F-Izcue-223/Proyecto-3-Arquitectura-de-Computadores/sim_asic/postsynth/traza_netlist.txt

TRACE cyc=0 led=0000 seg1=0111111 seg2=0111111
TRACE cyc=287 led=0101 seg1=0111111 seg2=0111111
TRACE cyc=2303 led=1010 seg1=0111111 seg2=0111111
TRACE cyc=3602 led=1111 seg1=0111111 seg2=0111111
TRACE cyc=24289 led=0100 seg1=0111111 seg2=0111111
TRACE cyc=27873 led=0100 seg1=0111111 seg2=1001111
TRACE cyc=27887 led=1111 seg1=0111111 seg2=1001111
TRACE cyc=48584 led=0100 seg1=0111111 seg2=1001111
TRACE cyc=56206 led=0100 seg1=0111111 seg2=0000111
TRACE cyc=56220 led=1111 seg1=0111111 seg2=0000111
TRACE cyc=76913 led=0100 seg1=0111111 seg2=0000111
TRACE cyc=77933 led=0100 seg1=1111001 seg2=1111001
TRACE cyc=77940 led=1111 seg1=1111001 seg2=1111001
TRACE cyc=98643 led=1000 seg1=1111001 seg2=1111001
TRACE cyc=111317 led=1000 seg1=0000110 seg2=1011011
TRACE cyc=111331 led=1111 seg1=0000110 seg2=1011011
TRACE cyc=132005 led=0001 seg1=0000110 seg2=1011011
TRACE cyc=137611 led=0001 seg1=0111111 seg2=1101101
TRACE cyc=137625 led=1111 seg1=0111111 seg2=1101101
TRACE cyc=158309 led=0010 seg1=0111111 seg2=1101101
TRACE cyc=280028 led=0010 seg1=1101111 seg2=1101111
TRACE cyc=280042 led=1111 seg1=1101111 seg2=1101111
TRACE cyc=300737 led=0100 seg1=1101111 seg2=1101111
TRACE cyc=302305 led=0100 seg1=0111111 seg2=0000110
TRACE cyc=302319 led=1111 seg1=0111111 seg2=0000110
TRACE cyc=324569 led=0100 seg1=0111111 seg2=0000110
TRACE cyc=340270 led=0100 seg1=0000110 seg2=1101101
TRACE cyc=340284 led=1111 seg1=0000110 seg2=1101101
TRACE cyc=360977 led=0100 seg1=0000110 seg2=1101101
TRACE cyc=365572 led=0100 seg1=0111111 seg2=1100110
TRACE cyc=365586 led=1111 seg1=0111111 seg2=1100110
TRACE cyc=386286 led=1000 seg1=0111111 seg2=1100110
TRACE cyc=394919 led=1000 seg1=0111111 seg2=1111111
TRACE cyc=394933 led=1111 seg1=0111111 seg2=1111111
TRACE cyc=415609 led=0001 seg1=0111111 seg2=1111111
TRACE cyc=422220 led=0001 seg1=0111111 seg2=1111101
TRACE cyc=422231 led=0000 seg1=0111111 seg2=1111101
TRACE cyc=442466 led=0000 seg1=0000110 seg2=1111111
TRACE cyc=442718 led=0101 seg1=0000110 seg2=1111111
TRACE cyc=444734 led=1010 seg1=0000110 seg2=1111111
TRACE cyc=446735 led=0101 seg1=0000110 seg2=1111111
TRACE cyc=448736 led=1010 seg1=0000110 seg2=1111111
TRACE cyc=450553 led=1010 seg1=0111111 seg2=0111111
TRACE cyc=450560 led=1111 seg1=0111111 seg2=0111111
TRACE cyc=471233 led=0001 seg1=0111111 seg2=0111111
TRACE cyc=473812 led=0001 seg1=0111111 seg2=1011011
TRACE cyc=473826 led=1111 seg1=0111111 seg2=1011011
TRACE cyc=494522 led=0100 seg1=0111111 seg2=1011011
TRACE cyc=497115 led=1111 seg1=0111111 seg2=1011011
TRACE cyc=517810 led=0100 seg1=0111111 seg2=1011011
TRACE cyc=520403 led=1111 seg1=0111111 seg2=1011011
TRACE cyc=541097 led=0100 seg1=0111111 seg2=1011011
TRACE cyc=543690 led=1111 seg1=0111111 seg2=1011011
TRACE cyc=564373 led=0010 seg1=0111111 seg2=1011011
TRACE cyc=566966 led=1111 seg1=0111111 seg2=1011011
TRACE cyc=587668 led=1000 seg1=0111111 seg2=1011011
TRACE cyc=590261 led=1111 seg1=0111111 seg2=1011011
TRACE cyc=610951 led=0100 seg1=0111111 seg2=1011011
TRACE cyc=613544 led=1111 seg1=0111111 seg2=1011011
TRACE cyc=634236 led=0010 seg1=0111111 seg2=1011011
TRACE cyc=636829 led=1111 seg1=0111111 seg2=1011011
TRACE cyc=657507 led=0001 seg1=0111111 seg2=1011011
TRACE cyc=660100 led=1111 seg1=0111111 seg2=1011011
TRACE cyc=680804 led=1000 seg1=0111111 seg2=1011011
TRACE cyc=683394 led=0000 seg1=0111111 seg2=1011011
TRACE cyc=703728 led=0101 seg1=0111111 seg2=1011011
