F-Izcue-223/Proyecto-3-Arquitectura-de-Computadores/resultados/resumen_corridas.csv

run | estado | CLOCK_PERIOD_ns | FP_CORE_UTIL | setup_WNS_ns | setup_TNS_ns | hold_WNS_ns | hold_TNS_ns | setup_violaciones | hold_violaciones | celdas | area_celdas_um2 | utilizacion_% | area_core_um2 | area_die_um2 | area_die_mm2 | costo_USD | DRC_klayout | DRC_magic | LVS_errores | antena_nets | antena_pines | potencia_W
clk_50ns | completa | 50 | 40 | -14.45718963242624 | -6568.718803703571 | 0.12987666865137543 | 0 | 2466 | 0 | 22172 | 404698 | 51.3604 | 404698.29120000004 | 435829.97362500004 | 0.43582997362500003 | 10024.089393375001 |  | 0 | 0 | 0 | 0 | 0.036392975598573685
clk_60ns | completa | 60 | 40 | -5.128534186932031 | -444.5563616391733 | 0.12987655762906983 | 0 | 323 | 0 | 22172 | 404698 | 51.361999999999995 | 404698.29120000004 | 435829.97362500004 | 0.43582997362500003 | 10024.089393375001 |  | 0 | 0 | 0 | 0 | 0.030353523790836334
clk_70ns | completa | 70 | 40 | 4.871466923291026 | 0 | 0.12987655762906983 | 0 | 0 | 0 | 22172 | 404698 | 51.361999999999995 | 404698.29120000004 | 435829.97362500004 | 0.43582997362500003 | 10024.089393375001 |  | 0 | 0 | 0 | 0 | 0.026017645373940468
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
