F-Izcue-223/Proyecto-3-Arquitectura-de-Computadores/resultados/clk_50ns/metrics.csv

Metric | Value
design__lint_error__count | 0
design__lint_timing_construct__count | 0
design__lint_warning__count | 15
design__inferred_latch__count | 0
design__instance__count | 22172
design__instance__area | 404698
design__instance_unmapped__count | 0
synthesis__check_error__count | 0
design__max_slew_violation__count__corner:nom_tt_025C_5v00 | 61
design__max_fanout_violation__count__corner:nom_tt_025C_5v00 | 70
design__max_cap_violation__count__corner:nom_tt_025C_5v00 | 6
power__internal__total | 0.024726830422878265
power__switching__total | 0.011663719080388546
power__leakage__total | 0.000002424630338282441
power__total | 0.036392975598573685
clock__skew__worst_hold__corner:nom_tt_025C_5v00 | -0.5467498830657567
clock__skew__worst_setup__corner:nom_tt_025C_5v00 | 0.3931717562807261
timing__hold__ws__corner:nom_tt_025C_5v00 | 0.3716260737661064
timing__setup__ws__corner:nom_tt_025C_5v00 | 16.08947687288801
timing__hold__tns__corner:nom_tt_025C_5v00 | 0.0
timing__setup__tns__corner:nom_tt_025C_5v00 | 0.0
timing__hold__wns__corner:nom_tt_025C_5v00 | 0
timing__setup__wns__corner:nom_tt_025C_5v00 | 0.0
timing__hold_vio__count__corner:nom_tt_025C_5v00 | 0
timing__hold_r2r__ws__corner:nom_tt_025C_5v00 | 0.371626
timing__hold_r2r_vio__count__corner:nom_tt_025C_5v00 | 0
timing__setup_vio__count__corner:nom_tt_025C_5v00 | 0
timing__setup_r2r__ws__corner:nom_tt_025C_5v00 | 16.089478
timing__setup_r2r_vio__count__corner:nom_tt_025C_5v00 | 0
design__max_slew_violation__count__corner:nom_ss_125C_4v50 | 2127
design__max_fanout_violation__count__corner:nom_ss_125C_4v50 | 70
design__max_cap_violation__count__corner:nom_ss_125C_4v50 | 6
clock__skew__worst_hold__corner:nom_ss_125C_4v50 | -0.7719962665419072
clock__skew__worst_setup__corner:nom_ss_125C_4v50 | 0.5001695865718078
timing__hold__ws__corner:nom_ss_125C_4v50 | 0.9307308520662195
timing__setup__ws__corner:nom_ss_125C_4v50 | -11.815292190169219
timing__hold__tns__corner:nom_ss_125C_4v50 | 0.0
timing__setup__tns__corner:nom_ss_125C_4v50 | -4608.067814200619
timing__hold__wns__corner:nom_ss_125C_4v50 | 0
timing__setup__wns__corner:nom_ss_125C_4v50 | -11.815292190169219
timing__hold_vio__count__corner:nom_ss_125C_4v50 | 0
timing__hold_r2r__ws__corner:nom_ss_125C_4v50 | 0.930731
timing__hold_r2r_vio__count__corner:nom_ss_125C_4v50 | 0
timing__setup_vio__count__corner:nom_ss_125C_4v50 | 830
timing__setup_r2r__ws__corner:nom_ss_125C_4v50 | -11.815292
timing__setup_r2r_vio__count__corner:nom_ss_125C_4v50 | 830
design__max_slew_violation__count__corner:nom_ff_n40C_5v50 | 0
design__max_fanout_violation__count__corner:nom_ff_n40C_5v50 | 70
design__max_cap_violation__count__corner:nom_ff_n40C_5v50 | 6
clock__skew__worst_hold__corner:nom_ff_n40C_5v50 | -0.4449608862866247
clock__skew__worst_setup__corner:nom_ff_n40C_5v50 | 0.3442841387205945
timing__hold__ws__corner:nom_ff_n40C_5v50 | 0.132141301641054
timing__setup__ws__corner:nom_ff_n40C_5v50 | 28.584779796693734
timing__hold__tns__corner:nom_ff_n40C_5v50 | 0.0
timing__setup__tns__corner:nom_ff_n40C_5v50 | 0.0
timing__hold__wns__corner:nom_ff_n40C_5v50 | 0
timing__setup__wns__corner:nom_ff_n40C_5v50 | 0.0
timing__hold_vio__count__corner:nom_ff_n40C_5v50 | 0
timing__hold_r2r__ws__corner:nom_ff_n40C_5v50 | 0.132141
timing__hold_r2r_vio__count__corner:nom_ff_n40C_5v50 | 0
timing__setup_vio__count__corner:nom_ff_n40C_5v50 | 0
timing__setup_r2r__ws__corner:nom_ff_n40C_5v50 | 28.584780
timing__setup_r2r_vio__count__corner:nom_ff_n40C_5v50 | 0
design__max_slew_violation__count | 2684
design__max_fanout_violation__count | 70
design__max_cap_violation__count | 15
clock__skew__worst_hold | -0.4385141540672078
clock__skew__worst_setup | 0.33689438303739044
timing__hold__ws | 0.12987666865137543
timing__setup__ws | -14.45718963242624
timing__hold__tns | 0.0
timing__setup__tns | -6568.718803703571
timing__hold__wns | 0
timing__setup__wns | -14.45718963242624
timing__hold_vio__count | 0
timing__hold_r2r__ws | 0.129877
timing__hold_r2r_vio__count | 0
timing__setup_vio__count | 2466
timing__setup_r2r__ws | -14.457190
timing__setup_r2r_vio__count | 2466
design__die__bbox | 0.0 0.0 651.275 669.195
design__core__bbox | 6.72 15.68 644.0 650.72
design__io | 30
design__die__area | 435830
design__core__area | 404698
design__instance__count__stdcell | 9465
design__instance__area__stdcell | 207855
design__instance__count__macros | 0
design__instance__area__macros | 0
design__instance__count__padcells | 0
design__instance__area__padcells | 0
design__instance__count__cover | 0
design__instance__area__cover | 0
design__instance__utilization | 0.513604
design__instance__utilization__stdcell | 0.513604
design__rows | 162
design__rows:GF018hv5v_mcu_sc7 | 162
design__sites | 184356
design__sites:GF018hv5v_mcu_sc7 | 184356
design__instance__count__class:tie_cell | 1
design__instance__area__class:tie_cell | 8.7808
design__instance__count__class:inverter | 295
design__instance__area__class:inverter | 2590.34
design__instance__count__class:sequential_cell | 1069
design__instance__area__class:sequential_cell | 70250.8
design__instance__count__class:multi_input_combinational_cell | 4202
design__instance__area__class:multi_input_combinational_cell | 89911
flow__warnings__count | 1
flow__errors__count | 0
flow__warnings__count:ODB-0220 | 1
flow__warnings__type_count | 1
flow__warnings__count:ORD-0039 | 1
design__instance__count__class:endcap_cell | 324
design__instance__area__class:endcap_cell | 1422.49
design__instance__count__class:tap_cell | 2626
design__instance__area__class:tap_cell | 11529.2
design__power_grid_violation__count__net:VSS | 0
design__power_grid_violation__count__net:VDD | 0
design__power_grid_violation__count | 0
flow__warnings__count:GRT-0281 | 1
timing__drv__floating__nets | 2
timing__drv__floating__pins | 0
design__instance__displacement__total | 62.2625
design__instance__displacement__mean | 0.0065
design__instance__displacement__max | 10.82
route__wirelength__estimated | 343721
design__violations | 0
design__instance__count__class:timing_repair_buffer | 792
design__instance__area__class:timing_repair_buffer | 25666.3
flow__warnings__count:RSZ-0020 | 1
flow__warnings__count:STA-1140 | 6
design__instance__count__class:clock_buffer | 107
design__instance__area__class:clock_buffer | 5830.45
design__instance__count__class:clock_inverter | 36
design__instance__area__class:clock_inverter | 588.314
design__instance__count__setup_buffer | 0
design__instance__count__hold_buffer | 7
global_route__vias | 183
global_route__wirelength | 554820
antenna__violating__nets | 0
antenna__violating__pins | 0
route__antenna_violation__count | 0
antenna_diodes_count | 10
design__instance__count__class:antenna_cell | 13
design__instance__area__class:antenna_cell | 57.0752
route__net | 6448
route__net__special | 2
route__drc_errors__iter:0 | 233
route__wirelength__iter:0 | 404524
route__drc_errors__iter:1 | 16
route__wirelength__iter:1 | 404425
route__drc_errors__iter:2 | 14
route__wirelength__iter:2 | 404420
route__drc_errors__iter:3 | 0
route__wirelength__iter:3 | 404354
route__drc_errors__iter:4 | 0
route__wirelength__iter:4 | 404287
route__drc_errors | 0
route__wirelength | 404354
route__vias | 47702
route__vias__singlecut | 47702
route__vias__multicut | 0
flow__warnings__count:DRT-0349 | 8
design__disconnected_pin__count | 0
design__critical_disconnected_pin__count | 0
route__wirelength__max | 1407.27
design__instance__count__class:fill_cell | 12707
design__instance__area__class:fill_cell | 196844
timing__unannotated_net__count__corner:nom_tt_025C_5v00 | 63
timing__unannotated_net_filtered__count__corner:nom_tt_025C_5v00 | 0
timing__unannotated_net__count__corner:nom_ss_125C_4v50 | 63
timing__unannotated_net_filtered__count__corner:nom_ss_125C_4v50 | 0
timing__unannotated_net__count__corner:nom_ff_n40C_5v50 | 63
timing__unannotated_net_filtered__count__corner:nom_ff_n40C_5v50 | 0
design__max_slew_violation__count__corner:min_tt_025C_5v00 | 16
design__max_fanout_violation__count__corner:min_tt_025C_5v00 | 70
design__max_cap_violation__count__corner:min_tt_025C_5v00 | 3
clock__skew__worst_hold__corner:min_tt_025C_5v00 | -0.5372785701748124
clock__skew__worst_setup__corner:min_tt_025C_5v00 | 0.38218737589787904
timing__hold__ws__corner:min_tt_025C_5v00 | 0.3684447295990685
timing__setup__ws__corner:min_tt_025C_5v00 | 17.364194129606773
timing__hold__tns__corner:min_tt_025C_5v00 | 0.0
timing__setup__tns__corner:min_tt_025C_5v00 | 0.0
timing__hold__wns__corner:min_tt_025C_5v00 | 0
timing__setup__wns__corner:min_tt_025C_5v00 | 0.0
timing__hold_vio__count__corner:min_tt_025C_5v00 | 0
timing__hold_r2r__ws__corner:min_tt_025C_5v00 | 0.368445
timing__hold_r2r_vio__count__corner:min_tt_025C_5v00 | 0
timing__setup_vio__count__corner:min_tt_025C_5v00 | 0
timing__setup_r2r__ws__corner:min_tt_025C_5v00 | 17.364195
timing__setup_r2r_vio__count__corner:min_tt_025C_5v00 | 0
timing__unannotated_net__count__corner:min_tt_025C_5v00 | 63
timing__unannotated_net_filtered__count__corner:min_tt_025C_5v00 | 0
design__max_slew_violation__count__corner:min_ss_125C_4v50 | 1710
design__max_fanout_violation__count__corner:min_ss_125C_4v50 | 70
design__max_cap_violation__count__corner:min_ss_125C_4v50 | 3
clock__skew__worst_hold__corner:min_ss_125C_4v50 | -0.7560401407807243
clock__skew__worst_setup__corner:min_ss_125C_4v50 | 0.4814059287465504
timing__hold__ws__corner:min_ss_125C_4v50 | 0.9253560402073941
timing__setup__ws__corner:min_ss_125C_4v50 | -9.604775913133484
timing__hold__tns__corner:min_ss_125C_4v50 | 0.0
timing__setup__tns__corner:min_ss_125C_4v50 | -2988.5528355707474
timing__hold__wns__corner:min_ss_125C_4v50 | 0
timing__setup__wns__corner:min_ss_125C_4v50 | -9.604775913133484
timing__hold_vio__count__corner:min_ss_125C_4v50 | 0
timing__hold_r2r__ws__corner:min_ss_125C_4v50 | 0.925356
timing__hold_r2r_vio__count__corner:min_ss_125C_4v50 | 0
timing__setup_vio__count__corner:min_ss_125C_4v50 | 804
timing__setup_r2r__ws__corner:min_ss_125C_4v50 | -9.604776
timing__setup_r2r_vio__count__corner:min_ss_125C_4v50 | 804
timing__unannotated_net__count__corner:min_ss_125C_4v50 | 63
timing__unannotated_net_filtered__count__corner:min_ss_125C_4v50 | 0
design__max_slew_violation__count__corner:min_ff_n40C_5v50 | 0
design__max_fanout_violation__count__corner:min_ff_n40C_5v50 | 70
design__max_cap_violation__count__corner:min_ff_n40C_5v50 | 2
clock__skew__worst_hold__corner:min_ff_n40C_5v50 | -0.4385141540672078
clock__skew__worst_setup__corner:min_ff_n40C_5v50 | 0.33689438303739044
timing__hold__ws__corner:min_ff_n40C_5v50 | 0.12987666865137543
timing__setup__ws__corner:min_ff_n40C_5v50 | 29.422921820645907
timing__hold__tns__corner:min_ff_n40C_5v50 | 0.0
timing__setup__tns__corner:min_ff_n40C_5v50 | 0.0
timing__hold__wns__corner:min_ff_n40C_5v50 | 0
timing__setup__wns__corner:min_ff_n40C_5v50 | 0.0
timing__hold_vio__count__corner:min_ff_n40C_5v50 | 0
timing__hold_r2r__ws__corner:min_ff_n40C_5v50 | 0.129877
timing__hold_r2r_vio__count__corner:min_ff_n40C_5v50 | 0
timing__setup_vio__count__corner:min_ff_n40C_5v50 | 0
timing__setup_r2r__ws__corner:min_ff_n40C_5v50 | 29.422922
timing__setup_r2r_vio__count__corner:min_ff_n40C_5v50 | 0
timing__unannotated_net__count__corner:min_ff_n40C_5v50 | 63
timing__unannotated_net_filtered__count__corner:min_ff_n40C_5v50 | 0
design__max_slew_violation__count__corner:max_tt_025C_5v00 | 107
design__max_fanout_violation__count__corner:max_tt_025C_5v00 | 70
design__max_cap_violation__count__corner:max_tt_025C_5v00 | 15
clock__skew__worst_hold__corner:max_tt_025C_5v00 | -0.5583274001162848
clock__skew__worst_setup__corner:max_tt_025C_5v00 | 0.406510642209637
timing__hold__ws__corner:max_tt_025C_5v00 | 0.37550308370004926
timing__setup__ws__corner:max_tt_025C_5v00 | 14.570059349193906
timing__hold__tns__corner:max_tt_025C_5v00 | 0.0
timing__setup__tns__corner:max_tt_025C_5v00 | 0.0
timing__hold__wns__corner:max_tt_025C_5v00 | 0
timing__setup__wns__corner:max_tt_025C_5v00 | 0.0
timing__hold_vio__count__corner:max_tt_025C_5v00 | 0
timing__hold_r2r__ws__corner:max_tt_025C_5v00 | 0.375503
timing__hold_r2r_vio__count__corner:max_tt_025C_5v00 | 0
timing__setup_vio__count__corner:max_tt_025C_5v00 | 0
timing__setup_r2r__ws__corner:max_tt_025C_5v00 | 14.570060
timing__setup_r2r_vio__count__corner:max_tt_025C_5v00 | 0
timing__unannotated_net__count__corner:max_tt_025C_5v00 | 63
timing__unannotated_net_filtered__count__corner:max_tt_025C_5v00 | 0
design__max_slew_violation__count__corner:max_ss_125C_4v50 | 2684
design__max_fanout_violation__count__corner:max_ss_125C_4v50 | 70
design__max_cap_violation__count__corner:max_ss_125C_4v50 | 15
clock__skew__worst_hold__corner:max_ss_125C_4v50 | -0.7915113233314819
clock__skew__worst_setup__corner:max_ss_125C_4v50 | 0.5228932990155986
timing__hold__ws__corner:max_ss_125C_4v50 | 0.9372953789518806
timing__setup__ws__corner:max_ss_125C_4v50 | -14.45718963242624
timing__hold__tns__corner:max_ss_125C_4v50 | 0.0
timing__setup__tns__corner:max_ss_125C_4v50 | -6568.718803703571
timing__hold__wns__corner:max_ss_125C_4v50 | 0
timing__setup__wns__corner:max_ss_125C_4v50 | -14.45718963242624
timing__hold_vio__count__corner:max_ss_125C_4v50 | 0
timing__hold_r2r__ws__corner:max_ss_125C_4v50 | 0.937295
timing__hold_r2r_vio__count__corner:max_ss_125C_4v50 | 0
timing__setup_vio__count__corner:max_ss_125C_4v50 | 832
timing__setup_r2r__ws__corner:max_ss_125C_4v50 | -14.457190
timing__setup_r2r_vio__count__corner:max_ss_125C_4v50 | 832
timing__unannotated_net__count__corner:max_ss_125C_4v50 | 63
timing__unannotated_net_filtered__count__corner:max_ss_125C_4v50 | 0
design__max_slew_violation__count__corner:max_ff_n40C_5v50 | 3
design__max_fanout_violation__count__corner:max_ff_n40C_5v50 | 70
design__max_cap_violation__count__corner:max_ff_n40C_5v50 | 14
clock__skew__worst_hold__corner:max_ff_n40C_5v50 | -0.452895705979184
clock__skew__worst_setup__corner:max_ff_n40C_5v50 | 0.3532923775748709
timing__hold__ws__corner:max_ff_n40C_5v50 | 0.13489165721774327
timing__setup__ws__corner:max_ff_n40C_5v50 | 27.58315254276052
timing__hold__tns__corner:max_ff_n40C_5v50 | 0.0
timing__setup__tns__corner:max_ff_n40C_5v50 | 0.0
timing__hold__wns__corner:max_ff_n40C_5v50 | 0
timing__setup__wns__corner:max_ff_n40C_5v50 | 0.0
timing__hold_vio__count__corner:max_ff_n40C_5v50 | 0
timing__hold_r2r__ws__corner:max_ff_n40C_5v50 | 0.134892
timing__hold_r2r_vio__count__corner:max_ff_n40C_5v50 | 0
timing__setup_vio__count__corner:max_ff_n40C_5v50 | 0
timing__setup_r2r__ws__corner:max_ff_n40C_5v50 | 27.583153
timing__setup_r2r_vio__count__corner:max_ff_n40C_5v50 | 0
timing__unannotated_net__count__corner:max_ff_n40C_5v50 | 63
timing__unannotated_net_filtered__count__corner:max_ff_n40C_5v50 | 0
timing__unannotated_net__count | 63
timing__unannotated_net_filtered__count | 0
design_powergrid__voltage__worst__net:VDD__corner:nom_tt_025C_5v00 | 4.99957
design_powergrid__drop__average__net:VDD__corner:nom_tt_025C_5v00 | 4.99993
design_powergrid__drop__worst__net:VDD__corner:nom_tt_025C_5v00 | 0.000428672
design_powergrid__voltage__worst__net:VSS__corner:nom_tt_025C_5v00 | 0.00037218
design_powergrid__drop__average__net:VSS__corner:nom_tt_025C_5v00 | 0.0000679015
design_powergrid__drop__worst__net:VSS__corner:nom_tt_025C_5v00 | 0.00037218
design_powergrid__voltage__worst | 0.00037218
design_powergrid__voltage__worst__net:VDD | 4.99957
design_powergrid__drop__worst | 0.000428672
design_powergrid__drop__worst__net:VDD | 0.000428672
design_powergrid__voltage__worst__net:VSS | 0.00037218
design_powergrid__drop__worst__net:VSS | 0.00037218
ir__voltage__worst | 5
ir__drop__avg | 0.0000694000000000000063886396173273851673002354800701141357421875
ir__drop__worst | 0.000429000000000000019338697310189445488504134118556976318359375
design__xor_difference__count | 0
magic__drc_error__count | 0
magic__illegal_overlap__count | 0
design__lvs_device_difference__count | 0
design__lvs_net_difference__count | 0
design__lvs_property_fail__count | 0
design__lvs_error__count | 0
design__lvs_unmatched_device__count | 0
design__lvs_unmatched_net__count | 0
design__lvs_unmatched_pin__count | 0
