F-Izcue-223/Proyecto-3-Arquitectura-de-Computadores/resultados/clk_60ns/metrics.csv

Metric | Value
design__lint_error__count | 0
design__lint_timing_construct__count | 0
design__lint_warning__count | 15
design__inferred_latch__count | 0
design__instance__count | 22172
design__instance__area | 404698
design__instance_unmapped__count | 0
synthesis__check_error__count | 0
design__max_slew_violation__count__corner:nom_tt_025C_5v00 | 37
design__max_fanout_violation__count__corner:nom_tt_025C_5v00 | 70
design__max_cap_violation__count__corner:nom_tt_025C_5v00 | 4
power__internal__total | 0.020613091066479683
power__switching__total | 0.009738006629049778
power__leakage__total | 0.0000024245998702099314
power__total | 0.030353523790836334
clock__skew__worst_hold__corner:nom_tt_025C_5v00 | -0.5478765374230102
clock__skew__worst_setup__corner:nom_tt_025C_5v00 | 0.4015394519428293
timing__hold__ws__corner:nom_tt_025C_5v00 | 0.3716260737661064
timing__setup__ws__corner:nom_tt_025C_5v00 | 25.759565876139742
timing__hold__tns__corner:nom_tt_025C_5v00 | 0.0
timing__setup__tns__corner:nom_tt_025C_5v00 | 0.0
timing__hold__wns__corner:nom_tt_025C_5v00 | 0
timing__setup__wns__corner:nom_tt_025C_5v00 | 0.0
timing__hold_vio__count__corner:nom_tt_025C_5v00 | 0
timing__hold_r2r__ws__corner:nom_tt_025C_5v00 | 0.371626
timing__hold_r2r_vio__count__corner:nom_tt_025C_5v00 | 0
timing__setup_vio__count__corner:nom_tt_025C_5v00 | 0
timing__setup_r2r__ws__corner:nom_tt_025C_5v00 | 25.759565
timing__setup_r2r_vio__count__corner:nom_tt_025C_5v00 | 0
design__max_slew_violation__count__corner:nom_ss_125C_4v50 | 2171
design__max_fanout_violation__count__corner:nom_ss_125C_4v50 | 70
design__max_cap_violation__count__corner:nom_ss_125C_4v50 | 4
clock__skew__worst_hold__corner:nom_ss_125C_4v50 | -0.7737251058847484
clock__skew__worst_setup__corner:nom_ss_125C_4v50 | 0.5124133484782561
timing__hold__ws__corner:nom_ss_125C_4v50 | 0.9307306300216083
timing__setup__ws__corner:nom_ss_125C_4v50 | -2.5725982072784226
timing__hold__tns__corner:nom_ss_125C_4v50 | 0.0
timing__setup__tns__corner:nom_ss_125C_4v50 | -20.61971629582071
timing__hold__wns__corner:nom_ss_125C_4v50 | 0
timing__setup__wns__corner:nom_ss_125C_4v50 | -2.5725982072784226
timing__hold_vio__count__corner:nom_ss_125C_4v50 | 0
timing__hold_r2r__ws__corner:nom_ss_125C_4v50 | 0.930731
timing__hold_r2r_vio__count__corner:nom_ss_125C_4v50 | 0
timing__setup_vio__count__corner:nom_ss_125C_4v50 | 30
timing__setup_r2r__ws__corner:nom_ss_125C_4v50 | -2.572598
timing__setup_r2r_vio__count__corner:nom_ss_125C_4v50 | 30
design__max_slew_violation__count__corner:nom_ff_n40C_5v50 | 0
design__max_fanout_violation__count__corner:nom_ff_n40C_5v50 | 70
design__max_cap_violation__count__corner:nom_ff_n40C_5v50 | 4
clock__skew__worst_hold__corner:nom_ff_n40C_5v50 | -0.44580304598577203
clock__skew__worst_setup__corner:nom_ff_n40C_5v50 | 0.35087775345032346
timing__hold__ws__corner:nom_ff_n40C_5v50 | 0.132141301641054
timing__setup__ws__corner:nom_ff_n40C_5v50 | 38.42738858106721
timing__hold__tns__corner:nom_ff_n40C_5v50 | 0.0
timing__setup__tns__corner:nom_ff_n40C_5v50 | 0.0
timing__hold__wns__corner:nom_ff_n40C_5v50 | 0
timing__setup__wns__corner:nom_ff_n40C_5v50 | 0.0
timing__hold_vio__count__corner:nom_ff_n40C_5v50 | 0
timing__hold_r2r__ws__corner:nom_ff_n40C_5v50 | 0.132141
timing__hold_r2r_vio__count__corner:nom_ff_n40C_5v50 | 0
timing__setup_vio__count__corner:nom_ff_n40C_5v50 | 0
timing__setup_r2r__ws__corner:nom_ff_n40C_5v50 | 38.427387
timing__setup_r2r_vio__count__corner:nom_ff_n40C_5v50 | 0
design__max_slew_violation__count | 2727
design__max_fanout_violation__count | 70
design__max_cap_violation__count | 14
clock__skew__worst_hold | -0.43925278546638086
clock__skew__worst_setup | 0.34277567865437414
timing__hold__ws | 0.12987655762906983
timing__setup__ws | -5.128534186932031
timing__hold__tns | 0.0
timing__setup__tns | -444.5563616391733
timing__hold__wns | 0
timing__setup__wns | -5.128534186932031
timing__hold_vio__count | 0
timing__hold_r2r__ws | 0.129877
timing__hold_r2r_vio__count | 0
timing__setup_vio__count | 323
timing__setup_r2r__ws | -5.128534
timing__setup_r2r_vio__count | 323
design__die__bbox | 0.0 0.0 651.275 669.195
design__core__bbox | 6.72 15.68 644.0 650.72
design__io | 30
design__die__area | 435830
design__core__area | 404698
design__instance__count__stdcell | 9464
design__instance__area__stdcell | 207861
design__instance__count__macros | 0
design__instance__area__macros | 0
design__instance__count__padcells | 0
design__instance__area__padcells | 0
design__instance__count__cover | 0
design__instance__area__cover | 0
design__instance__utilization | 0.51362
design__instance__utilization__stdcell | 0.51362
design__rows | 162
design__rows:GF018hv5v_mcu_sc7 | 162
design__sites | 184356
design__sites:GF018hv5v_mcu_sc7 | 184356
design__instance__count__class:tie_cell | 1
design__instance__area__class:tie_cell | 8.7808
design__instance__count__class:inverter | 295
design__instance__area__class:inverter | 2590.34
design__instance__count__class:sequential_cell | 1069
design__instance__area__class:sequential_cell | 70250.8
design__instance__count__class:multi_input_combinational_cell | 4202
design__instance__area__class:multi_input_combinational_cell | 89911
flow__warnings__count | 1
flow__errors__count | 0
flow__warnings__count:ODB-0220 | 1
flow__warnings__type_count | 1
flow__warnings__count:ORD-0039 | 1
design__instance__count__class:endcap_cell | 324
design__instance__area__class:endcap_cell | 1422.49
design__instance__count__class:tap_cell | 2626
design__instance__area__class:tap_cell | 11529.2
design__power_grid_violation__count__net:VSS | 0
design__power_grid_violation__count__net:VDD | 0
design__power_grid_violation__count | 0
flow__warnings__count:GRT-0281 | 1
timing__drv__floating__nets | 2
timing__drv__floating__pins | 0
design__instance__displacement__total | 62.2625
design__instance__displacement__mean | 0.0065
design__instance__displacement__max | 10.82
route__wirelength__estimated | 343723
design__violations | 0
design__instance__count__class:timing_repair_buffer | 792
design__instance__area__class:timing_repair_buffer | 25677.3
flow__warnings__count:RSZ-0020 | 1
flow__warnings__count:STA-1140 | 6
design__instance__count__class:clock_buffer | 107
design__instance__area__class:clock_buffer | 5830.45
design__instance__count__class:clock_inverter | 36
design__instance__area__class:clock_inverter | 588.314
design__instance__count__setup_buffer | 0
design__instance__count__hold_buffer | 7
global_route__vias | 162
global_route__wirelength | 554820
antenna__violating__nets | 0
antenna__violating__pins | 0
route__antenna_violation__count | 0
antenna_diodes_count | 9
design__instance__count__class:antenna_cell | 12
design__instance__area__class:antenna_cell | 52.6848
route__net | 6448
route__net__special | 2
route__drc_errors__iter:0 | 177
route__wirelength__iter:0 | 404815
route__drc_errors__iter:1 | 40
route__wirelength__iter:1 | 404751
route__drc_errors__iter:2 | 41
route__wirelength__iter:2 | 404744
route__drc_errors__iter:3 | 0
route__wirelength__iter:3 | 404622
route__drc_errors__iter:4 | 0
route__wirelength__iter:4 | 404539
route__drc_errors | 0
route__wirelength | 404622
route__vias | 47733
route__vias__singlecut | 47733
route__vias__multicut | 0
flow__warnings__count:DRT-0349 | 8
design__disconnected_pin__count | 0
design__critical_disconnected_pin__count | 0
route__wirelength__max | 1398.26
design__instance__count__class:fill_cell | 12708
design__instance__area__class:fill_cell | 196837
timing__unannotated_net__count__corner:nom_tt_025C_5v00 | 63
timing__unannotated_net_filtered__count__corner:nom_tt_025C_5v00 | 0
timing__unannotated_net__count__corner:nom_ss_125C_4v50 | 63
timing__unannotated_net_filtered__count__corner:nom_ss_125C_4v50 | 0
timing__unannotated_net__count__corner:nom_ff_n40C_5v50 | 63
timing__unannotated_net_filtered__count__corner:nom_ff_n40C_5v50 | 0
design__max_slew_violation__count__corner:min_tt_025C_5v00 | 9
design__max_fanout_violation__count__corner:min_tt_025C_5v00 | 70
design__max_cap_violation__count__corner:min_tt_025C_5v00 | 3
clock__skew__worst_hold__corner:min_tt_025C_5v00 | -0.5382509035272786
clock__skew__worst_setup__corner:min_tt_025C_5v00 | 0.3895407717759983
timing__hold__ws__corner:min_tt_025C_5v00 | 0.36844484062137406
timing__setup__ws__corner:min_tt_025C_5v00 | 26.988485099529832
timing__hold__tns__corner:min_tt_025C_5v00 | 0.0
timing__setup__tns__corner:min_tt_025C_5v00 | 0.0
timing__hold__wns__corner:min_tt_025C_5v00 | 0
timing__setup__wns__corner:min_tt_025C_5v00 | 0.0
timing__hold_vio__count__corner:min_tt_025C_5v00 | 0
timing__hold_r2r__ws__corner:min_tt_025C_5v00 | 0.368445
timing__hold_r2r_vio__count__corner:min_tt_025C_5v00 | 0
timing__setup_vio__count__corner:min_tt_025C_5v00 | 0
timing__setup_r2r__ws__corner:min_tt_025C_5v00 | 26.988485
timing__setup_r2r_vio__count__corner:min_tt_025C_5v00 | 0
timing__unannotated_net__count__corner:min_tt_025C_5v00 | 63
timing__unannotated_net_filtered__count__corner:min_tt_025C_5v00 | 0
design__max_slew_violation__count__corner:min_ss_125C_4v50 | 1713
design__max_fanout_violation__count__corner:min_ss_125C_4v50 | 70
design__max_cap_violation__count__corner:min_ss_125C_4v50 | 3
clock__skew__worst_hold__corner:min_ss_125C_4v50 | -0.7575111863299567
clock__skew__worst_setup__corner:min_ss_125C_4v50 | 0.49199290478649355
timing__hold__ws__corner:min_ss_125C_4v50 | 0.9253560402073941
timing__setup__ws__corner:min_ss_125C_4v50 | -0.4361950923922076
timing__hold__tns__corner:min_ss_125C_4v50 | 0.0
timing__setup__tns__corner:min_ss_125C_4v50 | -0.4361950923922076
timing__hold__wns__corner:min_ss_125C_4v50 | 0
timing__setup__wns__corner:min_ss_125C_4v50 | -0.4361950923922076
timing__hold_vio__count__corner:min_ss_125C_4v50 | 0
timing__hold_r2r__ws__corner:min_ss_125C_4v50 | 0.925356
timing__hold_r2r_vio__count__corner:min_ss_125C_4v50 | 0
timing__setup_vio__count__corner:min_ss_125C_4v50 | 1
timing__setup_r2r__ws__corner:min_ss_125C_4v50 | -0.436195
timing__setup_r2r_vio__count__corner:min_ss_125C_4v50 | 1
timing__unannotated_net__count__corner:min_ss_125C_4v50 | 63
timing__unannotated_net_filtered__count__corner:min_ss_125C_4v50 | 0
design__max_slew_violation__count__corner:min_ff_n40C_5v50 | 0
design__max_fanout_violation__count__corner:min_ff_n40C_5v50 | 70
design__max_cap_violation__count__corner:min_ff_n40C_5v50 | 2
clock__skew__worst_hold__corner:min_ff_n40C_5v50 | -0.43925278546638086
clock__skew__worst_setup__corner:min_ff_n40C_5v50 | 0.34277567865437414
timing__hold__ws__corner:min_ff_n40C_5v50 | 0.12987655762906983
timing__setup__ws__corner:min_ff_n40C_5v50 | 39.2388852516748
timing__hold__tns__corner:min_ff_n40C_5v50 | 0.0
timing__setup__tns__corner:min_ff_n40C_5v50 | 0.0
timing__hold__wns__corner:min_ff_n40C_5v50 | 0
timing__setup__wns__corner:min_ff_n40C_5v50 | 0.0
timing__hold_vio__count__corner:min_ff_n40C_5v50 | 0
timing__hold_r2r__ws__corner:min_ff_n40C_5v50 | 0.129877
timing__hold_r2r_vio__count__corner:min_ff_n40C_5v50 | 0
timing__setup_vio__count__corner:min_ff_n40C_5v50 | 0
timing__setup_r2r__ws__corner:min_ff_n40C_5v50 | 39.238884
timing__setup_r2r_vio__count__corner:min_ff_n40C_5v50 | 0
timing__unannotated_net__count__corner:min_ff_n40C_5v50 | 63
timing__unannotated_net_filtered__count__corner:min_ff_n40C_5v50 | 0
design__max_slew_violation__count__corner:max_tt_025C_5v00 | 103
design__max_fanout_violation__count__corner:max_tt_025C_5v00 | 70
design__max_cap_violation__count__corner:max_tt_025C_5v00 | 13
clock__skew__worst_hold__corner:max_tt_025C_5v00 | -0.5596909760736939
clock__skew__worst_setup__corner:max_tt_025C_5v00 | 0.4161236195625299
timing__hold__ws__corner:max_tt_025C_5v00 | 0.3755029726777437
timing__setup__ws__corner:max_tt_025C_5v00 | 24.289122511892987
timing__hold__tns__corner:max_tt_025C_5v00 | 0.0
timing__setup__tns__corner:max_tt_025C_5v00 | 0.0
timing__hold__wns__corner:max_tt_025C_5v00 | 0
timing__setup__wns__corner:max_tt_025C_5v00 | 0.0
timing__hold_vio__count__corner:max_tt_025C_5v00 | 0
timing__hold_r2r__ws__corner:max_tt_025C_5v00 | 0.375503
timing__hold_r2r_vio__count__corner:max_tt_025C_5v00 | 0
timing__setup_vio__count__corner:max_tt_025C_5v00 | 0
timing__setup_r2r__ws__corner:max_tt_025C_5v00 | 24.289122
timing__setup_r2r_vio__count__corner:max_tt_025C_5v00 | 0
timing__unannotated_net__count__corner:max_tt_025C_5v00 | 63
timing__unannotated_net_filtered__count__corner:max_tt_025C_5v00 | 0
design__max_slew_violation__count__corner:max_ss_125C_4v50 | 2727
design__max_fanout_violation__count__corner:max_ss_125C_4v50 | 70
design__max_cap_violation__count__corner:max_ss_125C_4v50 | 14
clock__skew__worst_hold__corner:max_ss_125C_4v50 | -0.793641175242159
clock__skew__worst_setup__corner:max_ss_125C_4v50 | 0.5371603314193458
timing__hold__ws__corner:max_ss_125C_4v50 | 0.9372956009964918
timing__setup__ws__corner:max_ss_125C_4v50 | -5.128534186932031
timing__hold__tns__corner:max_ss_125C_4v50 | 0.0
timing__setup__tns__corner:max_ss_125C_4v50 | -444.5563616391733
timing__hold__wns__corner:max_ss_125C_4v50 | 0
timing__setup__wns__corner:max_ss_125C_4v50 | -5.128534186932031
timing__hold_vio__count__corner:max_ss_125C_4v50 | 0
timing__hold_r2r__ws__corner:max_ss_125C_4v50 | 0.937296
timing__hold_r2r_vio__count__corner:max_ss_125C_4v50 | 0
timing__setup_vio__count__corner:max_ss_125C_4v50 | 292
timing__setup_r2r__ws__corner:max_ss_125C_4v50 | -5.128534
timing__setup_r2r_vio__count__corner:max_ss_125C_4v50 | 292
timing__unannotated_net__count__corner:max_ss_125C_4v50 | 63
timing__unannotated_net_filtered__count__corner:max_ss_125C_4v50 | 0
design__max_slew_violation__count__corner:max_ff_n40C_5v50 | 3
design__max_fanout_violation__count__corner:max_ff_n40C_5v50 | 70
design__max_cap_violation__count__corner:max_ff_n40C_5v50 | 14
clock__skew__worst_hold__corner:max_ff_n40C_5v50 | -0.45391333643233595
clock__skew__worst_setup__corner:max_ff_n40C_5v50 | 0.3607716727475434
timing__hold__ws__corner:max_ff_n40C_5v50 | 0.13489165721774327
timing__setup__ws__corner:max_ff_n40C_5v50 | 37.460617002022495
timing__hold__tns__corner:max_ff_n40C_5v50 | 0.0
timing__setup__tns__corner:max_ff_n40C_5v50 | 0.0
timing__hold__wns__corner:max_ff_n40C_5v50 | 0
timing__setup__wns__corner:max_ff_n40C_5v50 | 0.0
timing__hold_vio__count__corner:max_ff_n40C_5v50 | 0
timing__hold_r2r__ws__corner:max_ff_n40C_5v50 | 0.134892
timing__hold_r2r_vio__count__corner:max_ff_n40C_5v50 | 0
timing__setup_vio__count__corner:max_ff_n40C_5v50 | 0
timing__setup_r2r__ws__corner:max_ff_n40C_5v50 | 37.460617
timing__setup_r2r_vio__count__corner:max_ff_n40C_5v50 | 0
timing__unannotated_net__count__corner:max_ff_n40C_5v50 | 63
timing__unannotated_net_filtered__count__corner:max_ff_n40C_5v50 | 0
timing__unannotated_net__count | 63
timing__unannotated_net_filtered__count | 0
design_powergrid__voltage__worst__net:VDD__corner:nom_tt_025C_5v00 | 4.99964
design_powergrid__drop__average__net:VDD__corner:nom_tt_025C_5v00 | 4.99994
design_powergrid__drop__worst__net:VDD__corner:nom_tt_025C_5v00 | 0.000357728
design_powergrid__voltage__worst__net:VSS__corner:nom_tt_025C_5v00 | 0.000312455
design_powergrid__drop__average__net:VSS__corner:nom_tt_025C_5v00 | 0.0000566148
design_powergrid__drop__worst__net:VSS__corner:nom_tt_025C_5v00 | 0.000312455
design_powergrid__voltage__worst | 0.000312455
design_powergrid__voltage__worst__net:VDD | 4.99964
design_powergrid__drop__worst | 0.000357728
design_powergrid__drop__worst__net:VDD | 0.000357728
design_powergrid__voltage__worst__net:VSS | 0.000312455
design_powergrid__drop__worst__net:VSS | 0.000312455
ir__voltage__worst | 5
ir__drop__avg | 0.0000578999999999999979093112667527520898147486150264739990234375
ir__drop__worst | 0.0003579999999999999740589451402428267101640813052654266357421875
design__xor_difference__count | 0
magic__drc_error__count | 0
magic__illegal_overlap__count | 0
design__lvs_device_difference__count | 0
design__lvs_net_difference__count | 0
design__lvs_property_fail__count | 0
design__lvs_error__count | 0
design__lvs_unmatched_device__count | 0
design__lvs_unmatched_net__count | 0
design__lvs_unmatched_pin__count | 0
