F-Izcue-223/Proyecto-3-Arquitectura-de-Computadores/resultados/final_opt/metrics.csv

Metric | Value
design__lint_error__count | 0
design__lint_timing_construct__count | 0
design__lint_warning__count | 16
design__inferred_latch__count | 0
design__instance__count | 22373
design__instance__area | 410059
design__instance_unmapped__count | 0
synthesis__check_error__count | 0
design__max_slew_violation__count__corner:nom_tt_025C_5v00 | 21
design__max_fanout_violation__count__corner:nom_tt_025C_5v00 | 68
design__max_cap_violation__count__corner:nom_tt_025C_5v00 | 3
power__internal__total | 0.012161334976553917
power__switching__total | 0.005593948997557163
power__leakage__total | 0.0000024491146177751943
power__total | 0.017757734283804893
clock__skew__worst_hold__corner:nom_tt_025C_5v00 | -0.5456273365338103
clock__skew__worst_setup__corner:nom_tt_025C_5v00 | 0.3997306210288015
timing__hold__ws__corner:nom_tt_025C_5v00 | 0.43874238817195
timing__setup__ws__corner:nom_tt_025C_5v00 | 67.0355452344286
timing__hold__tns__corner:nom_tt_025C_5v00 | 0.0
timing__setup__tns__corner:nom_tt_025C_5v00 | 0.0
timing__hold__wns__corner:nom_tt_025C_5v00 | 0
timing__setup__wns__corner:nom_tt_025C_5v00 | 0.0
timing__hold_vio__count__corner:nom_tt_025C_5v00 | 0
timing__hold_r2r__ws__corner:nom_tt_025C_5v00 | 0.438742
timing__hold_r2r_vio__count__corner:nom_tt_025C_5v00 | 0
timing__setup_vio__count__corner:nom_tt_025C_5v00 | 0
timing__setup_r2r__ws__corner:nom_tt_025C_5v00 | 67.035545
timing__setup_r2r_vio__count__corner:nom_tt_025C_5v00 | 0
design__max_slew_violation__count__corner:nom_ss_125C_4v50 | 1989
design__max_fanout_violation__count__corner:nom_ss_125C_4v50 | 68
design__max_cap_violation__count__corner:nom_ss_125C_4v50 | 3
clock__skew__worst_hold__corner:nom_ss_125C_4v50 | -0.7700735822534841
clock__skew__worst_setup__corner:nom_ss_125C_4v50 | 0.5097331589987076
timing__hold__ws__corner:nom_ss_125C_4v50 | 1.0610728152003748
timing__setup__ws__corner:nom_ss_125C_4v50 | 39.500471567243046
timing__hold__tns__corner:nom_ss_125C_4v50 | 0.0
timing__setup__tns__corner:nom_ss_125C_4v50 | 0.0
timing__hold__wns__corner:nom_ss_125C_4v50 | 0
timing__setup__wns__corner:nom_ss_125C_4v50 | 0.0
timing__hold_vio__count__corner:nom_ss_125C_4v50 | 0
timing__hold_r2r__ws__corner:nom_ss_125C_4v50 | 1.061073
timing__hold_r2r_vio__count__corner:nom_ss_125C_4v50 | 0
timing__setup_vio__count__corner:nom_ss_125C_4v50 | 0
timing__setup_r2r__ws__corner:nom_ss_125C_4v50 | 39.500473
timing__setup_r2r_vio__count__corner:nom_ss_125C_4v50 | 0
design__max_slew_violation__count__corner:nom_ff_n40C_5v50 | 5
design__max_fanout_violation__count__corner:nom_ff_n40C_5v50 | 68
design__max_cap_violation__count__corner:nom_ff_n40C_5v50 | 3
clock__skew__worst_hold__corner:nom_ff_n40C_5v50 | -0.44481938835813445
clock__skew__worst_setup__corner:nom_ff_n40C_5v50 | 0.3502424838176663
timing__hold__ws__corner:nom_ff_n40C_5v50 | 0.173751018490876
timing__setup__ws__corner:nom_ff_n40C_5v50 | 75.32244197113886
timing__hold__tns__corner:nom_ff_n40C_5v50 | 0.0
timing__setup__tns__corner:nom_ff_n40C_5v50 | 0.0
timing__hold__wns__corner:nom_ff_n40C_5v50 | 0
timing__setup__wns__corner:nom_ff_n40C_5v50 | 0.0
timing__hold_vio__count__corner:nom_ff_n40C_5v50 | 0
timing__hold_r2r__ws__corner:nom_ff_n40C_5v50 | 0.173751
timing__hold_r2r_vio__count__corner:nom_ff_n40C_5v50 | 0
timing__setup_vio__count__corner:nom_ff_n40C_5v50 | 0
timing__setup_r2r__ws__corner:nom_ff_n40C_5v50 | 79.220230
timing__setup_r2r_vio__count__corner:nom_ff_n40C_5v50 | 0
design__max_slew_violation__count | 2426
design__max_fanout_violation__count | 68
design__max_cap_violation__count | 7
clock__skew__worst_hold | -0.4379196851318595
clock__skew__worst_setup | 0.3445345495308808
timing__hold__ws | 0.1725670766239316
timing__setup__ws | 37.21766111751278
timing__hold__tns | 0.0
timing__setup__tns | 0.0
timing__hold__wns | 0
timing__setup__wns | 0.0
timing__hold_vio__count | 0
timing__hold_r2r__ws | 0.172567
timing__hold_r2r_vio__count | 0
timing__setup_vio__count | 0
timing__setup_r2r__ws | 37.217663
timing__setup_r2r_vio__count | 0
design__die__bbox | 0.0 0.0 655.615 673.535
design__core__bbox | 6.72 15.68 648.48 654.64
design__io | 30
design__die__area | 441580
design__core__area | 410059
design__instance__count__stdcell | 9535
design__instance__area__stdcell | 209936
design__instance__count__macros | 0
design__instance__area__macros | 0
design__instance__count__padcells | 0
design__instance__area__padcells | 0
design__instance__count__cover | 0
design__instance__area__cover | 0
design__instance__utilization | 0.511965
design__instance__utilization__stdcell | 0.511965
design__rows | 163
design__rows:GF018hv5v_mcu_sc7 | 163
design__sites | 186798
design__sites:GF018hv5v_mcu_sc7 | 186798
design__instance__count__class:tie_cell | 1
design__instance__area__class:tie_cell | 8.7808
design__instance__count__class:inverter | 332
design__instance__area__class:inverter | 2915.23
design__instance__count__class:sequential_cell | 1069
design__instance__area__class:sequential_cell | 70250.8
design__instance__count__class:multi_input_combinational_cell | 4236
design__instance__area__class:multi_input_combinational_cell | 91834
flow__warnings__count | 1
flow__errors__count | 0
flow__warnings__count:ODB-0220 | 1
flow__warnings__type_count | 1
flow__warnings__count:ORD-0039 | 1
design__instance__count__class:endcap_cell | 326
design__instance__area__class:endcap_cell | 1431.27
design__instance__count__class:tap_cell | 2642
design__instance__area__class:tap_cell | 11599.4
design__power_grid_violation__count__net:VSS | 0
design__power_grid_violation__count__net:VDD | 0
design__power_grid_violation__count | 0
flow__warnings__count:GRT-0281 | 1
timing__drv__floating__nets | 2
timing__drv__floating__pins | 0
design__instance__displacement__total | 110.375
design__instance__displacement__mean | 0.0115
design__instance__displacement__max | 21.366
route__wirelength__estimated | 337235
design__violations | 0
design__instance__count__class:timing_repair_buffer | 780
design__instance__area__class:timing_repair_buffer | 25481.9
flow__warnings__count:RSZ-0020 | 1
flow__warnings__count:STA-1140 | 6
design__instance__count__class:clock_buffer | 115
design__instance__area__class:clock_buffer | 5957.77
design__instance__count__class:clock_inverter | 26
design__instance__area__class:clock_inverter | 421.478
design__instance__count__setup_buffer | 0
design__instance__count__hold_buffer | 8
global_route__vias | 116
global_route__wirelength | 546050
antenna__violating__nets | 0
antenna__violating__pins | 0
route__antenna_violation__count | 0
antenna_diodes_count | 7
design__instance__count__class:antenna_cell | 8
design__instance__area__class:antenna_cell | 35.1232
route__net | 6506
route__net__special | 2
route__drc_errors__iter:0 | 100
route__wirelength__iter:0 | 397114
route__drc_errors__iter:1 | 16
route__wirelength__iter:1 | 397075
route__drc_errors__iter:2 | 13
route__wirelength__iter:2 | 397066
route__drc_errors__iter:3 | 0
route__wirelength__iter:3 | 397054
route__drc_errors__iter:4 | 0
route__wirelength__iter:4 | 396975
route__drc_errors | 0
route__wirelength | 397054
route__vias | 47238
route__vias__singlecut | 47238
route__vias__multicut | 0
flow__warnings__count:DRT-0349 | 8
design__disconnected_pin__count | 0
design__critical_disconnected_pin__count | 0
route__wirelength__max | 1399.84
design__instance__count__class:fill_cell | 12838
design__instance__area__class:fill_cell | 200123
timing__unannotated_net__count__corner:nom_tt_025C_5v00 | 63
timing__unannotated_net_filtered__count__corner:nom_tt_025C_5v00 | 0
timing__unannotated_net__count__corner:nom_ss_125C_4v50 | 63
timing__unannotated_net_filtered__count__corner:nom_ss_125C_4v50 | 0
timing__unannotated_net__count__corner:nom_ff_n40C_5v50 | 63
timing__unannotated_net_filtered__count__corner:nom_ff_n40C_5v50 | 0
design__max_slew_violation__count__corner:min_tt_025C_5v00 | 5
design__max_fanout_violation__count__corner:min_tt_025C_5v00 | 68
design__max_cap_violation__count__corner:min_tt_025C_5v00 | 2
clock__skew__worst_hold__corner:min_tt_025C_5v00 | -0.5363433182724174
clock__skew__worst_setup__corner:min_tt_025C_5v00 | 0.3916592439003513
timing__hold__ws__corner:min_tt_025C_5v00 | 0.4370819385693599
timing__setup__ws__corner:min_tt_025C_5v00 | 68.0971458496698
timing__hold__tns__corner:min_tt_025C_5v00 | 0.0
timing__setup__tns__corner:min_tt_025C_5v00 | 0.0
timing__hold__wns__corner:min_tt_025C_5v00 | 0
timing__setup__wns__corner:min_tt_025C_5v00 | 0.0
timing__hold_vio__count__corner:min_tt_025C_5v00 | 0
timing__hold_r2r__ws__corner:min_tt_025C_5v00 | 0.437082
timing__hold_r2r_vio__count__corner:min_tt_025C_5v00 | 0
timing__setup_vio__count__corner:min_tt_025C_5v00 | 0
timing__setup_r2r__ws__corner:min_tt_025C_5v00 | 68.097145
timing__setup_r2r_vio__count__corner:min_tt_025C_5v00 | 0
timing__unannotated_net__count__corner:min_tt_025C_5v00 | 63
timing__unannotated_net_filtered__count__corner:min_tt_025C_5v00 | 0
design__max_slew_violation__count__corner:min_ss_125C_4v50 | 1590
design__max_fanout_violation__count__corner:min_ss_125C_4v50 | 68
design__max_cap_violation__count__corner:min_ss_125C_4v50 | 2
clock__skew__worst_hold__corner:min_ss_125C_4v50 | -0.7544372007324364
clock__skew__worst_setup__corner:min_ss_125C_4v50 | 0.4953738670590047
timing__hold__ws__corner:min_ss_125C_4v50 | 1.0581871234331561
timing__setup__ws__corner:min_ss_125C_4v50 | 41.41503612832358
timing__hold__tns__corner:min_ss_125C_4v50 | 0.0
timing__setup__tns__corner:min_ss_125C_4v50 | 0.0
timing__hold__wns__corner:min_ss_125C_4v50 | 0
timing__setup__wns__corner:min_ss_125C_4v50 | 0.0
timing__hold_vio__count__corner:min_ss_125C_4v50 | 0
timing__hold_r2r__ws__corner:min_ss_125C_4v50 | 1.058187
timing__hold_r2r_vio__count__corner:min_ss_125C_4v50 | 0
timing__setup_vio__count__corner:min_ss_125C_4v50 | 0
timing__setup_r2r__ws__corner:min_ss_125C_4v50 | 41.415035
timing__setup_r2r_vio__count__corner:min_ss_125C_4v50 | 0
timing__unannotated_net__count__corner:min_ss_125C_4v50 | 63
timing__unannotated_net_filtered__count__corner:min_ss_125C_4v50 | 0
design__max_slew_violation__count__corner:min_ff_n40C_5v50 | 0
design__max_fanout_violation__count__corner:min_ff_n40C_5v50 | 68
design__max_cap_violation__count__corner:min_ff_n40C_5v50 | 2
clock__skew__worst_hold__corner:min_ff_n40C_5v50 | -0.4379196851318595
clock__skew__worst_setup__corner:min_ff_n40C_5v50 | 0.3445345495308808
timing__hold__ws__corner:min_ff_n40C_5v50 | 0.1725670766239316
timing__setup__ws__corner:min_ff_n40C_5v50 | 75.4105421674374
timing__hold__tns__corner:min_ff_n40C_5v50 | 0.0
timing__setup__tns__corner:min_ff_n40C_5v50 | 0.0
timing__hold__wns__corner:min_ff_n40C_5v50 | 0
timing__setup__wns__corner:min_ff_n40C_5v50 | 0.0
timing__hold_vio__count__corner:min_ff_n40C_5v50 | 0
timing__hold_r2r__ws__corner:min_ff_n40C_5v50 | 0.172567
timing__hold_r2r_vio__count__corner:min_ff_n40C_5v50 | 0
timing__setup_vio__count__corner:min_ff_n40C_5v50 | 0
timing__setup_r2r__ws__corner:min_ff_n40C_5v50 | 79.916748
timing__setup_r2r_vio__count__corner:min_ff_n40C_5v50 | 0
timing__unannotated_net__count__corner:min_ff_n40C_5v50 | 63
timing__unannotated_net_filtered__count__corner:min_ff_n40C_5v50 | 0
design__max_slew_violation__count__corner:max_tt_025C_5v00 | 41
design__max_fanout_violation__count__corner:max_tt_025C_5v00 | 68
design__max_cap_violation__count__corner:max_tt_025C_5v00 | 7
clock__skew__worst_hold__corner:max_tt_025C_5v00 | -0.5574481034559134
clock__skew__worst_setup__corner:max_tt_025C_5v00 | 0.4100282729403447
timing__hold__ws__corner:max_tt_025C_5v00 | 0.44088667298235557
timing__setup__ws__corner:max_tt_025C_5v00 | 65.75315766866036
timing__hold__tns__corner:max_tt_025C_5v00 | 0.0
timing__setup__tns__corner:max_tt_025C_5v00 | 0.0
timing__hold__wns__corner:max_tt_025C_5v00 | 0
timing__setup__wns__corner:max_tt_025C_5v00 | 0.0
timing__hold_vio__count__corner:max_tt_025C_5v00 | 0
timing__hold_r2r__ws__corner:max_tt_025C_5v00 | 0.440887
timing__hold_r2r_vio__count__corner:max_tt_025C_5v00 | 0
timing__setup_vio__count__corner:max_tt_025C_5v00 | 0
timing__setup_r2r__ws__corner:max_tt_025C_5v00 | 65.753159
timing__setup_r2r_vio__count__corner:max_tt_025C_5v00 | 0
timing__unannotated_net__count__corner:max_tt_025C_5v00 | 63
timing__unannotated_net_filtered__count__corner:max_tt_025C_5v00 | 0
design__max_slew_violation__count__corner:max_ss_125C_4v50 | 2426
design__max_fanout_violation__count__corner:max_ss_125C_4v50 | 68
design__max_cap_violation__count__corner:max_ss_125C_4v50 | 7
clock__skew__worst_hold__corner:max_ss_125C_4v50 | -0.7888860898932065
clock__skew__worst_setup__corner:max_ss_125C_4v50 | 0.5272421537483517
timing__hold__ws__corner:max_ss_125C_4v50 | 1.0648089378285082
timing__setup__ws__corner:max_ss_125C_4v50 | 37.21766111751278
timing__hold__tns__corner:max_ss_125C_4v50 | 0.0
timing__setup__tns__corner:max_ss_125C_4v50 | 0.0
timing__hold__wns__corner:max_ss_125C_4v50 | 0
timing__setup__wns__corner:max_ss_125C_4v50 | 0.0
timing__hold_vio__count__corner:max_ss_125C_4v50 | 0
timing__hold_r2r__ws__corner:max_ss_125C_4v50 | 1.064809
timing__hold_r2r_vio__count__corner:max_ss_125C_4v50 | 0
timing__setup_vio__count__corner:max_ss_125C_4v50 | 0
timing__setup_r2r__ws__corner:max_ss_125C_4v50 | 37.217663
timing__setup_r2r_vio__count__corner:max_ss_125C_4v50 | 0
timing__unannotated_net__count__corner:max_ss_125C_4v50 | 63
timing__unannotated_net_filtered__count__corner:max_ss_125C_4v50 | 0
design__max_slew_violation__count__corner:max_ff_n40C_5v50 | 5
design__max_fanout_violation__count__corner:max_ff_n40C_5v50 | 68
design__max_cap_violation__count__corner:max_ff_n40C_5v50 | 7
clock__skew__worst_hold__corner:max_ff_n40C_5v50 | -0.4552345573801578
clock__skew__worst_setup__corner:max_ff_n40C_5v50 | 0.3571615604362688
timing__hold__ws__corner:max_ff_n40C_5v50 | 0.17528035075054965
timing__setup__ws__corner:max_ff_n40C_5v50 | 75.21798508060053
timing__hold__tns__corner:max_ff_n40C_5v50 | 0.0
timing__setup__tns__corner:max_ff_n40C_5v50 | 0.0
timing__hold__wns__corner:max_ff_n40C_5v50 | 0
timing__setup__wns__corner:max_ff_n40C_5v50 | 0.0
timing__hold_vio__count__corner:max_ff_n40C_5v50 | 0
timing__hold_r2r__ws__corner:max_ff_n40C_5v50 | 0.175280
timing__hold_r2r_vio__count__corner:max_ff_n40C_5v50 | 0
timing__setup_vio__count__corner:max_ff_n40C_5v50 | 0
timing__setup_r2r__ws__corner:max_ff_n40C_5v50 | 78.382729
timing__setup_r2r_vio__count__corner:max_ff_n40C_5v50 | 0
timing__unannotated_net__count__corner:max_ff_n40C_5v50 | 63
timing__unannotated_net_filtered__count__corner:max_ff_n40C_5v50 | 0
timing__unannotated_net__count | 63
timing__unannotated_net_filtered__count | 0
design_powergrid__voltage__worst__net:VDD__corner:nom_tt_025C_5v00 | 4.99978
design_powergrid__drop__average__net:VDD__corner:nom_tt_025C_5v00 | 4.99997
design_powergrid__drop__worst__net:VDD__corner:nom_tt_025C_5v00 | 0.000220738
design_powergrid__voltage__worst__net:VSS__corner:nom_tt_025C_5v00 | 0.000181206
design_powergrid__drop__average__net:VSS__corner:nom_tt_025C_5v00 | 0.0000330837
design_powergrid__drop__worst__net:VSS__corner:nom_tt_025C_5v00 | 0.000181206
design_powergrid__voltage__worst | 0.000181206
design_powergrid__voltage__worst__net:VDD | 4.99978
design_powergrid__drop__worst | 0.000220738
design_powergrid__drop__worst__net:VDD | 0.000220738
design_powergrid__voltage__worst__net:VSS | 0.000181206
design_powergrid__drop__worst__net:VSS | 0.000181206
ir__voltage__worst | 5
ir__drop__avg | 0.0000335999999999999967854706628411776136999833397567272186279296875
ir__drop__worst | 0.0002210000000000000050341675272846941879834048449993133544921875
design__xor_difference__count | 0
magic__drc_error__count | 0
magic__illegal_overlap__count | 0
design__lvs_device_difference__count | 0
design__lvs_net_difference__count | 0
design__lvs_property_fail__count | 0
design__lvs_error__count | 0
design__lvs_unmatched_device__count | 0
design__lvs_unmatched_net__count | 0
design__lvs_unmatched_pin__count | 0
