F-Izcue-223/Proyecto-3-Arquitectura-de-Computadores/resultados/sim_corto/metrics.csv

Metric | Value
design__lint_error__count | 0
design__lint_timing_construct__count | 0
design__lint_warning__count | 16
design__inferred_latch__count | 0
design__instance__count | 5644
design__instance__area | 164585.120000
design__instance_unmapped__count | 0
synthesis__check_error__count | 0
