F-Izcue-223/Proyecto-3-Arquitectura-de-Computadores/resultados/util_30/metrics.csv

Metric | Value
design__lint_error__count | 0
design__lint_timing_construct__count | 0
design__lint_warning__count | 15
design__inferred_latch__count | 0
design__instance__count | 26581
design__instance__area | 539811
design__instance_unmapped__count | 0
synthesis__check_error__count | 0
design__max_slew_violation__count__corner:nom_tt_025C_5v00 | 19
design__max_fanout_violation__count__corner:nom_tt_025C_5v00 | 74
design__max_cap_violation__count__corner:nom_tt_025C_5v00 | 3
power__internal__total | 0.0125194126740098
power__switching__total | 0.005880240350961685
power__leakage__total | 0.000002693850319701596
power__total | 0.0184023454785347
clock__skew__worst_hold__corner:nom_tt_025C_5v00 | -0.5688966125873315
clock__skew__worst_setup__corner:nom_tt_025C_5v00 | 0.4297054222960989
timing__hold__ws__corner:nom_tt_025C_5v00 | 0.4604310396606093
timing__setup__ws__corner:nom_tt_025C_5v00 | 69.11925449854056
timing__hold__tns__corner:nom_tt_025C_5v00 | 0.0
timing__setup__tns__corner:nom_tt_025C_5v00 | 0.0
timing__hold__wns__corner:nom_tt_025C_5v00 | 0
timing__setup__wns__corner:nom_tt_025C_5v00 | 0.0
timing__hold_vio__count__corner:nom_tt_025C_5v00 | 0
timing__hold_r2r__ws__corner:nom_tt_025C_5v00 | 0.460431
timing__hold_r2r_vio__count__corner:nom_tt_025C_5v00 | 0
timing__setup_vio__count__corner:nom_tt_025C_5v00 | 0
timing__setup_r2r__ws__corner:nom_tt_025C_5v00 | 69.119255
timing__setup_r2r_vio__count__corner:nom_tt_025C_5v00 | 0
design__max_slew_violation__count__corner:nom_ss_125C_4v50 | 2141
design__max_fanout_violation__count__corner:nom_ss_125C_4v50 | 74
design__max_cap_violation__count__corner:nom_ss_125C_4v50 | 3
clock__skew__worst_hold__corner:nom_ss_125C_4v50 | -0.8115182089348754
clock__skew__worst_setup__corner:nom_ss_125C_4v50 | 0.566615215229507
timing__hold__ws__corner:nom_ss_125C_4v50 | 1.1046801563949014
timing__setup__ws__corner:nom_ss_125C_4v50 | 43.51667949159334
timing__hold__tns__corner:nom_ss_125C_4v50 | 0.0
timing__setup__tns__corner:nom_ss_125C_4v50 | 0.0
timing__hold__wns__corner:nom_ss_125C_4v50 | 0
timing__setup__wns__corner:nom_ss_125C_4v50 | 0.0
timing__hold_vio__count__corner:nom_ss_125C_4v50 | 0
timing__hold_r2r__ws__corner:nom_ss_125C_4v50 | 1.104680
timing__hold_r2r_vio__count__corner:nom_ss_125C_4v50 | 0
timing__setup_vio__count__corner:nom_ss_125C_4v50 | 0
timing__setup_r2r__ws__corner:nom_ss_125C_4v50 | 43.516678
timing__setup_r2r_vio__count__corner:nom_ss_125C_4v50 | 0
design__max_slew_violation__count__corner:nom_ff_n40C_5v50 | 0
design__max_fanout_violation__count__corner:nom_ff_n40C_5v50 | 74
design__max_cap_violation__count__corner:nom_ff_n40C_5v50 | 3
clock__skew__worst_hold__corner:nom_ff_n40C_5v50 | -0.45802421485303035
clock__skew__worst_setup__corner:nom_ff_n40C_5v50 | 0.36723866653773274
timing__hold__ws__corner:nom_ff_n40C_5v50 | 0.18244384297493593
timing__setup__ws__corner:nom_ff_n40C_5v50 | 75.41521753877093
timing__hold__tns__corner:nom_ff_n40C_5v50 | 0.0
timing__setup__tns__corner:nom_ff_n40C_5v50 | 0.0
timing__hold__wns__corner:nom_ff_n40C_5v50 | 0
timing__setup__wns__corner:nom_ff_n40C_5v50 | 0.0
timing__hold_vio__count__corner:nom_ff_n40C_5v50 | 0
timing__hold_r2r__ws__corner:nom_ff_n40C_5v50 | 0.182444
timing__hold_r2r_vio__count__corner:nom_ff_n40C_5v50 | 0
timing__setup_vio__count__corner:nom_ff_n40C_5v50 | 0
timing__setup_r2r__ws__corner:nom_ff_n40C_5v50 | 80.541466
timing__setup_r2r_vio__count__corner:nom_ff_n40C_5v50 | 0
design__max_slew_violation__count | 2657
design__max_fanout_violation__count | 74
design__max_cap_violation__count | 5
clock__skew__worst_hold | -0.4465023754887618
clock__skew__worst_setup | 0.35819473401220514
timing__hold__ws | 0.17165458429418512
timing__setup__ws | 41.738318871382766
timing__hold__tns | 0.0
timing__setup__tns | 0.0
timing__hold__wns | 0
timing__setup__wns | 0.0
timing__hold_vio__count | 0
timing__hold_r2r__ws | 0.171655
timing__hold_r2r_vio__count | 0
timing__setup_vio__count | 0
timing__setup_r2r__ws | 41.738319
timing__setup_r2r_vio__count | 0
design__die__bbox | 0.0 0.0 749.95 767.87
design__core__bbox | 6.72 15.68 743.12 748.72
design__io | 30
design__die__area | 575864
design__core__area | 539811
design__instance__count__stdcell | 10403
design__instance__area__stdcell | 212401
design__instance__count__macros | 0
design__instance__area__macros | 0
design__instance__count__padcells | 0
design__instance__area__padcells | 0
design__instance__count__cover | 0
design__instance__area__cover | 0
design__instance__utilization | 0.393473
design__instance__utilization__stdcell | 0.393473
design__rows | 187
design__rows:GF018hv5v_mcu_sc7 | 187
design__sites | 245905
design__sites:GF018hv5v_mcu_sc7 | 245905
design__instance__count__class:tie_cell | 1
design__instance__area__class:tie_cell | 8.7808
design__instance__count__class:inverter | 295
design__instance__area__class:inverter | 2590.34
design__instance__count__class:sequential_cell | 1069
design__instance__area__class:sequential_cell | 70250.8
design__instance__count__class:multi_input_combinational_cell | 4202
design__instance__area__class:multi_input_combinational_cell | 89911
flow__warnings__count | 1
flow__errors__count | 0
flow__warnings__count:ODB-0220 | 1
flow__warnings__type_count | 1
flow__warnings__count:ORD-0039 | 1
design__instance__count__class:endcap_cell | 374
design__instance__area__class:endcap_cell | 1642.01
design__instance__count__class:tap_cell | 3498
design__instance__area__class:tap_cell | 15357.6
design__power_grid_violation__count__net:VSS | 0
design__power_grid_violation__count__net:VDD | 0
design__power_grid_violation__count | 0
flow__warnings__count:GRT-0281 | 1
timing__drv__floating__nets | 2
timing__drv__floating__pins | 0
design__instance__displacement__total | 45.7145
design__instance__displacement__mean | 0.004
design__instance__displacement__max | 22.481
route__wirelength__estimated | 366841
design__violations | 0
design__instance__count__class:timing_repair_buffer | 805
design__instance__area__class:timing_repair_buffer | 25879.2
flow__warnings__count:RSZ-0020 | 1
flow__warnings__count:STA-1140 | 6
design__instance__count__class:clock_buffer | 132
design__instance__area__class:clock_buffer | 6361.69
design__instance__count__class:clock_inverter | 21
design__instance__area__class:clock_inverter | 373.184
design__instance__count__setup_buffer | 0
design__instance__count__hold_buffer | 7
global_route__vias | 23
global_route__wirelength | 578104
antenna__violating__nets | 1
antenna__violating__pins | 1
route__antenna_violation__count | 1
antenna_diodes_count | 6
route__net | 6472
route__net__special | 2
route__drc_errors__iter:0 | 0
route__wirelength__iter:0 | 420053
route__drc_errors__iter:1 | 0
route__wirelength__iter:1 | 420061
route__drc_errors__iter:2 | 0
route__wirelength__iter:2 | 420053
route__drc_errors__iter:3 | 1
route__wirelength__iter:3 | 420010
route__drc_errors__iter:4 | 0
route__wirelength__iter:4 | 420008
route__drc_errors | 0
route__wirelength | 420053
route__vias | 45371
route__vias__singlecut | 45371
route__vias__multicut | 0
design__instance__count__class:antenna_cell | 6
design__instance__area__class:antenna_cell | 26.3424
flow__warnings__count:DRT-0349 | 8
design__disconnected_pin__count | 0
design__critical_disconnected_pin__count | 0
route__wirelength__max | 1699.33
design__instance__count__class:fill_cell | 16178
design__instance__area__class:fill_cell | 327410
timing__unannotated_net__count__corner:nom_tt_025C_5v00 | 62
timing__unannotated_net_filtered__count__corner:nom_tt_025C_5v00 | 0
timing__unannotated_net__count__corner:nom_ss_125C_4v50 | 62
timing__unannotated_net_filtered__count__corner:nom_ss_125C_4v50 | 0
timing__unannotated_net__count__corner:nom_ff_n40C_5v50 | 62
timing__unannotated_net_filtered__count__corner:nom_ff_n40C_5v50 | 0
design__max_slew_violation__count__corner:min_tt_025C_5v00 | 15
design__max_fanout_violation__count__corner:min_tt_025C_5v00 | 74
design__max_cap_violation__count__corner:min_tt_025C_5v00 | 1
clock__skew__worst_hold__corner:min_tt_025C_5v00 | -0.5501829147995952
clock__skew__worst_setup__corner:min_tt_025C_5v00 | 0.4156134165571339
timing__hold__ws__corner:min_tt_025C_5v00 | 0.4419207347367367
timing__setup__ws__corner:min_tt_025C_5v00 | 69.97318478252784
timing__hold__tns__corner:min_tt_025C_5v00 | 0.0
timing__setup__tns__corner:min_tt_025C_5v00 | 0.0
timing__hold__wns__corner:min_tt_025C_5v00 | 0
timing__setup__wns__corner:min_tt_025C_5v00 | 0.0
timing__hold_vio__count__corner:min_tt_025C_5v00 | 0
timing__hold_r2r__ws__corner:min_tt_025C_5v00 | 0.441921
timing__hold_r2r_vio__count__corner:min_tt_025C_5v00 | 0
timing__setup_vio__count__corner:min_tt_025C_5v00 | 0
timing__setup_r2r__ws__corner:min_tt_025C_5v00 | 69.973183
timing__setup_r2r_vio__count__corner:min_tt_025C_5v00 | 0
timing__unannotated_net__count__corner:min_tt_025C_5v00 | 62
timing__unannotated_net_filtered__count__corner:min_tt_025C_5v00 | 0
design__max_slew_violation__count__corner:min_ss_125C_4v50 | 1615
design__max_fanout_violation__count__corner:min_ss_125C_4v50 | 74
design__max_cap_violation__count__corner:min_ss_125C_4v50 | 1
clock__skew__worst_hold__corner:min_ss_125C_4v50 | -0.7792890997523203
clock__skew__worst_setup__corner:min_ss_125C_4v50 | 0.5426141911597601
timing__hold__ws__corner:min_ss_125C_4v50 | 1.0698195965249575
timing__setup__ws__corner:min_ss_125C_4v50 | 44.989250931393876
timing__hold__tns__corner:min_ss_125C_4v50 | 0.0
timing__setup__tns__corner:min_ss_125C_4v50 | 0.0
timing__hold__wns__corner:min_ss_125C_4v50 | 0
timing__setup__wns__corner:min_ss_125C_4v50 | 0.0
timing__hold_vio__count__corner:min_ss_125C_4v50 | 0
timing__hold_r2r__ws__corner:min_ss_125C_4v50 | 1.069820
timing__hold_r2r_vio__count__corner:min_ss_125C_4v50 | 0
timing__setup_vio__count__corner:min_ss_125C_4v50 | 0
timing__setup_r2r__ws__corner:min_ss_125C_4v50 | 44.989250
timing__setup_r2r_vio__count__corner:min_ss_125C_4v50 | 0
timing__unannotated_net__count__corner:min_ss_125C_4v50 | 62
timing__unannotated_net_filtered__count__corner:min_ss_125C_4v50 | 0
design__max_slew_violation__count__corner:min_ff_n40C_5v50 | 0
design__max_fanout_violation__count__corner:min_ff_n40C_5v50 | 74
design__max_cap_violation__count__corner:min_ff_n40C_5v50 | 1
clock__skew__worst_hold__corner:min_ff_n40C_5v50 | -0.4465023754887618
clock__skew__worst_setup__corner:min_ff_n40C_5v50 | 0.35819473401220514
timing__hold__ws__corner:min_ff_n40C_5v50 | 0.17165458429418512
timing__setup__ws__corner:min_ff_n40C_5v50 | 75.48655603145883
timing__hold__tns__corner:min_ff_n40C_5v50 | 0.0
timing__setup__tns__corner:min_ff_n40C_5v50 | 0.0
timing__hold__wns__corner:min_ff_n40C_5v50 | 0
timing__setup__wns__corner:min_ff_n40C_5v50 | 0.0
timing__hold_vio__count__corner:min_ff_n40C_5v50 | 0
timing__hold_r2r__ws__corner:min_ff_n40C_5v50 | 0.171655
timing__hold_r2r_vio__count__corner:min_ff_n40C_5v50 | 0
timing__setup_vio__count__corner:min_ff_n40C_5v50 | 0
timing__setup_r2r__ws__corner:min_ff_n40C_5v50 | 81.105080
timing__setup_r2r_vio__count__corner:min_ff_n40C_5v50 | 0
timing__unannotated_net__count__corner:min_ff_n40C_5v50 | 62
timing__unannotated_net_filtered__count__corner:min_ff_n40C_5v50 | 0
design__max_slew_violation__count__corner:max_tt_025C_5v00 | 49
design__max_fanout_violation__count__corner:max_tt_025C_5v00 | 74
design__max_cap_violation__count__corner:max_tt_025C_5v00 | 4
clock__skew__worst_hold__corner:max_tt_025C_5v00 | -0.5907011713630397
clock__skew__worst_setup__corner:max_tt_025C_5v00 | 0.44538388127097
timing__hold__ws__corner:max_tt_025C_5v00 | 0.4791087662213303
timing__setup__ws__corner:max_tt_025C_5v00 | 68.08667955487606
timing__hold__tns__corner:max_tt_025C_5v00 | 0.0
timing__setup__tns__corner:max_tt_025C_5v00 | 0.0
timing__hold__wns__corner:max_tt_025C_5v00 | 0
timing__setup__wns__corner:max_tt_025C_5v00 | 0.0
timing__hold_vio__count__corner:max_tt_025C_5v00 | 0
timing__hold_r2r__ws__corner:max_tt_025C_5v00 | 0.479109
timing__hold_r2r_vio__count__corner:max_tt_025C_5v00 | 0
timing__setup_vio__count__corner:max_tt_025C_5v00 | 0
timing__setup_r2r__ws__corner:max_tt_025C_5v00 | 68.086678
timing__setup_r2r_vio__count__corner:max_tt_025C_5v00 | 0
timing__unannotated_net__count__corner:max_tt_025C_5v00 | 62
timing__unannotated_net_filtered__count__corner:max_tt_025C_5v00 | 0
design__max_slew_violation__count__corner:max_ss_125C_4v50 | 2657
design__max_fanout_violation__count__corner:max_ss_125C_4v50 | 74
design__max_cap_violation__count__corner:max_ss_125C_4v50 | 5
clock__skew__worst_hold__corner:max_ss_125C_4v50 | -0.8484667653062844
clock__skew__worst_setup__corner:max_ss_125C_4v50 | 0.5933741443927241
timing__hold__ws__corner:max_ss_125C_4v50 | 1.1304952849381922
timing__setup__ws__corner:max_ss_125C_4v50 | 41.738318871382766
timing__hold__tns__corner:max_ss_125C_4v50 | 0.0
timing__setup__tns__corner:max_ss_125C_4v50 | 0.0
timing__hold__wns__corner:max_ss_125C_4v50 | 0
timing__setup__wns__corner:max_ss_125C_4v50 | 0.0
timing__hold_vio__count__corner:max_ss_125C_4v50 | 0
timing__hold_r2r__ws__corner:max_ss_125C_4v50 | 1.130495
timing__hold_r2r_vio__count__corner:max_ss_125C_4v50 | 0
timing__setup_vio__count__corner:max_ss_125C_4v50 | 0
timing__setup_r2r__ws__corner:max_ss_125C_4v50 | 41.738319
timing__setup_r2r_vio__count__corner:max_ss_125C_4v50 | 0
timing__unannotated_net__count__corner:max_ss_125C_4v50 | 62
timing__unannotated_net_filtered__count__corner:max_ss_125C_4v50 | 0
design__max_slew_violation__count__corner:max_ff_n40C_5v50 | 0
design__max_fanout_violation__count__corner:max_ff_n40C_5v50 | 74
design__max_cap_violation__count__corner:max_ff_n40C_5v50 | 3
clock__skew__worst_hold__corner:max_ff_n40C_5v50 | -0.4729939351845119
clock__skew__worst_setup__corner:max_ff_n40C_5v50 | 0.37787807286149666
timing__hold__ws__corner:max_ff_n40C_5v50 | 0.19505697609212364
timing__setup__ws__corner:max_ff_n40C_5v50 | 75.33096137878157
timing__hold__tns__corner:max_ff_n40C_5v50 | 0.0
timing__setup__tns__corner:max_ff_n40C_5v50 | 0.0
timing__hold__wns__corner:max_ff_n40C_5v50 | 0
timing__setup__wns__corner:max_ff_n40C_5v50 | 0.0
timing__hold_vio__count__corner:max_ff_n40C_5v50 | 0
timing__hold_r2r__ws__corner:max_ff_n40C_5v50 | 0.195057
timing__hold_r2r_vio__count__corner:max_ff_n40C_5v50 | 0
timing__setup_vio__count__corner:max_ff_n40C_5v50 | 0
timing__setup_r2r__ws__corner:max_ff_n40C_5v50 | 79.859726
timing__setup_r2r_vio__count__corner:max_ff_n40C_5v50 | 0
timing__unannotated_net__count__corner:max_ff_n40C_5v50 | 62
timing__unannotated_net_filtered__count__corner:max_ff_n40C_5v50 | 0
timing__unannotated_net__count | 62
timing__unannotated_net_filtered__count | 0
design_powergrid__voltage__worst__net:VDD__corner:nom_tt_025C_5v00 | 4.99964
design_powergrid__drop__average__net:VDD__corner:nom_tt_025C_5v00 | 4.99997
design_powergrid__drop__worst__net:VDD__corner:nom_tt_025C_5v00 | 0.000356902
design_powergrid__voltage__worst__net:VSS__corner:nom_tt_025C_5v00 | 0.00024667
design_powergrid__drop__average__net:VSS__corner:nom_tt_025C_5v00 | 0.0000309019
design_powergrid__drop__worst__net:VSS__corner:nom_tt_025C_5v00 | 0.00024667
design_powergrid__voltage__worst | 0.00024667
design_powergrid__voltage__worst__net:VDD | 4.99964
design_powergrid__drop__worst | 0.000356902
design_powergrid__drop__worst__net:VDD | 0.000356902
design_powergrid__voltage__worst__net:VSS | 0.00024667
design_powergrid__drop__worst__net:VSS | 0.00024667
ir__voltage__worst | 5
ir__drop__avg | 0.000031900000000000002897508621924060889796237461268901824951171875
ir__drop__worst | 0.000357000000000000003962108419131027403636835515499114990234375
design__xor_difference__count | 0
magic__drc_error__count | 0
magic__illegal_overlap__count | 0
design__lvs_device_difference__count | 0
design__lvs_net_difference__count | 0
design__lvs_property_fail__count | 0
design__lvs_error__count | 0
design__lvs_unmatched_device__count | 0
design__lvs_unmatched_net__count | 0
design__lvs_unmatched_pin__count | 0
