F-Izcue-223/Proyecto-3-Arquitectura-de-Computadores/resultados/util_50/metrics.csv

Metric | Value
design__lint_error__count | 0
design__lint_timing_construct__count | 0
design__lint_warning__count | 15
design__inferred_latch__count | 0
design__instance__count | 18645
design__instance__area | 324033
design__instance_unmapped__count | 0
synthesis__check_error__count | 0
design__max_slew_violation__count__corner:nom_tt_025C_5v00 | 0
design__max_fanout_violation__count__corner:nom_tt_025C_5v00 | 66
design__max_cap_violation__count__corner:nom_tt_025C_5v00 | 2
power__internal__total | 0.01226180698722601
power__switching__total | 0.005654543172568083
power__leakage__total | 0.000002210566435678629
power__total | 0.017918560653924942
clock__skew__worst_hold__corner:nom_tt_025C_5v00 | -0.5405572809038637
clock__skew__worst_setup__corner:nom_tt_025C_5v00 | 0.4021683933040671
timing__hold__ws__corner:nom_tt_025C_5v00 | 0.3592312105017331
timing__setup__ws__corner:nom_tt_025C_5v00 | 67.91521137703297
timing__hold__tns__corner:nom_tt_025C_5v00 | 0.0
timing__setup__tns__corner:nom_tt_025C_5v00 | 0.0
timing__hold__wns__corner:nom_tt_025C_5v00 | 0
timing__setup__wns__corner:nom_tt_025C_5v00 | 0.0
timing__hold_vio__count__corner:nom_tt_025C_5v00 | 0
timing__hold_r2r__ws__corner:nom_tt_025C_5v00 | 0.359231
timing__hold_r2r_vio__count__corner:nom_tt_025C_5v00 | 0
timing__setup_vio__count__corner:nom_tt_025C_5v00 | 0
timing__setup_r2r__ws__corner:nom_tt_025C_5v00 | 67.915215
timing__setup_r2r_vio__count__corner:nom_tt_025C_5v00 | 0
design__max_slew_violation__count__corner:nom_ss_125C_4v50 | 1692
design__max_fanout_violation__count__corner:nom_ss_125C_4v50 | 66
design__max_cap_violation__count__corner:nom_ss_125C_4v50 | 2
clock__skew__worst_hold__corner:nom_ss_125C_4v50 | -0.7610234879899955
clock__skew__worst_setup__corner:nom_ss_125C_4v50 | 0.5185950704542001
timing__hold__ws__corner:nom_ss_125C_4v50 | 0.9087877374531195
timing__setup__ws__corner:nom_ss_125C_4v50 | 40.84415055113138
timing__hold__tns__corner:nom_ss_125C_4v50 | 0.0
timing__setup__tns__corner:nom_ss_125C_4v50 | 0.0
timing__hold__wns__corner:nom_ss_125C_4v50 | 0
timing__setup__wns__corner:nom_ss_125C_4v50 | 0.0
timing__hold_vio__count__corner:nom_ss_125C_4v50 | 0
timing__hold_r2r__ws__corner:nom_ss_125C_4v50 | 0.908788
timing__hold_r2r_vio__count__corner:nom_ss_125C_4v50 | 0
timing__setup_vio__count__corner:nom_ss_125C_4v50 | 0
timing__setup_r2r__ws__corner:nom_ss_125C_4v50 | 40.844151
timing__setup_r2r_vio__count__corner:nom_ss_125C_4v50 | 0
design__max_slew_violation__count__corner:nom_ff_n40C_5v50 | 0
design__max_fanout_violation__count__corner:nom_ff_n40C_5v50 | 66
design__max_cap_violation__count__corner:nom_ff_n40C_5v50 | 2
clock__skew__worst_hold__corner:nom_ff_n40C_5v50 | -0.4410018308688417
clock__skew__worst_setup__corner:nom_ff_n40C_5v50 | 0.348992039589666
timing__hold__ws__corner:nom_ff_n40C_5v50 | 0.12398316058077545
timing__setup__ws__corner:nom_ff_n40C_5v50 | 75.48318095336852
timing__hold__tns__corner:nom_ff_n40C_5v50 | 0.0
timing__setup__tns__corner:nom_ff_n40C_5v50 | 0.0
timing__hold__wns__corner:nom_ff_n40C_5v50 | 0
timing__setup__wns__corner:nom_ff_n40C_5v50 | 0.0
timing__hold_vio__count__corner:nom_ff_n40C_5v50 | 0
timing__hold_r2r__ws__corner:nom_ff_n40C_5v50 | 0.123983
timing__hold_r2r_vio__count__corner:nom_ff_n40C_5v50 | 0
timing__setup_vio__count__corner:nom_ff_n40C_5v50 | 0
timing__setup_r2r__ws__corner:nom_ff_n40C_5v50 | 79.990318
timing__setup_r2r_vio__count__corner:nom_ff_n40C_5v50 | 0
design__max_slew_violation__count | 2221
design__max_fanout_violation__count | 66
design__max_cap_violation__count | 4
clock__skew__worst_hold | -0.434702758315876
clock__skew__worst_setup | 0.3402640765458829
timing__hold__ws | 0.1225666269835939
timing__setup__ws | 38.72403307620937
timing__hold__tns | 0.0
timing__setup__tns | 0.0
timing__hold__wns | 0
timing__setup__wns | 0.0
timing__hold_vio__count | 0
timing__hold_r2r__ws | 0.122567
timing__hold_r2r_vio__count | 0
timing__setup_vio__count | 0
timing__setup_r2r__ws | 38.724033
timing__setup_r2r_vio__count | 0
design__die__bbox | 0.0 0.0 583.94 601.86
design__core__bbox | 6.72 15.68 576.8 584.08
design__io | 30
design__die__area | 351450
design__core__area | 324033
design__instance__count__stdcell | 8935
design__instance__area__stdcell | 205504
design__instance__count__macros | 0
design__instance__area__macros | 0
design__instance__count__padcells | 0
design__instance__area__padcells | 0
design__instance__count__cover | 0
design__instance__area__cover | 0
design__instance__utilization | 0.634205
design__instance__utilization__stdcell | 0.634205
design__rows | 145
design__rows:GF018hv5v_mcu_sc7 | 145
design__sites | 147610
design__sites:GF018hv5v_mcu_sc7 | 147610
design__instance__count__class:tie_cell | 1
design__instance__area__class:tie_cell | 8.7808
design__instance__count__class:inverter | 295
design__instance__area__class:inverter | 2590.34
design__instance__count__class:sequential_cell | 1069
design__instance__area__class:sequential_cell | 70250.8
design__instance__count__class:multi_input_combinational_cell | 4202
design__instance__area__class:multi_input_combinational_cell | 89911
flow__warnings__count | 1
flow__errors__count | 0
flow__warnings__count:ODB-0220 | 1
flow__warnings__type_count | 1
flow__warnings__count:ORD-0039 | 1
design__instance__count__class:endcap_cell | 290
design__instance__area__class:endcap_cell | 1273.22
design__instance__count__class:tap_cell | 2131
design__instance__area__class:tap_cell | 9355.94
design__power_grid_violation__count__net:VSS | 0
design__power_grid_violation__count__net:VDD | 0
design__power_grid_violation__count | 0
flow__warnings__count:GRT-0281 | 1
timing__drv__floating__nets | 2
timing__drv__floating__pins | 0
design__instance__displacement__total | 107.362
design__instance__displacement__mean | 0.012
design__instance__displacement__max | 13.44
route__wirelength__estimated | 320547
design__violations | 0
design__instance__count__class:timing_repair_buffer | 794
design__instance__area__class:timing_repair_buffer | 25830.9
flow__warnings__count:RSZ-0020 | 1
flow__warnings__count:STA-1140 | 6
design__instance__count__class:clock_buffer | 111
design__instance__area__class:clock_buffer | 5795.33
design__instance__count__class:clock_inverter | 28
design__instance__area__class:clock_inverter | 425.869
design__instance__count__setup_buffer | 0
design__instance__count__hold_buffer | 7
global_route__vias | 234
global_route__wirelength | 527738
antenna__violating__nets | 0
antenna__violating__pins | 0
route__antenna_violation__count | 0
antenna_diodes_count | 13
design__instance__count__class:antenna_cell | 14
design__instance__area__class:antenna_cell | 61.4656
route__net | 6446
route__net__special | 2
route__drc_errors__iter:0 | 260
route__wirelength__iter:0 | 378050
route__drc_errors__iter:1 | 52
route__wirelength__iter:1 | 377952
route__drc_errors__iter:2 | 54
route__wirelength__iter:2 | 377921
route__drc_errors__iter:3 | 0
route__wirelength__iter:3 | 377800
route__drc_errors__iter:4 | 0
route__wirelength__iter:4 | 377801
route__drc_errors | 0
route__wirelength | 377800
route__vias | 47941
route__vias__singlecut | 47941
route__vias__multicut | 0
flow__warnings__count:DRT-0349 | 8
design__disconnected_pin__count | 0
design__critical_disconnected_pin__count | 0
route__wirelength__max | 1197.76
design__instance__count__class:fill_cell | 9710
design__instance__area__class:fill_cell | 118530
timing__unannotated_net__count__corner:nom_tt_025C_5v00 | 63
timing__unannotated_net_filtered__count__corner:nom_tt_025C_5v00 | 0
timing__unannotated_net__count__corner:nom_ss_125C_4v50 | 63
timing__unannotated_net_filtered__count__corner:nom_ss_125C_4v50 | 0
timing__unannotated_net__count__corner:nom_ff_n40C_5v50 | 63
timing__unannotated_net_filtered__count__corner:nom_ff_n40C_5v50 | 0
design__max_slew_violation__count__corner:min_tt_025C_5v00 | 0
design__max_fanout_violation__count__corner:min_tt_025C_5v00 | 66
design__max_cap_violation__count__corner:min_tt_025C_5v00 | 2
clock__skew__worst_hold__corner:min_tt_025C_5v00 | -0.5313849510819069
clock__skew__worst_setup__corner:min_tt_025C_5v00 | 0.3888917353774464
timing__hold__ws__corner:min_tt_025C_5v00 | 0.35734483050724203
timing__setup__ws__corner:min_tt_025C_5v00 | 68.92601529065806
timing__hold__tns__corner:min_tt_025C_5v00 | 0.0
timing__setup__tns__corner:min_tt_025C_5v00 | 0.0
timing__hold__wns__corner:min_tt_025C_5v00 | 0
timing__setup__wns__corner:min_tt_025C_5v00 | 0.0
timing__hold_vio__count__corner:min_tt_025C_5v00 | 0
timing__hold_r2r__ws__corner:min_tt_025C_5v00 | 0.357345
timing__hold_r2r_vio__count__corner:min_tt_025C_5v00 | 0
timing__setup_vio__count__corner:min_tt_025C_5v00 | 0
timing__setup_r2r__ws__corner:min_tt_025C_5v00 | 68.926018
timing__setup_r2r_vio__count__corner:min_tt_025C_5v00 | 0
timing__unannotated_net__count__corner:min_tt_025C_5v00 | 63
timing__unannotated_net_filtered__count__corner:min_tt_025C_5v00 | 0
design__max_slew_violation__count__corner:min_ss_125C_4v50 | 1160
design__max_fanout_violation__count__corner:min_ss_125C_4v50 | 66
design__max_cap_violation__count__corner:min_ss_125C_4v50 | 2
clock__skew__worst_hold__corner:min_ss_125C_4v50 | -0.7456375727903869
clock__skew__worst_setup__corner:min_ss_125C_4v50 | 0.495516197654787
timing__hold__ws__corner:min_ss_125C_4v50 | 0.9057077566510965
timing__setup__ws__corner:min_ss_125C_4v50 | 42.6151463956775
timing__hold__tns__corner:min_ss_125C_4v50 | 0.0
timing__setup__tns__corner:min_ss_125C_4v50 | 0.0
timing__hold__wns__corner:min_ss_125C_4v50 | 0
timing__setup__wns__corner:min_ss_125C_4v50 | 0.0
timing__hold_vio__count__corner:min_ss_125C_4v50 | 0
timing__hold_r2r__ws__corner:min_ss_125C_4v50 | 0.905708
timing__hold_r2r_vio__count__corner:min_ss_125C_4v50 | 0
timing__setup_vio__count__corner:min_ss_125C_4v50 | 0
timing__setup_r2r__ws__corner:min_ss_125C_4v50 | 42.615147
timing__setup_r2r_vio__count__corner:min_ss_125C_4v50 | 0
timing__unannotated_net__count__corner:min_ss_125C_4v50 | 63
timing__unannotated_net_filtered__count__corner:min_ss_125C_4v50 | 0
design__max_slew_violation__count__corner:min_ff_n40C_5v50 | 0
design__max_fanout_violation__count__corner:min_ff_n40C_5v50 | 66
design__max_cap_violation__count__corner:min_ff_n40C_5v50 | 2
clock__skew__worst_hold__corner:min_ff_n40C_5v50 | -0.434702758315876
clock__skew__worst_setup__corner:min_ff_n40C_5v50 | 0.3402640765458829
timing__hold__ws__corner:min_ff_n40C_5v50 | 0.1225666269835939
timing__setup__ws__corner:min_ff_n40C_5v50 | 75.55750372563102
timing__hold__tns__corner:min_ff_n40C_5v50 | 0.0
timing__setup__tns__corner:min_ff_n40C_5v50 | 0.0
timing__hold__wns__corner:min_ff_n40C_5v50 | 0
timing__setup__wns__corner:min_ff_n40C_5v50 | 0.0
timing__hold_vio__count__corner:min_ff_n40C_5v50 | 0
timing__hold_r2r__ws__corner:min_ff_n40C_5v50 | 0.122567
timing__hold_r2r_vio__count__corner:min_ff_n40C_5v50 | 0
timing__setup_vio__count__corner:min_ff_n40C_5v50 | 0
timing__setup_r2r__ws__corner:min_ff_n40C_5v50 | 80.646866
timing__setup_r2r_vio__count__corner:min_ff_n40C_5v50 | 0
timing__unannotated_net__count__corner:min_ff_n40C_5v50 | 63
timing__unannotated_net_filtered__count__corner:min_ff_n40C_5v50 | 0
design__max_slew_violation__count__corner:max_tt_025C_5v00 | 64
design__max_fanout_violation__count__corner:max_tt_025C_5v00 | 66
design__max_cap_violation__count__corner:max_tt_025C_5v00 | 3
clock__skew__worst_hold__corner:max_tt_025C_5v00 | -0.55170414243096
clock__skew__worst_setup__corner:max_tt_025C_5v00 | 0.4181660414075452
timing__hold__ws__corner:max_tt_025C_5v00 | 0.36148529637237947
timing__setup__ws__corner:max_tt_025C_5v00 | 66.70537733206517
timing__hold__tns__corner:max_tt_025C_5v00 | 0.0
timing__setup__tns__corner:max_tt_025C_5v00 | 0.0
timing__hold__wns__corner:max_tt_025C_5v00 | 0
timing__setup__wns__corner:max_tt_025C_5v00 | 0.0
timing__hold_vio__count__corner:max_tt_025C_5v00 | 0
timing__hold_r2r__ws__corner:max_tt_025C_5v00 | 0.361485
timing__hold_r2r_vio__count__corner:max_tt_025C_5v00 | 0
timing__setup_vio__count__corner:max_tt_025C_5v00 | 0
timing__setup_r2r__ws__corner:max_tt_025C_5v00 | 66.705376
timing__setup_r2r_vio__count__corner:max_tt_025C_5v00 | 0
timing__unannotated_net__count__corner:max_tt_025C_5v00 | 63
timing__unannotated_net_filtered__count__corner:max_tt_025C_5v00 | 0
design__max_slew_violation__count__corner:max_ss_125C_4v50 | 2221
design__max_fanout_violation__count__corner:max_ss_125C_4v50 | 66
design__max_cap_violation__count__corner:max_ss_125C_4v50 | 4
clock__skew__worst_hold__corner:max_ss_125C_4v50 | -0.7797556154804618
clock__skew__worst_setup__corner:max_ss_125C_4v50 | 0.5464860940676453
timing__hold__ws__corner:max_ss_125C_4v50 | 0.9124716795976197
timing__setup__ws__corner:max_ss_125C_4v50 | 38.72403307620937
timing__hold__tns__corner:max_ss_125C_4v50 | 0.0
timing__setup__tns__corner:max_ss_125C_4v50 | 0.0
timing__hold__wns__corner:max_ss_125C_4v50 | 0
timing__setup__wns__corner:max_ss_125C_4v50 | 0.0
timing__hold_vio__count__corner:max_ss_125C_4v50 | 0
timing__hold_r2r__ws__corner:max_ss_125C_4v50 | 0.912472
timing__hold_r2r_vio__count__corner:max_ss_125C_4v50 | 0
timing__setup_vio__count__corner:max_ss_125C_4v50 | 0
timing__setup_r2r__ws__corner:max_ss_125C_4v50 | 38.724033
timing__setup_r2r_vio__count__corner:max_ss_125C_4v50 | 0
timing__unannotated_net__count__corner:max_ss_125C_4v50 | 63
timing__unannotated_net_filtered__count__corner:max_ss_125C_4v50 | 0
design__max_slew_violation__count__corner:max_ff_n40C_5v50 | 0
design__max_fanout_violation__count__corner:max_ff_n40C_5v50 | 66
design__max_cap_violation__count__corner:max_ff_n40C_5v50 | 3
clock__skew__worst_hold__corner:max_ff_n40C_5v50 | -0.4486091902710265
clock__skew__worst_setup__corner:max_ff_n40C_5v50 | 0.35948453564754146
timing__hold__ws__corner:max_ff_n40C_5v50 | 0.12567136575976617
timing__setup__ws__corner:max_ff_n40C_5v50 | 75.39660131856752
timing__hold__tns__corner:max_ff_n40C_5v50 | 0.0
timing__setup__tns__corner:max_ff_n40C_5v50 | 0.0
timing__hold__wns__corner:max_ff_n40C_5v50 | 0
timing__setup__wns__corner:max_ff_n40C_5v50 | 0.0
timing__hold_vio__count__corner:max_ff_n40C_5v50 | 0
timing__hold_r2r__ws__corner:max_ff_n40C_5v50 | 0.125671
timing__hold_r2r_vio__count__corner:max_ff_n40C_5v50 | 0
timing__setup_vio__count__corner:max_ff_n40C_5v50 | 0
timing__setup_r2r__ws__corner:max_ff_n40C_5v50 | 79.204758
timing__setup_r2r_vio__count__corner:max_ff_n40C_5v50 | 0
timing__unannotated_net__count__corner:max_ff_n40C_5v50 | 63
timing__unannotated_net_filtered__count__corner:max_ff_n40C_5v50 | 0
timing__unannotated_net__count | 63
timing__unannotated_net_filtered__count | 0
design_powergrid__voltage__worst__net:VDD__corner:nom_tt_025C_5v00 | 4.99979
design_powergrid__drop__average__net:VDD__corner:nom_tt_025C_5v00 | 4.99995
design_powergrid__drop__worst__net:VDD__corner:nom_tt_025C_5v00 | 0.000212371
design_powergrid__voltage__worst__net:VSS__corner:nom_tt_025C_5v00 | 0.000209094
design_powergrid__drop__average__net:VSS__corner:nom_tt_025C_5v00 | 0.0000477173
design_powergrid__drop__worst__net:VSS__corner:nom_tt_025C_5v00 | 0.000209094
design_powergrid__voltage__worst | 0.000209094
design_powergrid__voltage__worst__net:VDD | 4.99979
design_powergrid__drop__worst | 0.000212371
design_powergrid__drop__worst__net:VDD | 0.000212371
design_powergrid__voltage__worst__net:VSS | 0.000209094
design_powergrid__drop__worst__net:VSS | 0.000209094
ir__voltage__worst | 5
ir__drop__avg | 0.0000491000000000000008486267244478540305863134562969207763671875
ir__drop__worst | 0.0002120000000000000031120939159023919273749925196170806884765625
design__xor_difference__count | 0
magic__drc_error__count | 0
magic__illegal_overlap__count | 0
design__lvs_device_difference__count | 0
design__lvs_net_difference__count | 0
design__lvs_property_fail__count | 0
design__lvs_error__count | 0
design__lvs_unmatched_device__count | 0
design__lvs_unmatched_net__count | 0
design__lvs_unmatched_pin__count | 0
