F-Izcue-223/Proyecto-3-Arquitectura-de-Computadores/resultados/util_60/metrics.csv

Metric | Value
design__lint_error__count | 0
design__lint_timing_construct__count | 0
design__lint_warning__count | 15
design__inferred_latch__count | 0
design__instance__count | 15492
design__instance__area | 269193
design__instance_unmapped__count | 0
synthesis__check_error__count | 0
design__max_slew_violation__count__corner:nom_tt_025C_5v00 | 13
design__max_fanout_violation__count__corner:nom_tt_025C_5v00 | 64
design__max_cap_violation__count__corner:nom_tt_025C_5v00 | 2
power__internal__total | 0.012303230352699757
power__switching__total | 0.005625556688755751
power__leakage__total | 0.000002017074166360544
power__total | 0.017930803820490837
clock__skew__worst_hold__corner:nom_tt_025C_5v00 | -0.5393712296131128
clock__skew__worst_setup__corner:nom_tt_025C_5v00 | 0.415537699344713
timing__hold__ws__corner:nom_tt_025C_5v00 | 0.36943582572118144
timing__setup__ws__corner:nom_tt_025C_5v00 | 66.75161945461625
timing__hold__tns__corner:nom_tt_025C_5v00 | 0.0
timing__setup__tns__corner:nom_tt_025C_5v00 | 0.0
timing__hold__wns__corner:nom_tt_025C_5v00 | 0
timing__setup__wns__corner:nom_tt_025C_5v00 | 0.0
timing__hold_vio__count__corner:nom_tt_025C_5v00 | 0
timing__hold_r2r__ws__corner:nom_tt_025C_5v00 | 0.369436
timing__hold_r2r_vio__count__corner:nom_tt_025C_5v00 | 0
timing__setup_vio__count__corner:nom_tt_025C_5v00 | 0
timing__setup_r2r__ws__corner:nom_tt_025C_5v00 | 66.751617
timing__setup_r2r_vio__count__corner:nom_tt_025C_5v00 | 0
design__max_slew_violation__count__corner:nom_ss_125C_4v50 | 1731
design__max_fanout_violation__count__corner:nom_ss_125C_4v50 | 64
design__max_cap_violation__count__corner:nom_ss_125C_4v50 | 2
clock__skew__worst_hold__corner:nom_ss_125C_4v50 | -0.7593390575693953
clock__skew__worst_setup__corner:nom_ss_125C_4v50 | 0.540436266590757
timing__hold__ws__corner:nom_ss_125C_4v50 | 0.9263885476494969
timing__setup__ws__corner:nom_ss_125C_4v50 | 38.78539554860507
timing__hold__tns__corner:nom_ss_125C_4v50 | 0.0
timing__setup__tns__corner:nom_ss_125C_4v50 | 0.0
timing__hold__wns__corner:nom_ss_125C_4v50 | 0
timing__setup__wns__corner:nom_ss_125C_4v50 | 0.0
timing__hold_vio__count__corner:nom_ss_125C_4v50 | 0
timing__hold_r2r__ws__corner:nom_ss_125C_4v50 | 0.926389
timing__hold_r2r_vio__count__corner:nom_ss_125C_4v50 | 0
timing__setup_vio__count__corner:nom_ss_125C_4v50 | 0
timing__setup_r2r__ws__corner:nom_ss_125C_4v50 | 38.785397
timing__setup_r2r_vio__count__corner:nom_ss_125C_4v50 | 0
design__max_slew_violation__count__corner:nom_ff_n40C_5v50 | 0
design__max_fanout_violation__count__corner:nom_ff_n40C_5v50 | 64
design__max_cap_violation__count__corner:nom_ff_n40C_5v50 | 2
clock__skew__worst_hold__corner:nom_ff_n40C_5v50 | -0.4400289979160003
clock__skew__worst_setup__corner:nom_ff_n40C_5v50 | 0.3585524478808562
timing__hold__ws__corner:nom_ff_n40C_5v50 | 0.13121115676471676
timing__setup__ws__corner:nom_ff_n40C_5v50 | 75.46013805179612
timing__hold__tns__corner:nom_ff_n40C_5v50 | 0.0
timing__setup__tns__corner:nom_ff_n40C_5v50 | 0.0
timing__hold__wns__corner:nom_ff_n40C_5v50 | 0
timing__setup__wns__corner:nom_ff_n40C_5v50 | 0.0
timing__hold_vio__count__corner:nom_ff_n40C_5v50 | 0
timing__hold_r2r__ws__corner:nom_ff_n40C_5v50 | 0.131211
timing__hold_r2r_vio__count__corner:nom_ff_n40C_5v50 | 0
timing__setup_vio__count__corner:nom_ff_n40C_5v50 | 0
timing__setup_r2r__ws__corner:nom_ff_n40C_5v50 | 79.170700
timing__setup_r2r_vio__count__corner:nom_ff_n40C_5v50 | 0
design__max_slew_violation__count | 2320
design__max_fanout_violation__count | 64
design__max_cap_violation__count | 5
clock__skew__worst_hold | -0.43369628560443707
clock__skew__worst_setup | 0.34971657115602756
timing__hold__ws | 0.12806678302544441
timing__setup__ws | 36.81833608872192
timing__hold__tns | 0.0
timing__setup__tns | 0.0
timing__hold__wns | 0
timing__setup__wns | 0.0
timing__hold_vio__count | 0
timing__hold_r2r__ws | 0.128067
timing__hold_r2r_vio__count | 0
timing__setup_vio__count | 0
timing__setup_r2r__ws | 36.818336
timing__setup_r2r_vio__count | 0
design__die__bbox | 0.0 0.0 534.23 552.15
design__core__bbox | 6.72 15.68 526.96 533.12
design__io | 30
design__die__area | 294975
design__core__area | 269193
design__instance__count__stdcell | 8489
design__instance__area__stdcell | 203168
design__instance__count__macros | 0
design__instance__area__macros | 0
design__instance__count__padcells | 0
design__instance__area__padcells | 0
design__instance__count__cover | 0
design__instance__area__cover | 0
design__instance__utilization | 0.75473
design__instance__utilization__stdcell | 0.75473
design__rows | 132
design__rows:GF018hv5v_mcu_sc7 | 132
design__sites | 122628
design__sites:GF018hv5v_mcu_sc7 | 122628
design__instance__count__class:tie_cell | 1
design__instance__area__class:tie_cell | 8.7808
design__instance__count__class:inverter | 295
design__instance__area__class:inverter | 2590.34
design__instance__count__class:sequential_cell | 1069
design__instance__area__class:sequential_cell | 70250.8
design__instance__count__class:multi_input_combinational_cell | 4202
design__instance__area__class:multi_input_combinational_cell | 89911
flow__warnings__count | 1
flow__errors__count | 0
flow__warnings__count:ODB-0220 | 1
flow__warnings__type_count | 1
flow__warnings__count:ORD-0039 | 1
design__instance__count__class:endcap_cell | 264
design__instance__area__class:endcap_cell | 1159.07
design__instance__count__class:tap_cell | 1744
design__instance__area__class:tap_cell | 7656.86
design__power_grid_violation__count__net:VSS | 0
design__power_grid_violation__count__net:VDD | 0
design__power_grid_violation__count | 0
flow__warnings__count:GRT-0281 | 1
timing__drv__floating__nets | 2
timing__drv__floating__pins | 0
design__instance__displacement__total | 535.601
design__instance__displacement__mean | 0.063
design__instance__displacement__max | 43.201
route__wirelength__estimated | 312012
design__violations | 0
design__instance__count__class:timing_repair_buffer | 773
design__instance__area__class:timing_repair_buffer | 25317.2
flow__warnings__count:RSZ-0020 | 1
flow__warnings__count:STA-1140 | 6
design__instance__count__class:clock_buffer | 112
design__instance__area__class:clock_buffer | 5878.75
design__instance__count__class:clock_inverter | 22
design__instance__area__class:clock_inverter | 364.403
design__instance__count__setup_buffer | 0
design__instance__count__hold_buffer | 7
global_route__vias | 82
global_route__wirelength | 518498
antenna__violating__nets | 0
antenna__violating__pins | 0
route__antenna_violation__count | 0
antenna_diodes_count | 5
design__instance__count__class:antenna_cell | 7
design__instance__area__class:antenna_cell | 30.7328
route__net | 6423
route__net__special | 2
route__drc_errors__iter:0 | 97
route__wirelength__iter:0 | 367763
route__drc_errors__iter:1 | 10
route__wirelength__iter:1 | 367729
route__drc_errors__iter:2 | 3
route__wirelength__iter:2 | 367718
route__drc_errors__iter:3 | 0
route__wirelength__iter:3 | 367748
route__drc_errors__iter:4 | 0
route__wirelength__iter:4 | 367693
route__drc_errors | 0
route__wirelength | 367748
route__vias | 48938
route__vias__singlecut | 48938
route__vias__multicut | 0
flow__warnings__count:DRT-0349 | 8
design__disconnected_pin__count | 0
design__critical_disconnected_pin__count | 0
route__wirelength__max | 1091.48
design__instance__count__class:fill_cell | 7003
design__instance__area__class:fill_cell | 66025
timing__unannotated_net__count__corner:nom_tt_025C_5v00 | 60
timing__unannotated_net_filtered__count__corner:nom_tt_025C_5v00 | 0
timing__unannotated_net__count__corner:nom_ss_125C_4v50 | 60
timing__unannotated_net_filtered__count__corner:nom_ss_125C_4v50 | 0
timing__unannotated_net__count__corner:nom_ff_n40C_5v50 | 60
timing__unannotated_net_filtered__count__corner:nom_ff_n40C_5v50 | 0
design__max_slew_violation__count__corner:min_tt_025C_5v00 | 0
design__max_fanout_violation__count__corner:min_tt_025C_5v00 | 64
design__max_cap_violation__count__corner:min_tt_025C_5v00 | 2
clock__skew__worst_hold__corner:min_tt_025C_5v00 | -0.5301633726533631
clock__skew__worst_setup__corner:min_tt_025C_5v00 | 0.4020442703664036
timing__hold__ws__corner:min_tt_025C_5v00 | 0.3648892402621503
timing__setup__ws__corner:min_tt_025C_5v00 | 67.67816010282442
timing__hold__tns__corner:min_tt_025C_5v00 | 0.0
timing__setup__tns__corner:min_tt_025C_5v00 | 0.0
timing__hold__wns__corner:min_tt_025C_5v00 | 0
timing__setup__wns__corner:min_tt_025C_5v00 | 0.0
timing__hold_vio__count__corner:min_tt_025C_5v00 | 0
timing__hold_r2r__ws__corner:min_tt_025C_5v00 | 0.364889
timing__hold_r2r_vio__count__corner:min_tt_025C_5v00 | 0
timing__setup_vio__count__corner:min_tt_025C_5v00 | 0
timing__setup_r2r__ws__corner:min_tt_025C_5v00 | 67.678162
timing__setup_r2r_vio__count__corner:min_tt_025C_5v00 | 0
timing__unannotated_net__count__corner:min_tt_025C_5v00 | 60
timing__unannotated_net_filtered__count__corner:min_tt_025C_5v00 | 0
design__max_slew_violation__count__corner:min_ss_125C_4v50 | 1232
design__max_fanout_violation__count__corner:min_ss_125C_4v50 | 64
design__max_cap_violation__count__corner:min_ss_125C_4v50 | 2
clock__skew__worst_hold__corner:min_ss_125C_4v50 | -0.7440204218869817
clock__skew__worst_setup__corner:min_ss_125C_4v50 | 0.5175804376032993
timing__hold__ws__corner:min_ss_125C_4v50 | 0.9185128473346709
timing__setup__ws__corner:min_ss_125C_4v50 | 40.42721116742286
timing__hold__tns__corner:min_ss_125C_4v50 | 0.0
timing__setup__tns__corner:min_ss_125C_4v50 | 0.0
timing__hold__wns__corner:min_ss_125C_4v50 | 0
timing__setup__wns__corner:min_ss_125C_4v50 | 0.0
timing__hold_vio__count__corner:min_ss_125C_4v50 | 0
timing__hold_r2r__ws__corner:min_ss_125C_4v50 | 0.918513
timing__hold_r2r_vio__count__corner:min_ss_125C_4v50 | 0
timing__setup_vio__count__corner:min_ss_125C_4v50 | 0
timing__setup_r2r__ws__corner:min_ss_125C_4v50 | 40.427212
timing__setup_r2r_vio__count__corner:min_ss_125C_4v50 | 0
timing__unannotated_net__count__corner:min_ss_125C_4v50 | 60
timing__unannotated_net_filtered__count__corner:min_ss_125C_4v50 | 0
design__max_slew_violation__count__corner:min_ff_n40C_5v50 | 0
design__max_fanout_violation__count__corner:min_ff_n40C_5v50 | 64
design__max_cap_violation__count__corner:min_ff_n40C_5v50 | 2
clock__skew__worst_hold__corner:min_ff_n40C_5v50 | -0.43369628560443707
clock__skew__worst_setup__corner:min_ff_n40C_5v50 | 0.34971657115602756
timing__hold__ws__corner:min_ff_n40C_5v50 | 0.12806678302544441
timing__setup__ws__corner:min_ff_n40C_5v50 | 75.53165418017299
timing__hold__tns__corner:min_ff_n40C_5v50 | 0.0
timing__setup__tns__corner:min_ff_n40C_5v50 | 0.0
timing__hold__wns__corner:min_ff_n40C_5v50 | 0
timing__setup__wns__corner:min_ff_n40C_5v50 | 0.0
timing__hold_vio__count__corner:min_ff_n40C_5v50 | 0
timing__hold_r2r__ws__corner:min_ff_n40C_5v50 | 0.128067
timing__hold_r2r_vio__count__corner:min_ff_n40C_5v50 | 0
timing__setup_vio__count__corner:min_ff_n40C_5v50 | 0
timing__setup_r2r__ws__corner:min_ff_n40C_5v50 | 79.775955
timing__setup_r2r_vio__count__corner:min_ff_n40C_5v50 | 0
timing__unannotated_net__count__corner:min_ff_n40C_5v50 | 60
timing__unannotated_net_filtered__count__corner:min_ff_n40C_5v50 | 0
design__max_slew_violation__count__corner:max_tt_025C_5v00 | 69
design__max_fanout_violation__count__corner:max_tt_025C_5v00 | 64
design__max_cap_violation__count__corner:max_tt_025C_5v00 | 5
clock__skew__worst_hold__corner:max_tt_025C_5v00 | -0.5601199662625418
clock__skew__worst_setup__corner:max_tt_025C_5v00 | 0.431891451493411
timing__hold__ws__corner:max_tt_025C_5v00 | 0.37507831235881434
timing__setup__ws__corner:max_tt_025C_5v00 | 65.62107487577437
timing__hold__tns__corner:max_tt_025C_5v00 | 0.0
timing__setup__tns__corner:max_tt_025C_5v00 | 0.0
timing__hold__wns__corner:max_tt_025C_5v00 | 0
timing__setup__wns__corner:max_tt_025C_5v00 | 0.0
timing__hold_vio__count__corner:max_tt_025C_5v00 | 0
timing__hold_r2r__ws__corner:max_tt_025C_5v00 | 0.375078
timing__hold_r2r_vio__count__corner:max_tt_025C_5v00 | 0
timing__setup_vio__count__corner:max_tt_025C_5v00 | 0
timing__setup_r2r__ws__corner:max_tt_025C_5v00 | 65.621078
timing__setup_r2r_vio__count__corner:max_tt_025C_5v00 | 0
timing__unannotated_net__count__corner:max_tt_025C_5v00 | 60
timing__unannotated_net_filtered__count__corner:max_tt_025C_5v00 | 0
design__max_slew_violation__count__corner:max_ss_125C_4v50 | 2320
design__max_fanout_violation__count__corner:max_ss_125C_4v50 | 64
design__max_cap_violation__count__corner:max_ss_125C_4v50 | 5
clock__skew__worst_hold__corner:max_ss_125C_4v50 | -0.7932075221164759
clock__skew__worst_setup__corner:max_ss_125C_4v50 | 0.5686065113027924
timing__hold__ws__corner:max_ss_125C_4v50 | 0.9361693907284606
timing__setup__ws__corner:max_ss_125C_4v50 | 36.81833608872192
timing__hold__tns__corner:max_ss_125C_4v50 | 0.0
timing__setup__tns__corner:max_ss_125C_4v50 | 0.0
timing__hold__wns__corner:max_ss_125C_4v50 | 0
timing__setup__wns__corner:max_ss_125C_4v50 | 0.0
timing__hold_vio__count__corner:max_ss_125C_4v50 | 0
timing__hold_r2r__ws__corner:max_ss_125C_4v50 | 0.936169
timing__hold_r2r_vio__count__corner:max_ss_125C_4v50 | 0
timing__setup_vio__count__corner:max_ss_125C_4v50 | 0
timing__setup_r2r__ws__corner:max_ss_125C_4v50 | 36.818336
timing__setup_r2r_vio__count__corner:max_ss_125C_4v50 | 0
timing__unannotated_net__count__corner:max_ss_125C_4v50 | 60
timing__unannotated_net_filtered__count__corner:max_ss_125C_4v50 | 0
design__max_slew_violation__count__corner:max_ff_n40C_5v50 | 0
design__max_fanout_violation__count__corner:max_ff_n40C_5v50 | 64
design__max_cap_violation__count__corner:max_ff_n40C_5v50 | 5
clock__skew__worst_hold__corner:max_ff_n40C_5v50 | -0.45356775175057196
clock__skew__worst_setup__corner:max_ff_n40C_5v50 | 0.3693774279884346
timing__hold__ws__corner:max_ff_n40C_5v50 | 0.13519363788898192
timing__setup__ws__corner:max_ff_n40C_5v50 | 75.37426895975098
timing__hold__tns__corner:max_ff_n40C_5v50 | 0.0
timing__setup__tns__corner:max_ff_n40C_5v50 | 0.0
timing__hold__wns__corner:max_ff_n40C_5v50 | 0
timing__setup__wns__corner:max_ff_n40C_5v50 | 0.0
timing__hold_vio__count__corner:max_ff_n40C_5v50 | 0
timing__hold_r2r__ws__corner:max_ff_n40C_5v50 | 0.135194
timing__hold_r2r_vio__count__corner:max_ff_n40C_5v50 | 0
timing__setup_vio__count__corner:max_ff_n40C_5v50 | 0
timing__setup_r2r__ws__corner:max_ff_n40C_5v50 | 78.434433
timing__setup_r2r_vio__count__corner:max_ff_n40C_5v50 | 0
timing__unannotated_net__count__corner:max_ff_n40C_5v50 | 60
timing__unannotated_net_filtered__count__corner:max_ff_n40C_5v50 | 0
timing__unannotated_net__count | 60
timing__unannotated_net_filtered__count | 0
design_powergrid__voltage__worst__net:VDD__corner:nom_tt_025C_5v00 | 4.99981
design_powergrid__drop__average__net:VDD__corner:nom_tt_025C_5v00 | 4.99995
design_powergrid__drop__worst__net:VDD__corner:nom_tt_025C_5v00 | 0.000192866
design_powergrid__voltage__worst__net:VSS__corner:nom_tt_025C_5v00 | 0.000184809
design_powergrid__drop__average__net:VSS__corner:nom_tt_025C_5v00 | 0.0000520021
design_powergrid__drop__worst__net:VSS__corner:nom_tt_025C_5v00 | 0.000184809
design_powergrid__voltage__worst | 0.000184809
design_powergrid__voltage__worst__net:VDD | 4.99981
design_powergrid__drop__worst | 0.000192866
design_powergrid__drop__worst__net:VDD | 0.000192866
design_powergrid__voltage__worst__net:VSS | 0.000184809
design_powergrid__drop__worst__net:VSS | 0.000184809
ir__voltage__worst | 5
ir__drop__avg | 0.0000544000000000000009264290723454138287706882692873477935791015625
ir__drop__worst | 0.00019300000000000000206605565988837724944460205733776092529296875
design__xor_difference__count | 0
magic__drc_error__count | 0
magic__illegal_overlap__count | 0
design__lvs_device_difference__count | 0
design__lvs_net_difference__count | 0
design__lvs_property_fail__count | 0
design__lvs_error__count | 0
design__lvs_unmatched_device__count | 0
design__lvs_unmatched_net__count | 0
design__lvs_unmatched_pin__count | 0
