F-Izcue-223/Proyecto-3-Arquitectura-de-Computadores/resultados/clk_50ns/render/asic_top.png

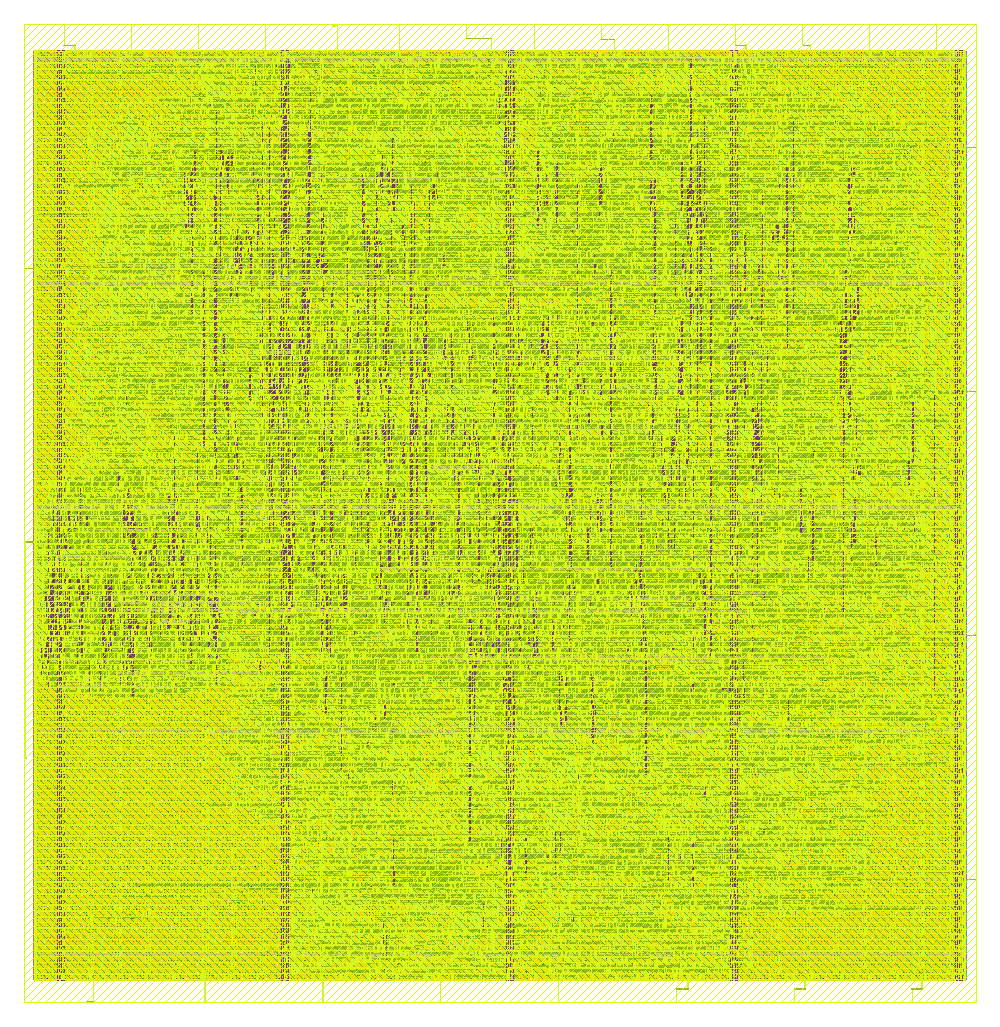
resultados/clk_50ns/render/asic_top.png
