F-Izcue-223/Proyecto-3-Arquitectura-de-Computadores/resultados/final_opt/render/asic_top.png

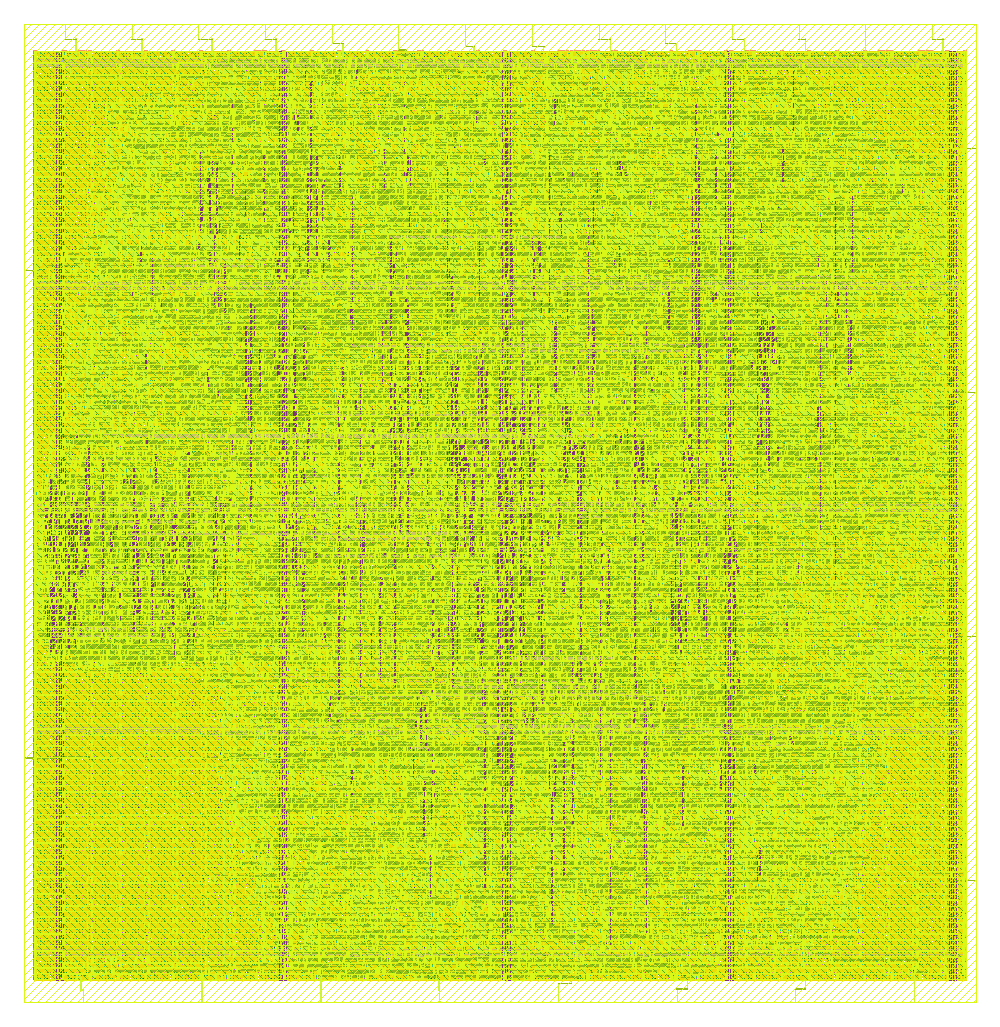
resultados/final_opt/render/asic_top.png
