F-Izcue-223/Proyecto-3-Arquitectura-de-Computadores/resultados/util_30/render/asic_top.png

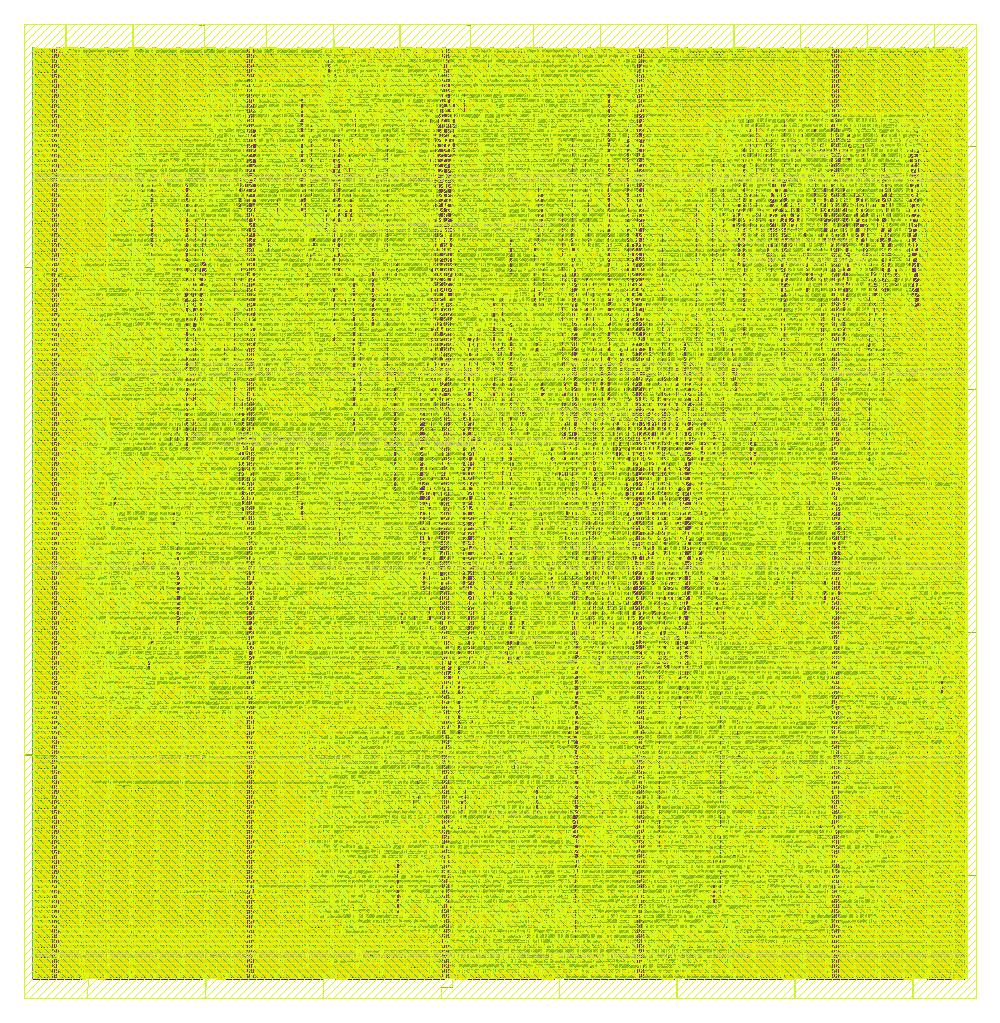
resultados/util_30/render/asic_top.png
