F-Izcue-223/Proyecto-3-Arquitectura-de-Computadores/resultados/util_60/render/asic_top.png

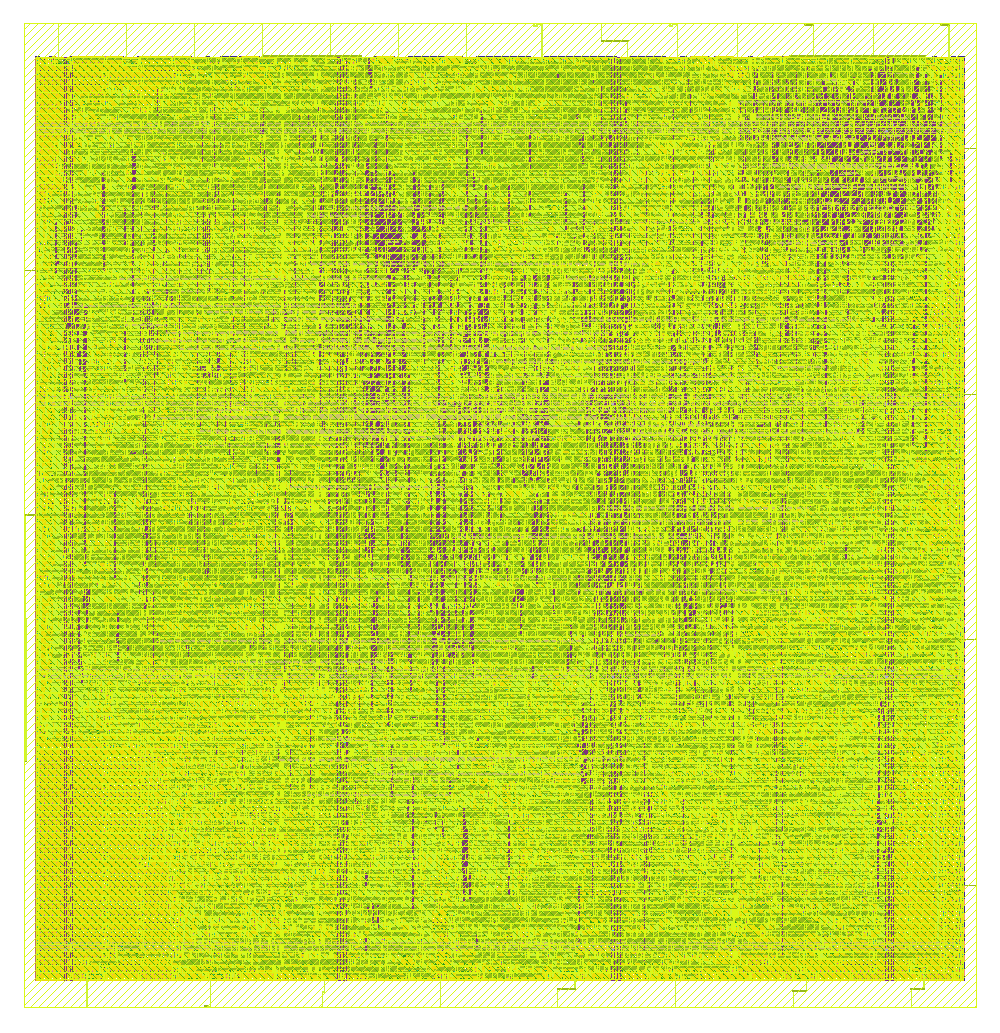
resultados/util_60/render/asic_top.png
