F-Izcue-223/Proyecto-3-Arquitectura-de-Computadores/sim_asic/postsynth/gf180/celdas_gf180_comb.v

module gf180mcu_fd_sc_mcu7t5v0__addf_1( S, A, CI, B, CO );
input A, B, CI;
output CO, S;

	wire CO_row1;

	and MGM_BG_0( CO_row1, A, B );

	wire CO_row2;

	and MGM_BG_1( CO_row2, A, CI );

	wire CO_row3;

	and MGM_BG_2( CO_row3, B, CI );

	or MGM_BG_3( CO, CO_row1, CO_row2, CO_row3 );

	wire S_row1;

	and MGM_BG_4( S_row1, A, B, CI );

	wire B_inv_for_gf180mcu_fd_sc_mcu7t5v0__addf_1;

	not MGM_BG_5( B_inv_for_gf180mcu_fd_sc_mcu7t5v0__addf_1, B );

	wire CI_inv_for_gf180mcu_fd_sc_mcu7t5v0__addf_1;

	not MGM_BG_6( CI_inv_for_gf180mcu_fd_sc_mcu7t5v0__addf_1, CI );

	wire S_row2;

	and MGM_BG_7( S_row2, B_inv_for_gf180mcu_fd_sc_mcu7t5v0__addf_1, CI_inv_for_gf180mcu_fd_sc_mcu7t5v0__addf_1, A );

	wire A_inv_for_gf180mcu_fd_sc_mcu7t5v0__addf_1;

	not MGM_BG_8( A_inv_for_gf180mcu_fd_sc_mcu7t5v0__addf_1, A );

	wire S_row3;

	and MGM_BG_9( S_row3, A_inv_for_gf180mcu_fd_sc_mcu7t5v0__addf_1, CI_inv_for_gf180mcu_fd_sc_mcu7t5v0__addf_1, B );

	wire S_row4;

	and MGM_BG_10( S_row4, A_inv_for_gf180mcu_fd_sc_mcu7t5v0__addf_1, B_inv_for_gf180mcu_fd_sc_mcu7t5v0__addf_1, CI );

	or MGM_BG_11( S, S_row1, S_row2, S_row3, S_row4 );

endmodule
module gf180mcu_fd_sc_mcu7t5v0__addf_2( S, A, CI, B, CO );
input A, B, CI;
output CO, S;

	wire CO_row1;

	and MGM_BG_0( CO_row1, A, B );

	wire CO_row2;

	and MGM_BG_1( CO_row2, A, CI );

	wire CO_row3;

	and MGM_BG_2( CO_row3, B, CI );

	or MGM_BG_3( CO, CO_row1, CO_row2, CO_row3 );

	wire S_row1;

	and MGM_BG_4( S_row1, A, B, CI );

	wire B_inv_for_gf180mcu_fd_sc_mcu7t5v0__addf_2;

	not MGM_BG_5( B_inv_for_gf180mcu_fd_sc_mcu7t5v0__addf_2, B );

	wire CI_inv_for_gf180mcu_fd_sc_mcu7t5v0__addf_2;

	not MGM_BG_6( CI_inv_for_gf180mcu_fd_sc_mcu7t5v0__addf_2, CI );

	wire S_row2;

	and MGM_BG_7( S_row2, B_inv_for_gf180mcu_fd_sc_mcu7t5v0__addf_2, CI_inv_for_gf180mcu_fd_sc_mcu7t5v0__addf_2, A );

	wire A_inv_for_gf180mcu_fd_sc_mcu7t5v0__addf_2;

	not MGM_BG_8( A_inv_for_gf180mcu_fd_sc_mcu7t5v0__addf_2, A );

	wire S_row3;

	and MGM_BG_9( S_row3, A_inv_for_gf180mcu_fd_sc_mcu7t5v0__addf_2, CI_inv_for_gf180mcu_fd_sc_mcu7t5v0__addf_2, B );

	wire S_row4;

	and MGM_BG_10( S_row4, A_inv_for_gf180mcu_fd_sc_mcu7t5v0__addf_2, B_inv_for_gf180mcu_fd_sc_mcu7t5v0__addf_2, CI );

	or MGM_BG_11( S, S_row1, S_row2, S_row3, S_row4 );

endmodule
module gf180mcu_fd_sc_mcu7t5v0__addf_4( S, A, CI, B, CO );
input A, B, CI;
output CO, S;

	wire CO_row1;

	and MGM_BG_0( CO_row1, A, B );

	wire CO_row2;

	and MGM_BG_1( CO_row2, A, CI );

	wire CO_row3;

	and MGM_BG_2( CO_row3, B, CI );

	or MGM_BG_3( CO, CO_row1, CO_row2, CO_row3 );

	wire S_row1;

	and MGM_BG_4( S_row1, A, B, CI );

	wire B_inv_for_gf180mcu_fd_sc_mcu7t5v0__addf_4;

	not MGM_BG_5( B_inv_for_gf180mcu_fd_sc_mcu7t5v0__addf_4, B );

	wire CI_inv_for_gf180mcu_fd_sc_mcu7t5v0__addf_4;

	not MGM_BG_6( CI_inv_for_gf180mcu_fd_sc_mcu7t5v0__addf_4, CI );

	wire S_row2;

	and MGM_BG_7( S_row2, B_inv_for_gf180mcu_fd_sc_mcu7t5v0__addf_4, CI_inv_for_gf180mcu_fd_sc_mcu7t5v0__addf_4, A );

	wire A_inv_for_gf180mcu_fd_sc_mcu7t5v0__addf_4;

	not MGM_BG_8( A_inv_for_gf180mcu_fd_sc_mcu7t5v0__addf_4, A );

	wire S_row3;

	and MGM_BG_9( S_row3, A_inv_for_gf180mcu_fd_sc_mcu7t5v0__addf_4, CI_inv_for_gf180mcu_fd_sc_mcu7t5v0__addf_4, B );

	wire S_row4;

	and MGM_BG_10( S_row4, A_inv_for_gf180mcu_fd_sc_mcu7t5v0__addf_4, B_inv_for_gf180mcu_fd_sc_mcu7t5v0__addf_4, CI );

	or MGM_BG_11( S, S_row1, S_row2, S_row3, S_row4 );

endmodule
module gf180mcu_fd_sc_mcu7t5v0__addh_1( CO, A, B, S );
input A, B;
output CO, S;

	and MGM_BG_0( CO, A, B );

	wire B_inv_for_gf180mcu_fd_sc_mcu7t5v0__addh_1;

	not MGM_BG_1( B_inv_for_gf180mcu_fd_sc_mcu7t5v0__addh_1, B );

	wire S_row1;

	and MGM_BG_2( S_row1, B_inv_for_gf180mcu_fd_sc_mcu7t5v0__addh_1, A );

	wire A_inv_for_gf180mcu_fd_sc_mcu7t5v0__addh_1;

	not MGM_BG_3( A_inv_for_gf180mcu_fd_sc_mcu7t5v0__addh_1, A );

	wire S_row2;

	and MGM_BG_4( S_row2, A_inv_for_gf180mcu_fd_sc_mcu7t5v0__addh_1, B );

	or MGM_BG_5( S, S_row1, S_row2 );

endmodule
module gf180mcu_fd_sc_mcu7t5v0__addh_2( CO, A, B, S );
input A, B;
output CO, S;

	and MGM_BG_0( CO, A, B );

	wire B_inv_for_gf180mcu_fd_sc_mcu7t5v0__addh_2;

	not MGM_BG_1( B_inv_for_gf180mcu_fd_sc_mcu7t5v0__addh_2, B );

	wire S_row1;

	and MGM_BG_2( S_row1, B_inv_for_gf180mcu_fd_sc_mcu7t5v0__addh_2, A );

	wire A_inv_for_gf180mcu_fd_sc_mcu7t5v0__addh_2;

	not MGM_BG_3( A_inv_for_gf180mcu_fd_sc_mcu7t5v0__addh_2, A );

	wire S_row2;

	and MGM_BG_4( S_row2, A_inv_for_gf180mcu_fd_sc_mcu7t5v0__addh_2, B );

	or MGM_BG_5( S, S_row1, S_row2 );

endmodule
module gf180mcu_fd_sc_mcu7t5v0__addh_4( A, B, CO, S );
input A, B;
output CO, S;

	and MGM_BG_0( CO, A, B );

	wire B_inv_for_gf180mcu_fd_sc_mcu7t5v0__addh_4;

	not MGM_BG_1( B_inv_for_gf180mcu_fd_sc_mcu7t5v0__addh_4, B );

	wire S_row1;

	and MGM_BG_2( S_row1, B_inv_for_gf180mcu_fd_sc_mcu7t5v0__addh_4, A );

	wire A_inv_for_gf180mcu_fd_sc_mcu7t5v0__addh_4;

	not MGM_BG_3( A_inv_for_gf180mcu_fd_sc_mcu7t5v0__addh_4, A );

	wire S_row2;

	and MGM_BG_4( S_row2, A_inv_for_gf180mcu_fd_sc_mcu7t5v0__addh_4, B );

	or MGM_BG_5( S, S_row1, S_row2 );

endmodule
module gf180mcu_fd_sc_mcu7t5v0__and2_1( A1, A2, Z );
input A1, A2;
output Z;

	and MGM_BG_0( Z, A1, A2 );

endmodule
module gf180mcu_fd_sc_mcu7t5v0__and2_2( A1, A2, Z );
input A1, A2;
output Z;

	and MGM_BG_0( Z, A1, A2 );

endmodule
module gf180mcu_fd_sc_mcu7t5v0__and2_4( A2, A1, Z );
input A1, A2;
output Z;

	and MGM_BG_0( Z, A1, A2 );

endmodule
module gf180mcu_fd_sc_mcu7t5v0__and3_1( A1, A2, A3, Z );
input A1, A2, A3;
output Z;

	and MGM_BG_0( Z, A1, A2, A3 );

endmodule
module gf180mcu_fd_sc_mcu7t5v0__and3_2( A1, A2, A3, Z );
input A1, A2, A3;
output Z;

	and MGM_BG_0( Z, A1, A2, A3 );

endmodule
module gf180mcu_fd_sc_mcu7t5v0__and3_4( A3, A2, A1, Z );
input A1, A2, A3;
output Z;

	and MGM_BG_0( Z, A1, A2, A3 );

endmodule
module gf180mcu_fd_sc_mcu7t5v0__and4_1( A1, A2, A3, A4, Z );
input A1, A2, A3, A4;
output Z;

	and MGM_BG_0( Z, A1, A2, A3, A4 );

endmodule
module gf180mcu_fd_sc_mcu7t5v0__and4_2( A1, A2, A3, A4, Z );
input A1, A2, A3, A4;
output Z;

	and MGM_BG_0( Z, A1, A2, A3, A4 );

endmodule
module gf180mcu_fd_sc_mcu7t5v0__and4_4( A4, A3, A1, A2, Z );
input A1, A2, A3, A4;
output Z;

	and MGM_BG_0( Z, A1, A2, A3, A4 );

endmodule
module gf180mcu_fd_sc_mcu7t5v0__antenna( I );
input I;

endmodule
module gf180mcu_fd_sc_mcu7t5v0__aoi21_1( A2, ZN, A1, B );
input A1, A2, B;
output ZN;

	wire A1_inv_for_gf180mcu_fd_sc_mcu7t5v0__aoi21_1;

	not MGM_BG_0( A1_inv_for_gf180mcu_fd_sc_mcu7t5v0__aoi21_1, A1 );

	wire B_inv_for_gf180mcu_fd_sc_mcu7t5v0__aoi21_1;

	not MGM_BG_1( B_inv_for_gf180mcu_fd_sc_mcu7t5v0__aoi21_1, B );

	wire ZN_row1;

	and MGM_BG_2( ZN_row1, A1_inv_for_gf180mcu_fd_sc_mcu7t5v0__aoi21_1, B_inv_for_gf180mcu_fd_sc_mcu7t5v0__aoi21_1 );

	wire A2_inv_for_gf180mcu_fd_sc_mcu7t5v0__aoi21_1;

	not MGM_BG_3( A2_inv_for_gf180mcu_fd_sc_mcu7t5v0__aoi21_1, A2 );

	wire ZN_row2;

	and MGM_BG_4( ZN_row2, A2_inv_for_gf180mcu_fd_sc_mcu7t5v0__aoi21_1, B_inv_for_gf180mcu_fd_sc_mcu7t5v0__aoi21_1 );

	or MGM_BG_5( ZN, ZN_row1, ZN_row2 );

endmodule
module gf180mcu_fd_sc_mcu7t5v0__aoi21_2( B, ZN, A2, A1 );
input A1, A2, B;
output ZN;

	wire A1_inv_for_gf180mcu_fd_sc_mcu7t5v0__aoi21_2;

	not MGM_BG_0( A1_inv_for_gf180mcu_fd_sc_mcu7t5v0__aoi21_2, A1 );

	wire B_inv_for_gf180mcu_fd_sc_mcu7t5v0__aoi21_2;

	not MGM_BG_1( B_inv_for_gf180mcu_fd_sc_mcu7t5v0__aoi21_2, B );

	wire ZN_row1;

	and MGM_BG_2( ZN_row1, A1_inv_for_gf180mcu_fd_sc_mcu7t5v0__aoi21_2, B_inv_for_gf180mcu_fd_sc_mcu7t5v0__aoi21_2 );

	wire A2_inv_for_gf180mcu_fd_sc_mcu7t5v0__aoi21_2;

	not MGM_BG_3( A2_inv_for_gf180mcu_fd_sc_mcu7t5v0__aoi21_2, A2 );

	wire ZN_row2;

	and MGM_BG_4( ZN_row2, A2_inv_for_gf180mcu_fd_sc_mcu7t5v0__aoi21_2, B_inv_for_gf180mcu_fd_sc_mcu7t5v0__aoi21_2 );

	or MGM_BG_5( ZN, ZN_row1, ZN_row2 );

endmodule
module gf180mcu_fd_sc_mcu7t5v0__aoi21_4( A2, A1, ZN, B );
input A1, A2, B;
output ZN;

	wire A1_inv_for_gf180mcu_fd_sc_mcu7t5v0__aoi21_4;

	not MGM_BG_0( A1_inv_for_gf180mcu_fd_sc_mcu7t5v0__aoi21_4, A1 );

	wire B_inv_for_gf180mcu_fd_sc_mcu7t5v0__aoi21_4;

	not MGM_BG_1( B_inv_for_gf180mcu_fd_sc_mcu7t5v0__aoi21_4, B );

	wire ZN_row1;

	and MGM_BG_2( ZN_row1, A1_inv_for_gf180mcu_fd_sc_mcu7t5v0__aoi21_4, B_inv_for_gf180mcu_fd_sc_mcu7t5v0__aoi21_4 );

	wire A2_inv_for_gf180mcu_fd_sc_mcu7t5v0__aoi21_4;

	not MGM_BG_3( A2_inv_for_gf180mcu_fd_sc_mcu7t5v0__aoi21_4, A2 );

	wire ZN_row2;

	and MGM_BG_4( ZN_row2, A2_inv_for_gf180mcu_fd_sc_mcu7t5v0__aoi21_4, B_inv_for_gf180mcu_fd_sc_mcu7t5v0__aoi21_4 );

	or MGM_BG_5( ZN, ZN_row1, ZN_row2 );

endmodule
module gf180mcu_fd_sc_mcu7t5v0__aoi211_1( A2, ZN, A1, B, C );
input A1, A2, B, C;
output ZN;

	wire A1_inv_for_gf180mcu_fd_sc_mcu7t5v0__aoi211_1;

	not MGM_BG_0( A1_inv_for_gf180mcu_fd_sc_mcu7t5v0__aoi211_1, A1 );

	wire B_inv_for_gf180mcu_fd_sc_mcu7t5v0__aoi211_1;

	not MGM_BG_1( B_inv_for_gf180mcu_fd_sc_mcu7t5v0__aoi211_1, B );

	wire C_inv_for_gf180mcu_fd_sc_mcu7t5v0__aoi211_1;

	not MGM_BG_2( C_inv_for_gf180mcu_fd_sc_mcu7t5v0__aoi211_1, C );

	wire ZN_row1;

	and MGM_BG_3( ZN_row1, A1_inv_for_gf180mcu_fd_sc_mcu7t5v0__aoi211_1, B_inv_for_gf180mcu_fd_sc_mcu7t5v0__aoi211_1, C_inv_for_gf180mcu_fd_sc_mcu7t5v0__aoi211_1 );

	wire A2_inv_for_gf180mcu_fd_sc_mcu7t5v0__aoi211_1;

	not MGM_BG_4( A2_inv_for_gf180mcu_fd_sc_mcu7t5v0__aoi211_1, A2 );

	wire ZN_row2;

	and MGM_BG_5( ZN_row2, A2_inv_for_gf180mcu_fd_sc_mcu7t5v0__aoi211_1, B_inv_for_gf180mcu_fd_sc_mcu7t5v0__aoi211_1, C_inv_for_gf180mcu_fd_sc_mcu7t5v0__aoi211_1 );

	or MGM_BG_6( ZN, ZN_row1, ZN_row2 );

endmodule
module gf180mcu_fd_sc_mcu7t5v0__aoi211_2( A2, A1, ZN, B, C );
input A1, A2, B, C;
output ZN;

	wire A1_inv_for_gf180mcu_fd_sc_mcu7t5v0__aoi211_2;

	not MGM_BG_0( A1_inv_for_gf180mcu_fd_sc_mcu7t5v0__aoi211_2, A1 );

	wire B_inv_for_gf180mcu_fd_sc_mcu7t5v0__aoi211_2;

	not MGM_BG_1( B_inv_for_gf180mcu_fd_sc_mcu7t5v0__aoi211_2, B );

	wire C_inv_for_gf180mcu_fd_sc_mcu7t5v0__aoi211_2;

	not MGM_BG_2( C_inv_for_gf180mcu_fd_sc_mcu7t5v0__aoi211_2, C );

	wire ZN_row1;

	and MGM_BG_3( ZN_row1, A1_inv_for_gf180mcu_fd_sc_mcu7t5v0__aoi211_2, B_inv_for_gf180mcu_fd_sc_mcu7t5v0__aoi211_2, C_inv_for_gf180mcu_fd_sc_mcu7t5v0__aoi211_2 );

	wire A2_inv_for_gf180mcu_fd_sc_mcu7t5v0__aoi211_2;

	not MGM_BG_4( A2_inv_for_gf180mcu_fd_sc_mcu7t5v0__aoi211_2, A2 );

	wire ZN_row2;

	and MGM_BG_5( ZN_row2, A2_inv_for_gf180mcu_fd_sc_mcu7t5v0__aoi211_2, B_inv_for_gf180mcu_fd_sc_mcu7t5v0__aoi211_2, C_inv_for_gf180mcu_fd_sc_mcu7t5v0__aoi211_2 );

	or MGM_BG_6( ZN, ZN_row1, ZN_row2 );

endmodule
module gf180mcu_fd_sc_mcu7t5v0__aoi211_4( ZN, A2, A1, B, C );
input A1, A2, B, C;
output ZN;

	wire A1_inv_for_gf180mcu_fd_sc_mcu7t5v0__aoi211_4;

	not MGM_BG_0( A1_inv_for_gf180mcu_fd_sc_mcu7t5v0__aoi211_4, A1 );

	wire B_inv_for_gf180mcu_fd_sc_mcu7t5v0__aoi211_4;

	not MGM_BG_1( B_inv_for_gf180mcu_fd_sc_mcu7t5v0__aoi211_4, B );

	wire C_inv_for_gf180mcu_fd_sc_mcu7t5v0__aoi211_4;

	not MGM_BG_2( C_inv_for_gf180mcu_fd_sc_mcu7t5v0__aoi211_4, C );

	wire ZN_row1;

	and MGM_BG_3( ZN_row1, A1_inv_for_gf180mcu_fd_sc_mcu7t5v0__aoi211_4, B_inv_for_gf180mcu_fd_sc_mcu7t5v0__aoi211_4, C_inv_for_gf180mcu_fd_sc_mcu7t5v0__aoi211_4 );

	wire A2_inv_for_gf180mcu_fd_sc_mcu7t5v0__aoi211_4;

	not MGM_BG_4( A2_inv_for_gf180mcu_fd_sc_mcu7t5v0__aoi211_4, A2 );

	wire ZN_row2;

	and MGM_BG_5( ZN_row2, A2_inv_for_gf180mcu_fd_sc_mcu7t5v0__aoi211_4, B_inv_for_gf180mcu_fd_sc_mcu7t5v0__aoi211_4, C_inv_for_gf180mcu_fd_sc_mcu7t5v0__aoi211_4 );

	or MGM_BG_6( ZN, ZN_row1, ZN_row2 );

endmodule
module gf180mcu_fd_sc_mcu7t5v0__aoi22_1( B2, B1, ZN, A1, A2 );
input A1, A2, B1, B2;
output ZN;

	wire A1_inv_for_gf180mcu_fd_sc_mcu7t5v0__aoi22_1;

	not MGM_BG_0( A1_inv_for_gf180mcu_fd_sc_mcu7t5v0__aoi22_1, A1 );

	wire B1_inv_for_gf180mcu_fd_sc_mcu7t5v0__aoi22_1;

	not MGM_BG_1( B1_inv_for_gf180mcu_fd_sc_mcu7t5v0__aoi22_1, B1 );

	wire ZN_row1;

	and MGM_BG_2( ZN_row1, A1_inv_for_gf180mcu_fd_sc_mcu7t5v0__aoi22_1, B1_inv_for_gf180mcu_fd_sc_mcu7t5v0__aoi22_1 );

	wire B2_inv_for_gf180mcu_fd_sc_mcu7t5v0__aoi22_1;

	not MGM_BG_3( B2_inv_for_gf180mcu_fd_sc_mcu7t5v0__aoi22_1, B2 );

	wire ZN_row2;

	and MGM_BG_4( ZN_row2, A1_inv_for_gf180mcu_fd_sc_mcu7t5v0__aoi22_1, B2_inv_for_gf180mcu_fd_sc_mcu7t5v0__aoi22_1 );

	wire A2_inv_for_gf180mcu_fd_sc_mcu7t5v0__aoi22_1;

	not MGM_BG_5( A2_inv_for_gf180mcu_fd_sc_mcu7t5v0__aoi22_1, A2 );

	wire ZN_row3;

	and MGM_BG_6( ZN_row3, A2_inv_for_gf180mcu_fd_sc_mcu7t5v0__aoi22_1, B1_inv_for_gf180mcu_fd_sc_mcu7t5v0__aoi22_1 );

	wire ZN_row4;

	and MGM_BG_7( ZN_row4, A2_inv_for_gf180mcu_fd_sc_mcu7t5v0__aoi22_1, B2_inv_for_gf180mcu_fd_sc_mcu7t5v0__aoi22_1 );

	or MGM_BG_8( ZN, ZN_row1, ZN_row2, ZN_row3, ZN_row4 );

endmodule
module gf180mcu_fd_sc_mcu7t5v0__aoi22_2( B2, B1, ZN, A2, A1 );
input A1, A2, B1, B2;
output ZN;

	wire A1_inv_for_gf180mcu_fd_sc_mcu7t5v0__aoi22_2;

	not MGM_BG_0( A1_inv_for_gf180mcu_fd_sc_mcu7t5v0__aoi22_2, A1 );

	wire B1_inv_for_gf180mcu_fd_sc_mcu7t5v0__aoi22_2;

	not MGM_BG_1( B1_inv_for_gf180mcu_fd_sc_mcu7t5v0__aoi22_2, B1 );

	wire ZN_row1;

	and MGM_BG_2( ZN_row1, A1_inv_for_gf180mcu_fd_sc_mcu7t5v0__aoi22_2, B1_inv_for_gf180mcu_fd_sc_mcu7t5v0__aoi22_2 );

	wire B2_inv_for_gf180mcu_fd_sc_mcu7t5v0__aoi22_2;

	not MGM_BG_3( B2_inv_for_gf180mcu_fd_sc_mcu7t5v0__aoi22_2, B2 );

	wire ZN_row2;

	and MGM_BG_4( ZN_row2, A1_inv_for_gf180mcu_fd_sc_mcu7t5v0__aoi22_2, B2_inv_for_gf180mcu_fd_sc_mcu7t5v0__aoi22_2 );

	wire A2_inv_for_gf180mcu_fd_sc_mcu7t5v0__aoi22_2;

	not MGM_BG_5( A2_inv_for_gf180mcu_fd_sc_mcu7t5v0__aoi22_2, A2 );

	wire ZN_row3;

	and MGM_BG_6( ZN_row3, A2_inv_for_gf180mcu_fd_sc_mcu7t5v0__aoi22_2, B1_inv_for_gf180mcu_fd_sc_mcu7t5v0__aoi22_2 );

	wire ZN_row4;

	and MGM_BG_7( ZN_row4, A2_inv_for_gf180mcu_fd_sc_mcu7t5v0__aoi22_2, B2_inv_for_gf180mcu_fd_sc_mcu7t5v0__aoi22_2 );

	or MGM_BG_8( ZN, ZN_row1, ZN_row2, ZN_row3, ZN_row4 );

endmodule
module gf180mcu_fd_sc_mcu7t5v0__aoi22_4( B2, B1, ZN, A2, A1 );
input A1, A2, B1, B2;
output ZN;

	wire A1_inv_for_gf180mcu_fd_sc_mcu7t5v0__aoi22_4;

	not MGM_BG_0( A1_inv_for_gf180mcu_fd_sc_mcu7t5v0__aoi22_4, A1 );

	wire B1_inv_for_gf180mcu_fd_sc_mcu7t5v0__aoi22_4;

	not MGM_BG_1( B1_inv_for_gf180mcu_fd_sc_mcu7t5v0__aoi22_4, B1 );

	wire ZN_row1;

	and MGM_BG_2( ZN_row1, A1_inv_for_gf180mcu_fd_sc_mcu7t5v0__aoi22_4, B1_inv_for_gf180mcu_fd_sc_mcu7t5v0__aoi22_4 );

	wire B2_inv_for_gf180mcu_fd_sc_mcu7t5v0__aoi22_4;

	not MGM_BG_3( B2_inv_for_gf180mcu_fd_sc_mcu7t5v0__aoi22_4, B2 );

	wire ZN_row2;

	and MGM_BG_4( ZN_row2, A1_inv_for_gf180mcu_fd_sc_mcu7t5v0__aoi22_4, B2_inv_for_gf180mcu_fd_sc_mcu7t5v0__aoi22_4 );

	wire A2_inv_for_gf180mcu_fd_sc_mcu7t5v0__aoi22_4;

	not MGM_BG_5( A2_inv_for_gf180mcu_fd_sc_mcu7t5v0__aoi22_4, A2 );

	wire ZN_row3;

	and MGM_BG_6( ZN_row3, A2_inv_for_gf180mcu_fd_sc_mcu7t5v0__aoi22_4, B1_inv_for_gf180mcu_fd_sc_mcu7t5v0__aoi22_4 );

	wire ZN_row4;

	and MGM_BG_7( ZN_row4, A2_inv_for_gf180mcu_fd_sc_mcu7t5v0__aoi22_4, B2_inv_for_gf180mcu_fd_sc_mcu7t5v0__aoi22_4 );

	or MGM_BG_8( ZN, ZN_row1, ZN_row2, ZN_row3, ZN_row4 );

endmodule
module gf180mcu_fd_sc_mcu7t5v0__aoi221_1( B2, B1, ZN, C, A2, A1 );
input A1, A2, B1, B2, C;
output ZN;

	wire A1_inv_for_gf180mcu_fd_sc_mcu7t5v0__aoi221_1;

	not MGM_BG_0( A1_inv_for_gf180mcu_fd_sc_mcu7t5v0__aoi221_1, A1 );

	wire B1_inv_for_gf180mcu_fd_sc_mcu7t5v0__aoi221_1;

	not MGM_BG_1( B1_inv_for_gf180mcu_fd_sc_mcu7t5v0__aoi221_1, B1 );

	wire C_inv_for_gf180mcu_fd_sc_mcu7t5v0__aoi221_1;

	not MGM_BG_2( C_inv_for_gf180mcu_fd_sc_mcu7t5v0__aoi221_1, C );

	wire ZN_row1;

	and MGM_BG_3( ZN_row1, A1_inv_for_gf180mcu_fd_sc_mcu7t5v0__aoi221_1, B1_inv_for_gf180mcu_fd_sc_mcu7t5v0__aoi221_1, C_inv_for_gf180mcu_fd_sc_mcu7t5v0__aoi221_1 );

	wire B2_inv_for_gf180mcu_fd_sc_mcu7t5v0__aoi221_1;

	not MGM_BG_4( B2_inv_for_gf180mcu_fd_sc_mcu7t5v0__aoi221_1, B2 );

	wire ZN_row2;

	and MGM_BG_5( ZN_row2, A1_inv_for_gf180mcu_fd_sc_mcu7t5v0__aoi221_1, B2_inv_for_gf180mcu_fd_sc_mcu7t5v0__aoi221_1, C_inv_for_gf180mcu_fd_sc_mcu7t5v0__aoi221_1 );

	wire A2_inv_for_gf180mcu_fd_sc_mcu7t5v0__aoi221_1;

	not MGM_BG_6( A2_inv_for_gf180mcu_fd_sc_mcu7t5v0__aoi221_1, A2 );

	wire ZN_row3;

	and MGM_BG_7( ZN_row3, A2_inv_for_gf180mcu_fd_sc_mcu7t5v0__aoi221_1, B1_inv_for_gf180mcu_fd_sc_mcu7t5v0__aoi221_1, C_inv_for_gf180mcu_fd_sc_mcu7t5v0__aoi221_1 );

	wire ZN_row4;

	and MGM_BG_8( ZN_row4, A2_inv_for_gf180mcu_fd_sc_mcu7t5v0__aoi221_1, B2_inv_for_gf180mcu_fd_sc_mcu7t5v0__aoi221_1, C_inv_for_gf180mcu_fd_sc_mcu7t5v0__aoi221_1 );

	or MGM_BG_9( ZN, ZN_row1, ZN_row2, ZN_row3, ZN_row4 );

endmodule
module gf180mcu_fd_sc_mcu7t5v0__aoi221_2( ZN, B2, C, B1, A1, A2 );
input A1, A2, B1, B2, C;
output ZN;

	wire A1_inv_for_gf180mcu_fd_sc_mcu7t5v0__aoi221_2;

	not MGM_BG_0( A1_inv_for_gf180mcu_fd_sc_mcu7t5v0__aoi221_2, A1 );

	wire B1_inv_for_gf180mcu_fd_sc_mcu7t5v0__aoi221_2;

	not MGM_BG_1( B1_inv_for_gf180mcu_fd_sc_mcu7t5v0__aoi221_2, B1 );

	wire C_inv_for_gf180mcu_fd_sc_mcu7t5v0__aoi221_2;

	not MGM_BG_2( C_inv_for_gf180mcu_fd_sc_mcu7t5v0__aoi221_2, C );

	wire ZN_row1;

	and MGM_BG_3( ZN_row1, A1_inv_for_gf180mcu_fd_sc_mcu7t5v0__aoi221_2, B1_inv_for_gf180mcu_fd_sc_mcu7t5v0__aoi221_2, C_inv_for_gf180mcu_fd_sc_mcu7t5v0__aoi221_2 );

	wire B2_inv_for_gf180mcu_fd_sc_mcu7t5v0__aoi221_2;

	not MGM_BG_4( B2_inv_for_gf180mcu_fd_sc_mcu7t5v0__aoi221_2, B2 );

	wire ZN_row2;

	and MGM_BG_5( ZN_row2, A1_inv_for_gf180mcu_fd_sc_mcu7t5v0__aoi221_2, B2_inv_for_gf180mcu_fd_sc_mcu7t5v0__aoi221_2, C_inv_for_gf180mcu_fd_sc_mcu7t5v0__aoi221_2 );

	wire A2_inv_for_gf180mcu_fd_sc_mcu7t5v0__aoi221_2;

	not MGM_BG_6( A2_inv_for_gf180mcu_fd_sc_mcu7t5v0__aoi221_2, A2 );

	wire ZN_row3;

	and MGM_BG_7( ZN_row3, A2_inv_for_gf180mcu_fd_sc_mcu7t5v0__aoi221_2, B1_inv_for_gf180mcu_fd_sc_mcu7t5v0__aoi221_2, C_inv_for_gf180mcu_fd_sc_mcu7t5v0__aoi221_2 );

	wire ZN_row4;

	and MGM_BG_8( ZN_row4, A2_inv_for_gf180mcu_fd_sc_mcu7t5v0__aoi221_2, B2_inv_for_gf180mcu_fd_sc_mcu7t5v0__aoi221_2, C_inv_for_gf180mcu_fd_sc_mcu7t5v0__aoi221_2 );

	or MGM_BG_9( ZN, ZN_row1, ZN_row2, ZN_row3, ZN_row4 );

endmodule
module gf180mcu_fd_sc_mcu7t5v0__aoi221_4( ZN, B2, B1, C, A1, A2 );
input A1, A2, B1, B2, C;
output ZN;

	wire A1_inv_for_gf180mcu_fd_sc_mcu7t5v0__aoi221_4;

	not MGM_BG_0( A1_inv_for_gf180mcu_fd_sc_mcu7t5v0__aoi221_4, A1 );

	wire B1_inv_for_gf180mcu_fd_sc_mcu7t5v0__aoi221_4;

	not MGM_BG_1( B1_inv_for_gf180mcu_fd_sc_mcu7t5v0__aoi221_4, B1 );

	wire C_inv_for_gf180mcu_fd_sc_mcu7t5v0__aoi221_4;

	not MGM_BG_2( C_inv_for_gf180mcu_fd_sc_mcu7t5v0__aoi221_4, C );

	wire ZN_row1;

	and MGM_BG_3( ZN_row1, A1_inv_for_gf180mcu_fd_sc_mcu7t5v0__aoi221_4, B1_inv_for_gf180mcu_fd_sc_mcu7t5v0__aoi221_4, C_inv_for_gf180mcu_fd_sc_mcu7t5v0__aoi221_4 );

	wire B2_inv_for_gf180mcu_fd_sc_mcu7t5v0__aoi221_4;

	not MGM_BG_4( B2_inv_for_gf180mcu_fd_sc_mcu7t5v0__aoi221_4, B2 );

	wire ZN_row2;

	and MGM_BG_5( ZN_row2, A1_inv_for_gf180mcu_fd_sc_mcu7t5v0__aoi221_4, B2_inv_for_gf180mcu_fd_sc_mcu7t5v0__aoi221_4, C_inv_for_gf180mcu_fd_sc_mcu7t5v0__aoi221_4 );

	wire A2_inv_for_gf180mcu_fd_sc_mcu7t5v0__aoi221_4;

	not MGM_BG_6( A2_inv_for_gf180mcu_fd_sc_mcu7t5v0__aoi221_4, A2 );

	wire ZN_row3;

	and MGM_BG_7( ZN_row3, A2_inv_for_gf180mcu_fd_sc_mcu7t5v0__aoi221_4, B1_inv_for_gf180mcu_fd_sc_mcu7t5v0__aoi221_4, C_inv_for_gf180mcu_fd_sc_mcu7t5v0__aoi221_4 );

	wire ZN_row4;

	and MGM_BG_8( ZN_row4, A2_inv_for_gf180mcu_fd_sc_mcu7t5v0__aoi221_4, B2_inv_for_gf180mcu_fd_sc_mcu7t5v0__aoi221_4, C_inv_for_gf180mcu_fd_sc_mcu7t5v0__aoi221_4 );

	or MGM_BG_9( ZN, ZN_row1, ZN_row2, ZN_row3, ZN_row4 );

endmodule
module gf180mcu_fd_sc_mcu7t5v0__aoi222_1( C2, C1, B1, ZN, B2, A2, A1 );
input A1, A2, B1, B2, C1, C2;
output ZN;

	wire A1_inv_for_gf180mcu_fd_sc_mcu7t5v0__aoi222_1;

	not MGM_BG_0( A1_inv_for_gf180mcu_fd_sc_mcu7t5v0__aoi222_1, A1 );

	wire B1_inv_for_gf180mcu_fd_sc_mcu7t5v0__aoi222_1;

	not MGM_BG_1( B1_inv_for_gf180mcu_fd_sc_mcu7t5v0__aoi222_1, B1 );

	wire C1_inv_for_gf180mcu_fd_sc_mcu7t5v0__aoi222_1;

	not MGM_BG_2( C1_inv_for_gf180mcu_fd_sc_mcu7t5v0__aoi222_1, C1 );

	wire ZN_row1;

	and MGM_BG_3( ZN_row1, A1_inv_for_gf180mcu_fd_sc_mcu7t5v0__aoi222_1, B1_inv_for_gf180mcu_fd_sc_mcu7t5v0__aoi222_1, C1_inv_for_gf180mcu_fd_sc_mcu7t5v0__aoi222_1 );

	wire C2_inv_for_gf180mcu_fd_sc_mcu7t5v0__aoi222_1;

	not MGM_BG_4( C2_inv_for_gf180mcu_fd_sc_mcu7t5v0__aoi222_1, C2 );

	wire ZN_row2;

	and MGM_BG_5( ZN_row2, A1_inv_for_gf180mcu_fd_sc_mcu7t5v0__aoi222_1, B1_inv_for_gf180mcu_fd_sc_mcu7t5v0__aoi222_1, C2_inv_for_gf180mcu_fd_sc_mcu7t5v0__aoi222_1 );

	wire B2_inv_for_gf180mcu_fd_sc_mcu7t5v0__aoi222_1;

	not MGM_BG_6( B2_inv_for_gf180mcu_fd_sc_mcu7t5v0__aoi222_1, B2 );

	wire ZN_row3;

	and MGM_BG_7( ZN_row3, A1_inv_for_gf180mcu_fd_sc_mcu7t5v0__aoi222_1, B2_inv_for_gf180mcu_fd_sc_mcu7t5v0__aoi222_1, C1_inv_for_gf180mcu_fd_sc_mcu7t5v0__aoi222_1 );

	wire ZN_row4;

	and MGM_BG_8( ZN_row4, A1_inv_for_gf180mcu_fd_sc_mcu7t5v0__aoi222_1, B2_inv_for_gf180mcu_fd_sc_mcu7t5v0__aoi222_1, C2_inv_for_gf180mcu_fd_sc_mcu7t5v0__aoi222_1 );

	wire A2_inv_for_gf180mcu_fd_sc_mcu7t5v0__aoi222_1;

	not MGM_BG_9( A2_inv_for_gf180mcu_fd_sc_mcu7t5v0__aoi222_1, A2 );

	wire ZN_row5;

	and MGM_BG_10( ZN_row5, A2_inv_for_gf180mcu_fd_sc_mcu7t5v0__aoi222_1, B1_inv_for_gf180mcu_fd_sc_mcu7t5v0__aoi222_1, C1_inv_for_gf180mcu_fd_sc_mcu7t5v0__aoi222_1 );

	wire ZN_row6;

	and MGM_BG_11( ZN_row6, A2_inv_for_gf180mcu_fd_sc_mcu7t5v0__aoi222_1, B1_inv_for_gf180mcu_fd_sc_mcu7t5v0__aoi222_1, C2_inv_for_gf180mcu_fd_sc_mcu7t5v0__aoi222_1 );

	wire ZN_row7;

	and MGM_BG_12( ZN_row7, A2_inv_for_gf180mcu_fd_sc_mcu7t5v0__aoi222_1, B2_inv_for_gf180mcu_fd_sc_mcu7t5v0__aoi222_1, C1_inv_for_gf180mcu_fd_sc_mcu7t5v0__aoi222_1 );

	wire ZN_row8;

	and MGM_BG_13( ZN_row8, A2_inv_for_gf180mcu_fd_sc_mcu7t5v0__aoi222_1, B2_inv_for_gf180mcu_fd_sc_mcu7t5v0__aoi222_1, C2_inv_for_gf180mcu_fd_sc_mcu7t5v0__aoi222_1 );

	or MGM_BG_14( ZN, ZN_row1, ZN_row2, ZN_row3, ZN_row4, ZN_row5, ZN_row6, ZN_row7, ZN_row8 );

endmodule
module gf180mcu_fd_sc_mcu7t5v0__aoi222_2( ZN, C2, C1, B2, B1, A1, A2 );
input A1, A2, B1, B2, C1, C2;
output ZN;

	wire A1_inv_for_gf180mcu_fd_sc_mcu7t5v0__aoi222_2;

	not MGM_BG_0( A1_inv_for_gf180mcu_fd_sc_mcu7t5v0__aoi222_2, A1 );

	wire B1_inv_for_gf180mcu_fd_sc_mcu7t5v0__aoi222_2;

	not MGM_BG_1( B1_inv_for_gf180mcu_fd_sc_mcu7t5v0__aoi222_2, B1 );

	wire C1_inv_for_gf180mcu_fd_sc_mcu7t5v0__aoi222_2;

	not MGM_BG_2( C1_inv_for_gf180mcu_fd_sc_mcu7t5v0__aoi222_2, C1 );

	wire ZN_row1;

	and MGM_BG_3( ZN_row1, A1_inv_for_gf180mcu_fd_sc_mcu7t5v0__aoi222_2, B1_inv_for_gf180mcu_fd_sc_mcu7t5v0__aoi222_2, C1_inv_for_gf180mcu_fd_sc_mcu7t5v0__aoi222_2 );

	wire C2_inv_for_gf180mcu_fd_sc_mcu7t5v0__aoi222_2;

	not MGM_BG_4( C2_inv_for_gf180mcu_fd_sc_mcu7t5v0__aoi222_2, C2 );

	wire ZN_row2;

	and MGM_BG_5( ZN_row2, A1_inv_for_gf180mcu_fd_sc_mcu7t5v0__aoi222_2, B1_inv_for_gf180mcu_fd_sc_mcu7t5v0__aoi222_2, C2_inv_for_gf180mcu_fd_sc_mcu7t5v0__aoi222_2 );

	wire B2_inv_for_gf180mcu_fd_sc_mcu7t5v0__aoi222_2;

	not MGM_BG_6( B2_inv_for_gf180mcu_fd_sc_mcu7t5v0__aoi222_2, B2 );

	wire ZN_row3;

	and MGM_BG_7( ZN_row3, A1_inv_for_gf180mcu_fd_sc_mcu7t5v0__aoi222_2, B2_inv_for_gf180mcu_fd_sc_mcu7t5v0__aoi222_2, C1_inv_for_gf180mcu_fd_sc_mcu7t5v0__aoi222_2 );

	wire ZN_row4;

	and MGM_BG_8( ZN_row4, A1_inv_for_gf180mcu_fd_sc_mcu7t5v0__aoi222_2, B2_inv_for_gf180mcu_fd_sc_mcu7t5v0__aoi222_2, C2_inv_for_gf180mcu_fd_sc_mcu7t5v0__aoi222_2 );

	wire A2_inv_for_gf180mcu_fd_sc_mcu7t5v0__aoi222_2;

	not MGM_BG_9( A2_inv_for_gf180mcu_fd_sc_mcu7t5v0__aoi222_2, A2 );

	wire ZN_row5;

	and MGM_BG_10( ZN_row5, A2_inv_for_gf180mcu_fd_sc_mcu7t5v0__aoi222_2, B1_inv_for_gf180mcu_fd_sc_mcu7t5v0__aoi222_2, C1_inv_for_gf180mcu_fd_sc_mcu7t5v0__aoi222_2 );

	wire ZN_row6;

	and MGM_BG_11( ZN_row6, A2_inv_for_gf180mcu_fd_sc_mcu7t5v0__aoi222_2, B1_inv_for_gf180mcu_fd_sc_mcu7t5v0__aoi222_2, C2_inv_for_gf180mcu_fd_sc_mcu7t5v0__aoi222_2 );

	wire ZN_row7;

	and MGM_BG_12( ZN_row7, A2_inv_for_gf180mcu_fd_sc_mcu7t5v0__aoi222_2, B2_inv_for_gf180mcu_fd_sc_mcu7t5v0__aoi222_2, C1_inv_for_gf180mcu_fd_sc_mcu7t5v0__aoi222_2 );

	wire ZN_row8;

	and MGM_BG_13( ZN_row8, A2_inv_for_gf180mcu_fd_sc_mcu7t5v0__aoi222_2, B2_inv_for_gf180mcu_fd_sc_mcu7t5v0__aoi222_2, C2_inv_for_gf180mcu_fd_sc_mcu7t5v0__aoi222_2 );

	or MGM_BG_14( ZN, ZN_row1, ZN_row2, ZN_row3, ZN_row4, ZN_row5, ZN_row6, ZN_row7, ZN_row8 );

endmodule
module gf180mcu_fd_sc_mcu7t5v0__aoi222_4( ZN, C2, C1, B1, B2, A2, A1 );
input A1, A2, B1, B2, C1, C2;
output ZN;

	wire A1_inv_for_gf180mcu_fd_sc_mcu7t5v0__aoi222_4;

	not MGM_BG_0( A1_inv_for_gf180mcu_fd_sc_mcu7t5v0__aoi222_4, A1 );

	wire B1_inv_for_gf180mcu_fd_sc_mcu7t5v0__aoi222_4;

	not MGM_BG_1( B1_inv_for_gf180mcu_fd_sc_mcu7t5v0__aoi222_4, B1 );

	wire C1_inv_for_gf180mcu_fd_sc_mcu7t5v0__aoi222_4;

	not MGM_BG_2( C1_inv_for_gf180mcu_fd_sc_mcu7t5v0__aoi222_4, C1 );

	wire ZN_row1;

	and MGM_BG_3( ZN_row1, A1_inv_for_gf180mcu_fd_sc_mcu7t5v0__aoi222_4, B1_inv_for_gf180mcu_fd_sc_mcu7t5v0__aoi222_4, C1_inv_for_gf180mcu_fd_sc_mcu7t5v0__aoi222_4 );

	wire C2_inv_for_gf180mcu_fd_sc_mcu7t5v0__aoi222_4;

	not MGM_BG_4( C2_inv_for_gf180mcu_fd_sc_mcu7t5v0__aoi222_4, C2 );

	wire ZN_row2;

	and MGM_BG_5( ZN_row2, A1_inv_for_gf180mcu_fd_sc_mcu7t5v0__aoi222_4, B1_inv_for_gf180mcu_fd_sc_mcu7t5v0__aoi222_4, C2_inv_for_gf180mcu_fd_sc_mcu7t5v0__aoi222_4 );

	wire B2_inv_for_gf180mcu_fd_sc_mcu7t5v0__aoi222_4;

	not MGM_BG_6( B2_inv_for_gf180mcu_fd_sc_mcu7t5v0__aoi222_4, B2 );

	wire ZN_row3;

	and MGM_BG_7( ZN_row3, A1_inv_for_gf180mcu_fd_sc_mcu7t5v0__aoi222_4, B2_inv_for_gf180mcu_fd_sc_mcu7t5v0__aoi222_4, C1_inv_for_gf180mcu_fd_sc_mcu7t5v0__aoi222_4 );

	wire ZN_row4;

	and MGM_BG_8( ZN_row4, A1_inv_for_gf180mcu_fd_sc_mcu7t5v0__aoi222_4, B2_inv_for_gf180mcu_fd_sc_mcu7t5v0__aoi222_4, C2_inv_for_gf180mcu_fd_sc_mcu7t5v0__aoi222_4 );

	wire A2_inv_for_gf180mcu_fd_sc_mcu7t5v0__aoi222_4;

	not MGM_BG_9( A2_inv_for_gf180mcu_fd_sc_mcu7t5v0__aoi222_4, A2 );

	wire ZN_row5;

	and MGM_BG_10( ZN_row5, A2_inv_for_gf180mcu_fd_sc_mcu7t5v0__aoi222_4, B1_inv_for_gf180mcu_fd_sc_mcu7t5v0__aoi222_4, C1_inv_for_gf180mcu_fd_sc_mcu7t5v0__aoi222_4 );

	wire ZN_row6;

	and MGM_BG_11( ZN_row6, A2_inv_for_gf180mcu_fd_sc_mcu7t5v0__aoi222_4, B1_inv_for_gf180mcu_fd_sc_mcu7t5v0__aoi222_4, C2_inv_for_gf180mcu_fd_sc_mcu7t5v0__aoi222_4 );

	wire ZN_row7;

	and MGM_BG_12( ZN_row7, A2_inv_for_gf180mcu_fd_sc_mcu7t5v0__aoi222_4, B2_inv_for_gf180mcu_fd_sc_mcu7t5v0__aoi222_4, C1_inv_for_gf180mcu_fd_sc_mcu7t5v0__aoi222_4 );

	wire ZN_row8;

	and MGM_BG_13( ZN_row8, A2_inv_for_gf180mcu_fd_sc_mcu7t5v0__aoi222_4, B2_inv_for_gf180mcu_fd_sc_mcu7t5v0__aoi222_4, C2_inv_for_gf180mcu_fd_sc_mcu7t5v0__aoi222_4 );

	or MGM_BG_14( ZN, ZN_row1, ZN_row2, ZN_row3, ZN_row4, ZN_row5, ZN_row6, ZN_row7, ZN_row8 );

endmodule
module gf180mcu_fd_sc_mcu7t5v0__buf_1( I, Z );
input I;
output Z;

	buf MGM_BG_0( Z, I );

endmodule
module gf180mcu_fd_sc_mcu7t5v0__buf_12( I, Z );
input I;
output Z;

	buf MGM_BG_0( Z, I );

endmodule
module gf180mcu_fd_sc_mcu7t5v0__buf_16( I, Z );
input I;
output Z;

	buf MGM_BG_0( Z, I );

endmodule
module gf180mcu_fd_sc_mcu7t5v0__buf_2( I, Z );
input I;
output Z;

	buf MGM_BG_0( Z, I );

endmodule
module gf180mcu_fd_sc_mcu7t5v0__buf_20( I, Z );
input I;
output Z;

	buf MGM_BG_0( Z, I );

endmodule
module gf180mcu_fd_sc_mcu7t5v0__buf_3( I, Z );
input I;
output Z;

	buf MGM_BG_0( Z, I );

endmodule
module gf180mcu_fd_sc_mcu7t5v0__buf_4( I, Z );
input I;
output Z;

	buf MGM_BG_0( Z, I );

endmodule
module gf180mcu_fd_sc_mcu7t5v0__buf_8( I, Z );
input I;
output Z;

	buf MGM_BG_0( Z, I );

endmodule
module gf180mcu_fd_sc_mcu7t5v0__bufz_1( EN, I, Z );
input EN, I;
output Z;

	wire MGM_WB_0;

	wire MGM_WB_1;

	and MGM_BG_0( MGM_WB_0, EN, I );

	not MGM_BG_1( MGM_WB_1, EN );

	bufif0 MGM_BG_2( Z, MGM_WB_0,MGM_WB_1 );

endmodule
module gf180mcu_fd_sc_mcu7t5v0__bufz_12( EN, I, Z );
input EN, I;
output Z;

	wire MGM_WB_0;

	wire MGM_WB_1;

	and MGM_BG_0( MGM_WB_0, EN, I );

	not MGM_BG_1( MGM_WB_1, EN );

	bufif0 MGM_BG_2( Z, MGM_WB_0,MGM_WB_1 );

endmodule
module gf180mcu_fd_sc_mcu7t5v0__bufz_16( EN, I, Z );
input EN, I;
output Z;

	wire MGM_WB_0;

	wire MGM_WB_1;

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

	bufif0 MGM_BG_3( ZN, MGM_WB_0,MGM_WB_1 );

endmodule
module gf180mcu_fd_sc_mcu7t5v0__invz_3( EN, I, ZN );
input EN, I;
output ZN;

	wire MGM_WB_0;

	wire MGM_WB_1;

	wire I_inv_for_gf180mcu_fd_sc_mcu7t5v0__invz_3;

	not MGM_BG_0( I_inv_for_gf180mcu_fd_sc_mcu7t5v0__invz_3, I );

	and MGM_BG_1( MGM_WB_0, I_inv_for_gf180mcu_fd_sc_mcu7t5v0__invz_3, EN );

	not MGM_BG_2( MGM_WB_1, EN );

	bufif0 MGM_BG_3( ZN, MGM_WB_0,MGM_WB_1 );

endmodule
module gf180mcu_fd_sc_mcu7t5v0__invz_4( EN, I, ZN );
input EN, I;
output ZN;

	wire MGM_WB_0;

	wire MGM_WB_1;

	wire I_inv_for_gf180mcu_fd_sc_mcu7t5v0__invz_4;

	not MGM_BG_0( I_inv_for_gf180mcu_fd_sc_mcu7t5v0__invz_4, I );

	and MGM_BG_1( MGM_WB_0, I_inv_for_gf180mcu_fd_sc_mcu7t5v0__invz_4, EN );

	not MGM_BG_2( MGM_WB_1, EN );

	bufif0 MGM_BG_3( ZN, MGM_WB_0,MGM_WB_1 );

endmodule
module gf180mcu_fd_sc_mcu7t5v0__invz_8( EN, I, ZN );
input EN, I;
output ZN;

	wire MGM_WB_0;

	wire MGM_WB_1;

	wire I_inv_for_gf180mcu_fd_sc_mcu7t5v0__invz_8;

	not MGM_BG_0( I_inv_for_gf180mcu_fd_sc_mcu7t5v0__invz_8, I );

	and MGM_BG_1( MGM_WB_0, I_inv_for_gf180mcu_fd_sc_mcu7t5v0__invz_8, EN );

	not MGM_BG_2( MGM_WB_1, EN );

	bufif0 MGM_BG_3( ZN, MGM_WB_0,MGM_WB_1 );

endmodule
module gf180mcu_fd_sc_mcu7t5v0__mux2_1( Z, I1, S, I0 );
input I0, I1, S;
output Z;

	wire Z_row1;

	and MGM_BG_0( Z_row1, I0, I1 );

	wire S_inv_for_gf180mcu_fd_sc_mcu7t5v0__mux2_1;

	not MGM_BG_1( S_inv_for_gf180mcu_fd_sc_mcu7t5v0__mux2_1, S );

	wire Z_row2;

	and MGM_BG_2( Z_row2, S_inv_for_gf180mcu_fd_sc_mcu7t5v0__mux2_1, I0 );

	wire Z_row3;

	and MGM_BG_3( Z_row3, I1, S );

	or MGM_BG_4( Z, Z_row1, Z_row2, Z_row3 );

endmodule
module gf180mcu_fd_sc_mcu7t5v0__mux2_2( Z, I1, S, I0 );
input I0, I1, S;
output Z;

	wire Z_row1;

	and MGM_BG_0( Z_row1, I0, I1 );

	wire S_inv_for_gf180mcu_fd_sc_mcu7t5v0__mux2_2;

	not MGM_BG_1( S_inv_for_gf180mcu_fd_sc_mcu7t5v0__mux2_2, S );

	wire Z_row2;

	and MGM_BG_2( Z_row2, S_inv_for_gf180mcu_fd_sc_mcu7t5v0__mux2_2, I0 );

	wire Z_row3;

	and MGM_BG_3( Z_row3, I1, S );

	or MGM_BG_4( Z, Z_row1, Z_row2, Z_row3 );

endmodule
module gf180mcu_fd_sc_mcu7t5v0__mux2_4( Z, I1, S, I0 );
input I0, I1, S;
output Z;

	wire Z_row1;

	and MGM_BG_0( Z_row1, I0, I1 );

	wire S_inv_for_gf180mcu_fd_sc_mcu7t5v0__mux2_4;

	not MGM_BG_1( S_inv_for_gf180mcu_fd_sc_mcu7t5v0__mux2_4, S );

	wire Z_row2;

	and MGM_BG_2( Z_row2, S_inv_for_gf180mcu_fd_sc_mcu7t5v0__mux2_4, I0 );

	wire Z_row3;

	and MGM_BG_3( Z_row3, I1, S );

	or MGM_BG_4( Z, Z_row1, Z_row2, Z_row3 );

endmodule
module gf180mcu_fd_sc_mcu7t5v0__mux4_1( I2, S0, I3, Z, S1, I1, I0 );
input I0, I1, I2, I3, S0, S1;
output Z;

	wire S0_inv_for_gf180mcu_fd_sc_mcu7t5v0__mux4_1;

	not MGM_BG_0( S0_inv_for_gf180mcu_fd_sc_mcu7t5v0__mux4_1, S0 );

	wire S1_inv_for_gf180mcu_fd_sc_mcu7t5v0__mux4_1;

	not MGM_BG_1( S1_inv_for_gf180mcu_fd_sc_mcu7t5v0__mux4_1, S1 );

	wire Z_row1;

	and MGM_BG_2( Z_row1, S0_inv_for_gf180mcu_fd_sc_mcu7t5v0__mux4_1, S1_inv_for_gf180mcu_fd_sc_mcu7t5v0__mux4_1, I0 );

	wire Z_row2;

	and MGM_BG_3( Z_row2, S1_inv_for_gf180mcu_fd_sc_mcu7t5v0__mux4_1, I1, S0 );

	wire Z_row3;

	and MGM_BG_4( Z_row3, S0_inv_for_gf180mcu_fd_sc_mcu7t5v0__mux4_1, I2, S1 );

	wire Z_row4;

	and MGM_BG_5( Z_row4, I3, S0, S1 );

	or MGM_BG_6( Z, Z_row1, Z_row2, Z_row3, Z_row4 );

endmodule
module gf180mcu_fd_sc_mcu7t5v0__mux4_2( I2, S0, I3, Z, S1, I1, I0 );
input I0, I1, I2, I3, S0, S1;
output Z;

	wire S0_inv_for_gf180mcu_fd_sc_mcu7t5v0__mux4_2;

	not MGM_BG_0( S0_inv_for_gf180mcu_fd_sc_mcu7t5v0__mux4_2, S0 );

	wire S1_inv_for_gf180mcu_fd_sc_mcu7t5v0__mux4_2;

	not MGM_BG_1( S1_inv_for_gf180mcu_fd_sc_mcu7t5v0__mux4_2, S1 );

	wire Z_row1;

	and MGM_BG_2( Z_row1, S0_inv_for_gf180mcu_fd_sc_mcu7t5v0__mux4_2, S1_inv_for_gf180mcu_fd_sc_mcu7t5v0__mux4_2, I0 );

	wire Z_row2;

	and MGM_BG_3( Z_row2, S1_inv_for_gf180mcu_fd_sc_mcu7t5v0__mux4_2, I1, S0 );

	wire Z_row3;

	and MGM_BG_4( Z_row3, S0_inv_for_gf180mcu_fd_sc_mcu7t5v0__mux4_2, I2, S1 );

	wire Z_row4;

	and MGM_BG_5( Z_row4, I3, S0, S1 );

	or MGM_BG_6( Z, Z_row1, Z_row2, Z_row3, Z_row4 );

endmodule
module gf180mcu_fd_sc_mcu7t5v0__mux4_4( I2, S0, I3, Z, S1, I1, I0 );
input I0, I1, I2, I3, S0, S1;
output Z;

	wire S0_inv_for_gf180mcu_fd_sc_mcu7t5v0__mux4_4;

	not MGM_BG_0( S0_inv_for_gf180mcu_fd_sc_mcu7t5v0__mux4_4, S0 );

	wire S1_inv_for_gf180mcu_fd_sc_mcu7t5v0__mux4_4;

	not MGM_BG_1( S1_inv_for_gf180mcu_fd_sc_mcu7t5v0__mux4_4, S1 );

	wire Z_row1;

	and MGM_BG_2( Z_row1, S0_inv_for_gf180mcu_fd_sc_mcu7t5v0__mux4_4, S1_inv_for_gf180mcu_fd_sc_mcu7t5v0__mux4_4, I0 );

	wire Z_row2;

	and MGM_BG_3( Z_row2, S1_inv_for_gf180mcu_fd_sc_mcu7t5v0__mux4_4, I1, S0 );

	wire Z_row3;

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

	not MGM_BG_3( A4_inv_for_gf180mcu_fd_sc_mcu7t5v0__nor4_2, A4 );

	and MGM_BG_4( ZN, A1_inv_for_gf180mcu_fd_sc_mcu7t5v0__nor4_2, A2_inv_for_gf180mcu_fd_sc_mcu7t5v0__nor4_2, A3_inv_for_gf180mcu_fd_sc_mcu7t5v0__nor4_2, A4_inv_for_gf180mcu_fd_sc_mcu7t5v0__nor4_2 );

endmodule
module gf180mcu_fd_sc_mcu7t5v0__nor4_4( A4, A3, ZN, A2, A1 );
input A1, A2, A3, A4;
output ZN;

	wire A1_inv_for_gf180mcu_fd_sc_mcu7t5v0__nor4_4;

	not MGM_BG_0( A1_inv_for_gf180mcu_fd_sc_mcu7t5v0__nor4_4, A1 );

	wire A2_inv_for_gf180mcu_fd_sc_mcu7t5v0__nor4_4;

	not MGM_BG_1( A2_inv_for_gf180mcu_fd_sc_mcu7t5v0__nor4_4, A2 );

	wire A3_inv_for_gf180mcu_fd_sc_mcu7t5v0__nor4_4;

	not MGM_BG_2( A3_inv_for_gf180mcu_fd_sc_mcu7t5v0__nor4_4, A3 );

	wire A4_inv_for_gf180mcu_fd_sc_mcu7t5v0__nor4_4;

	not MGM_BG_3( A4_inv_for_gf180mcu_fd_sc_mcu7t5v0__nor4_4, A4 );

	and MGM_BG_4( ZN, A1_inv_for_gf180mcu_fd_sc_mcu7t5v0__nor4_4, A2_inv_for_gf180mcu_fd_sc_mcu7t5v0__nor4_4, A3_inv_for_gf180mcu_fd_sc_mcu7t5v0__nor4_4, A4_inv_for_gf180mcu_fd_sc_mcu7t5v0__nor4_4 );

endmodule
module gf180mcu_fd_sc_mcu7t5v0__oai21_1( A2, ZN, A1, B );
input A1, A2, B;
output ZN;

	wire A1_inv_for_gf180mcu_fd_sc_mcu7t5v0__oai21_1;

	not MGM_BG_0( A1_inv_for_gf180mcu_fd_sc_mcu7t5v0__oai21_1, A1 );

	wire A2_inv_for_gf180mcu_fd_sc_mcu7t5v0__oai21_1;

	not MGM_BG_1( A2_inv_for_gf180mcu_fd_sc_mcu7t5v0__oai21_1, A2 );

	wire ZN_row1;

	and MGM_BG_2( ZN_row1, A1_inv_for_gf180mcu_fd_sc_mcu7t5v0__oai21_1, A2_inv_for_gf180mcu_fd_sc_mcu7t5v0__oai21_1 );

	wire B_inv_for_gf180mcu_fd_sc_mcu7t5v0__oai21_1;

	not MGM_BG_3( B_inv_for_gf180mcu_fd_sc_mcu7t5v0__oai21_1, B );

	or MGM_BG_4( ZN, ZN_row1, B_inv_for_gf180mcu_fd_sc_mcu7t5v0__oai21_1 );

endmodule
module gf180mcu_fd_sc_mcu7t5v0__oai21_2( B, ZN, A2, A1 );
input A1, A2, B;
output ZN;

	wire A1_inv_for_gf180mcu_fd_sc_mcu7t5v0__oai21_2;

	not MGM_BG_0( A1_inv_for_gf180mcu_fd_sc_mcu7t5v0__oai21_2, A1 );

	wire A2_inv_for_gf180mcu_fd_sc_mcu7t5v0__oai21_2;

	not MGM_BG_1( A2_inv_for_gf180mcu_fd_sc_mcu7t5v0__oai21_2, A2 );

	wire ZN_row1;

	and MGM_BG_2( ZN_row1, A1_inv_for_gf180mcu_fd_sc_mcu7t5v0__oai21_2, A2_inv_for_gf180mcu_fd_sc_mcu7t5v0__oai21_2 );

	wire B_inv_for_gf180mcu_fd_sc_mcu7t5v0__oai21_2;

	not MGM_BG_3( B_inv_for_gf180mcu_fd_sc_mcu7t5v0__oai21_2, B );

	or MGM_BG_4( ZN, ZN_row1, B_inv_for_gf180mcu_fd_sc_mcu7t5v0__oai21_2 );

endmodule
module gf180mcu_fd_sc_mcu7t5v0__oai21_4( A2, ZN, A1, B );
input A1, A2, B;
output ZN;

	wire A1_inv_for_gf180mcu_fd_sc_mcu7t5v0__oai21_4;

	not MGM_BG_0( A1_inv_for_gf180mcu_fd_sc_mcu7t5v0__oai21_4, A1 );

	wire A2_inv_for_gf180mcu_fd_sc_mcu7t5v0__oai21_4;

	not MGM_BG_1( A2_inv_for_gf180mcu_fd_sc_mcu7t5v0__oai21_4, A2 );

	wire ZN_row1;

	and MGM_BG_2( ZN_row1, A1_inv_for_gf180mcu_fd_sc_mcu7t5v0__oai21_4, A2_inv_for_gf180mcu_fd_sc_mcu7t5v0__oai21_4 );

	wire B_inv_for_gf180mcu_fd_sc_mcu7t5v0__oai21_4;

	not MGM_BG_3( B_inv_for_gf180mcu_fd_sc_mcu7t5v0__oai21_4, B );

	or MGM_BG_4( ZN, ZN_row1, B_inv_for_gf180mcu_fd_sc_mcu7t5v0__oai21_4 );

endmodule
module gf180mcu_fd_sc_mcu7t5v0__oai211_1( A2, ZN, A1, B, C );
input A1, A2, B, C;
output ZN;

	wire A1_inv_for_gf180mcu_fd_sc_mcu7t5v0__oai211_1;

	not MGM_BG_0( A1_inv_for_gf180mcu_fd_sc_mcu7t5v0__oai211_1, A1 );

	wire A2_inv_for_gf180mcu_fd_sc_mcu7t5v0__oai211_1;

	not MGM_BG_1( A2_inv_for_gf180mcu_fd_sc_mcu7t5v0__oai211_1, A2 );

	wire ZN_row1;

	and MGM_BG_2( ZN_row1, A1_inv_for_gf180mcu_fd_sc_mcu7t5v0__oai211_1, A2_inv_for_gf180mcu_fd_sc_mcu7t5v0__oai211_1 );

	wire B_inv_for_gf180mcu_fd_sc_mcu7t5v0__oai211_1;

	not MGM_BG_3( B_inv_for_gf180mcu_fd_sc_mcu7t5v0__oai211_1, B );

	wire C_inv_for_gf180mcu_fd_sc_mcu7t5v0__oai211_1;

	not MGM_BG_4( C_inv_for_gf180mcu_fd_sc_mcu7t5v0__oai211_1, C );

	or MGM_BG_5( ZN, ZN_row1, B_inv_for_gf180mcu_fd_sc_mcu7t5v0__oai211_1, C_inv_for_gf180mcu_fd_sc_mcu7t5v0__oai211_1 );

endmodule
module gf180mcu_fd_sc_mcu7t5v0__oai211_2( A2, ZN, A1, B, C );
input A1, A2, B, C;
output ZN;

	wire A1_inv_for_gf180mcu_fd_sc_mcu7t5v0__oai211_2;

	not MGM_BG_0( A1_inv_for_gf180mcu_fd_sc_mcu7t5v0__oai211_2, A1 );

	wire A2_inv_for_gf180mcu_fd_sc_mcu7t5v0__oai211_2;

	not MGM_BG_1( A2_inv_for_gf180mcu_fd_sc_mcu7t5v0__oai211_2, A2 );

	wire ZN_row1;

	and MGM_BG_2( ZN_row1, A1_inv_for_gf180mcu_fd_sc_mcu7t5v0__oai211_2, A2_inv_for_gf180mcu_fd_sc_mcu7t5v0__oai211_2 );

	wire B_inv_for_gf180mcu_fd_sc_mcu7t5v0__oai211_2;

	not MGM_BG_3( B_inv_for_gf180mcu_fd_sc_mcu7t5v0__oai211_2, B );

	wire C_inv_for_gf180mcu_fd_sc_mcu7t5v0__oai211_2;

	not MGM_BG_4( C_inv_for_gf180mcu_fd_sc_mcu7t5v0__oai211_2, C );

	or MGM_BG_5( ZN, ZN_row1, B_inv_for_gf180mcu_fd_sc_mcu7t5v0__oai211_2, C_inv_for_gf180mcu_fd_sc_mcu7t5v0__oai211_2 );

endmodule
module gf180mcu_fd_sc_mcu7t5v0__oai211_4( A2, ZN, A1, B, C );
input A1, A2, B, C;
output ZN;

	wire A1_inv_for_gf180mcu_fd_sc_mcu7t5v0__oai211_4;

	not MGM_BG_0( A1_inv_for_gf180mcu_fd_sc_mcu7t5v0__oai211_4, A1 );

	wire A2_inv_for_gf180mcu_fd_sc_mcu7t5v0__oai211_4;

	not MGM_BG_1( A2_inv_for_gf180mcu_fd_sc_mcu7t5v0__oai211_4, A2 );

	wire ZN_row1;

	and MGM_BG_2( ZN_row1, A1_inv_for_gf180mcu_fd_sc_mcu7t5v0__oai211_4, A2_inv_for_gf180mcu_fd_sc_mcu7t5v0__oai211_4 );

	wire B_inv_for_gf180mcu_fd_sc_mcu7t5v0__oai211_4;

	not MGM_BG_3( B_inv_for_gf180mcu_fd_sc_mcu7t5v0__oai211_4, B );

	wire C_inv_for_gf180mcu_fd_sc_mcu7t5v0__oai211_4;

	not MGM_BG_4( C_inv_for_gf180mcu_fd_sc_mcu7t5v0__oai211_4, C );

	or MGM_BG_5( ZN, ZN_row1, B_inv_for_gf180mcu_fd_sc_mcu7t5v0__oai211_4, C_inv_for_gf180mcu_fd_sc_mcu7t5v0__oai211_4 );

endmodule
module gf180mcu_fd_sc_mcu7t5v0__oai22_1( B2, B1, ZN, A1, A2 );
input A1, A2, B1, B2;
output ZN;

	wire A1_inv_for_gf180mcu_fd_sc_mcu7t5v0__oai22_1;

	not MGM_BG_0( A1_inv_for_gf180mcu_fd_sc_mcu7t5v0__oai22_1, A1 );

	wire A2_inv_for_gf180mcu_fd_sc_mcu7t5v0__oai22_1;

	not MGM_BG_1( A2_inv_for_gf180mcu_fd_sc_mcu7t5v0__oai22_1, A2 );

	wire ZN_row1;

	and MGM_BG_2( ZN_row1, A1_inv_for_gf180mcu_fd_sc_mcu7t5v0__oai22_1, A2_inv_for_gf180mcu_fd_sc_mcu7t5v0__oai22_1 );

	wire B1_inv_for_gf180mcu_fd_sc_mcu7t5v0__oai22_1;

	not MGM_BG_3( B1_inv_for_gf180mcu_fd_sc_mcu7t5v0__oai22_1, B1 );

	wire B2_inv_for_gf180mcu_fd_sc_mcu7t5v0__oai22_1;

	not MGM_BG_4( B2_inv_for_gf180mcu_fd_sc_mcu7t5v0__oai22_1, B2 );

	wire ZN_row2;

	and MGM_BG_5( ZN_row2, B1_inv_for_gf180mcu_fd_sc_mcu7t5v0__oai22_1, B2_inv_for_gf180mcu_fd_sc_mcu7t5v0__oai22_1 );

	or MGM_BG_6( ZN, ZN_row1, ZN_row2 );

endmodule
module gf180mcu_fd_sc_mcu7t5v0__oai22_2( B2, B1, ZN, A2, A1 );
input A1, A2, B1, B2;
output ZN;

	wire A1_inv_for_gf180mcu_fd_sc_mcu7t5v0__oai22_2;

	not MGM_BG_0( A1_inv_for_gf180mcu_fd_sc_mcu7t5v0__oai22_2, A1 );

	wire A2_inv_for_gf180mcu_fd_sc_mcu7t5v0__oai22_2;

	not MGM_BG_1( A2_inv_for_gf180mcu_fd_sc_mcu7t5v0__oai22_2, A2 );

	wire ZN_row1;

	and MGM_BG_2( ZN_row1, A1_inv_for_gf180mcu_fd_sc_mcu7t5v0__oai22_2, A2_inv_for_gf180mcu_fd_sc_mcu7t5v0__oai22_2 );

	wire B1_inv_for_gf180mcu_fd_sc_mcu7t5v0__oai22_2;

	not MGM_BG_3( B1_inv_for_gf180mcu_fd_sc_mcu7t5v0__oai22_2, B1 );

	wire B2_inv_for_gf180mcu_fd_sc_mcu7t5v0__oai22_2;

	not MGM_BG_4( B2_inv_for_gf180mcu_fd_sc_mcu7t5v0__oai22_2, B2 );

	wire ZN_row2;

	and MGM_BG_5( ZN_row2, B1_inv_for_gf180mcu_fd_sc_mcu7t5v0__oai22_2, B2_inv_for_gf180mcu_fd_sc_mcu7t5v0__oai22_2 );

	or MGM_BG_6( ZN, ZN_row1, ZN_row2 );

endmodule
module gf180mcu_fd_sc_mcu7t5v0__oai22_4( B2, B1, ZN, A2, A1 );
input A1, A2, B1, B2;
output ZN;

	wire A1_inv_for_gf180mcu_fd_sc_mcu7t5v0__oai22_4;

	not MGM_BG_0( A1_inv_for_gf180mcu_fd_sc_mcu7t5v0__oai22_4, A1 );

	wire A2_inv_for_gf180mcu_fd_sc_mcu7t5v0__oai22_4;

	not MGM_BG_1( A2_inv_for_gf180mcu_fd_sc_mcu7t5v0__oai22_4, A2 );

	wire ZN_row1;

	and MGM_BG_2( ZN_row1, A1_inv_for_gf180mcu_fd_sc_mcu7t5v0__oai22_4, A2_inv_for_gf180mcu_fd_sc_mcu7t5v0__oai22_4 );

	wire B1_inv_for_gf180mcu_fd_sc_mcu7t5v0__oai22_4;

	not MGM_BG_3( B1_inv_for_gf180mcu_fd_sc_mcu7t5v0__oai22_4, B1 );

	wire B2_inv_for_gf180mcu_fd_sc_mcu7t5v0__oai22_4;

	not MGM_BG_4( B2_inv_for_gf180mcu_fd_sc_mcu7t5v0__oai22_4, B2 );

	wire ZN_row2;

	and MGM_BG_5( ZN_row2, B1_inv_for_gf180mcu_fd_sc_mcu7t5v0__oai22_4, B2_inv_for_gf180mcu_fd_sc_mcu7t5v0__oai22_4 );

	or MGM_BG_6( ZN, ZN_row1, ZN_row2 );

endmodule
module gf180mcu_fd_sc_mcu7t5v0__oai221_1( B2, B1, C, ZN, A2, A1 );
input A1, A2, B1, B2, C;
output ZN;

	wire A1_inv_for_gf180mcu_fd_sc_mcu7t5v0__oai221_1;

	not MGM_BG_0( A1_inv_for_gf180mcu_fd_sc_mcu7t5v0__oai221_1, A1 );

	wire A2_inv_for_gf180mcu_fd_sc_mcu7t5v0__oai221_1;

	not MGM_BG_1( A2_inv_for_gf180mcu_fd_sc_mcu7t5v0__oai221_1, A2 );

	wire ZN_row1;

	and MGM_BG_2( ZN_row1, A1_inv_for_gf180mcu_fd_sc_mcu7t5v0__oai221_1, A2_inv_for_gf180mcu_fd_sc_mcu7t5v0__oai221_1 );

	wire B1_inv_for_gf180mcu_fd_sc_mcu7t5v0__oai221_1;

	not MGM_BG_3( B1_inv_for_gf180mcu_fd_sc_mcu7t5v0__oai221_1, B1 );

	wire B2_inv_for_gf180mcu_fd_sc_mcu7t5v0__oai221_1;

	not MGM_BG_4( B2_inv_for_gf180mcu_fd_sc_mcu7t5v0__oai221_1, B2 );

	wire ZN_row2;

	and MGM_BG_5( ZN_row2, B1_inv_for_gf180mcu_fd_sc_mcu7t5v0__oai221_1, B2_inv_for_gf180mcu_fd_sc_mcu7t5v0__oai221_1 );

	wire C_inv_for_gf180mcu_fd_sc_mcu7t5v0__oai221_1;

	not MGM_BG_6( C_inv_for_gf180mcu_fd_sc_mcu7t5v0__oai221_1, C );

	or MGM_BG_7( ZN, ZN_row1, ZN_row2, C_inv_for_gf180mcu_fd_sc_mcu7t5v0__oai221_1 );

endmodule
module gf180mcu_fd_sc_mcu7t5v0__oai221_2( B2, B1, ZN, C, A1, A2 );
input A1, A2, B1, B2, C;
output ZN;

	wire A1_inv_for_gf180mcu_fd_sc_mcu7t5v0__oai221_2;

	not MGM_BG_0( A1_inv_for_gf180mcu_fd_sc_mcu7t5v0__oai221_2, A1 );

	wire A2_inv_for_gf180mcu_fd_sc_mcu7t5v0__oai221_2;

	not MGM_BG_1( A2_inv_for_gf180mcu_fd_sc_mcu7t5v0__oai221_2, A2 );

	wire ZN_row1;

	and MGM_BG_2( ZN_row1, A1_inv_for_gf180mcu_fd_sc_mcu7t5v0__oai221_2, A2_inv_for_gf180mcu_fd_sc_mcu7t5v0__oai221_2 );

	wire B1_inv_for_gf180mcu_fd_sc_mcu7t5v0__oai221_2;

	not MGM_BG_3( B1_inv_for_gf180mcu_fd_sc_mcu7t5v0__oai221_2, B1 );

	wire B2_inv_for_gf180mcu_fd_sc_mcu7t5v0__oai221_2;

	not MGM_BG_4( B2_inv_for_gf180mcu_fd_sc_mcu7t5v0__oai221_2, B2 );

	wire ZN_row2;

	and MGM_BG_5( ZN_row2, B1_inv_for_gf180mcu_fd_sc_mcu7t5v0__oai221_2, B2_inv_for_gf180mcu_fd_sc_mcu7t5v0__oai221_2 );

	wire C_inv_for_gf180mcu_fd_sc_mcu7t5v0__oai221_2;

	not MGM_BG_6( C_inv_for_gf180mcu_fd_sc_mcu7t5v0__oai221_2, C );

	or MGM_BG_7( ZN, ZN_row1, ZN_row2, C_inv_for_gf180mcu_fd_sc_mcu7t5v0__oai221_2 );

endmodule
module gf180mcu_fd_sc_mcu7t5v0__oai221_4( ZN, B1, B2, C, A1, A2 );
input A1, A2, B1, B2, C;
output ZN;

	wire A1_inv_for_gf180mcu_fd_sc_mcu7t5v0__oai221_4;

	not MGM_BG_0( A1_inv_for_gf180mcu_fd_sc_mcu7t5v0__oai221_4, A1 );

	wire A2_inv_for_gf180mcu_fd_sc_mcu7t5v0__oai221_4;

	not MGM_BG_1( A2_inv_for_gf180mcu_fd_sc_mcu7t5v0__oai221_4, A2 );

	wire ZN_row1;

	and MGM_BG_2( ZN_row1, A1_inv_for_gf180mcu_fd_sc_mcu7t5v0__oai221_4, A2_inv_for_gf180mcu_fd_sc_mcu7t5v0__oai221_4 );

	wire B1_inv_for_gf180mcu_fd_sc_mcu7t5v0__oai221_4;

	not MGM_BG_3( B1_inv_for_gf180mcu_fd_sc_mcu7t5v0__oai221_4, B1 );

	wire B2_inv_for_gf180mcu_fd_sc_mcu7t5v0__oai221_4;

	not MGM_BG_4( B2_inv_for_gf180mcu_fd_sc_mcu7t5v0__oai221_4, B2 );

	wire ZN_row2;

	and MGM_BG_5( ZN_row2, B1_inv_for_gf180mcu_fd_sc_mcu7t5v0__oai221_4, B2_inv_for_gf180mcu_fd_sc_mcu7t5v0__oai221_4 );

	wire C_inv_for_gf180mcu_fd_sc_mcu7t5v0__oai221_4;

	not MGM_BG_6( C_inv_for_gf180mcu_fd_sc_mcu7t5v0__oai221_4, C );

	or MGM_BG_7( ZN, ZN_row1, ZN_row2, C_inv_for_gf180mcu_fd_sc_mcu7t5v0__oai221_4 );

endmodule
module gf180mcu_fd_sc_mcu7t5v0__oai222_1( C2, C1, B1, ZN, B2, A2, A1 );
input A1, A2, B1, B2, C1, C2;
output ZN;

	wire A1_inv_for_gf180mcu_fd_sc_mcu7t5v0__oai222_1;

	not MGM_BG_0( A1_inv_for_gf180mcu_fd_sc_mcu7t5v0__oai222_1, A1 );

	wire A2_inv_for_gf180mcu_fd_sc_mcu7t5v0__oai222_1;

	not MGM_BG_1( A2_inv_for_gf180mcu_fd_sc_mcu7t5v0__oai222_1, A2 );

	wire ZN_row1;

	and MGM_BG_2( ZN_row1, A1_inv_for_gf180mcu_fd_sc_mcu7t5v0__oai222_1, A2_inv_for_gf180mcu_fd_sc_mcu7t5v0__oai222_1 );

	wire B1_inv_for_gf180mcu_fd_sc_mcu7t5v0__oai222_1;

	not MGM_BG_3( B1_inv_for_gf180mcu_fd_sc_mcu7t5v0__oai222_1, B1 );

	wire B2_inv_for_gf180mcu_fd_sc_mcu7t5v0__oai222_1;

	not MGM_BG_4( B2_inv_for_gf180mcu_fd_sc_mcu7t5v0__oai222_1, B2 );

	wire ZN_row2;

	and MGM_BG_5( ZN_row2, B1_inv_for_gf180mcu_fd_sc_mcu7t5v0__oai222_1, B2_inv_for_gf180mcu_fd_sc_mcu7t5v0__oai222_1 );

	wire C1_inv_for_gf180mcu_fd_sc_mcu7t5v0__oai222_1;

	not MGM_BG_6( C1_inv_for_gf180mcu_fd_sc_mcu7t5v0__oai222_1, C1 );

	wire C2_inv_for_gf180mcu_fd_sc_mcu7t5v0__oai222_1;

	not MGM_BG_7( C2_inv_for_gf180mcu_fd_sc_mcu7t5v0__oai222_1, C2 );

	wire ZN_row3;

	and MGM_BG_8( ZN_row3, C1_inv_for_gf180mcu_fd_sc_mcu7t5v0__oai222_1, C2_inv_for_gf180mcu_fd_sc_mcu7t5v0__oai222_1 );

	or MGM_BG_9( ZN, ZN_row1, ZN_row2, ZN_row3 );

endmodule
module gf180mcu_fd_sc_mcu7t5v0__oai222_2( ZN, C1, C2, B1, B2, A1, A2 );
input A1, A2, B1, B2, C1, C2;
output ZN;

	wire A1_inv_for_gf180mcu_fd_sc_mcu7t5v0__oai222_2;

	not MGM_BG_0( A1_inv_for_gf180mcu_fd_sc_mcu7t5v0__oai222_2, A1 );

	wire A2_inv_for_gf180mcu_fd_sc_mcu7t5v0__oai222_2;

	not MGM_BG_1( A2_inv_for_gf180mcu_fd_sc_mcu7t5v0__oai222_2, A2 );

	wire ZN_row1;

	and MGM_BG_2( ZN_row1, A1_inv_for_gf180mcu_fd_sc_mcu7t5v0__oai222_2, A2_inv_for_gf180mcu_fd_sc_mcu7t5v0__oai222_2 );

	wire B1_inv_for_gf180mcu_fd_sc_mcu7t5v0__oai222_2;

	not MGM_BG_3( B1_inv_for_gf180mcu_fd_sc_mcu7t5v0__oai222_2, B1 );

	wire B2_inv_for_gf180mcu_fd_sc_mcu7t5v0__oai222_2;

	not MGM_BG_4( B2_inv_for_gf180mcu_fd_sc_mcu7t5v0__oai222_2, B2 );

	wire ZN_row2;

	and MGM_BG_5( ZN_row2, B1_inv_for_gf180mcu_fd_sc_mcu7t5v0__oai222_2, B2_inv_for_gf180mcu_fd_sc_mcu7t5v0__oai222_2 );

	wire C1_inv_for_gf180mcu_fd_sc_mcu7t5v0__oai222_2;

	not MGM_BG_6( C1_inv_for_gf180mcu_fd_sc_mcu7t5v0__oai222_2, C1 );

	wire C2_inv_for_gf180mcu_fd_sc_mcu7t5v0__oai222_2;

	not MGM_BG_7( C2_inv_for_gf180mcu_fd_sc_mcu7t5v0__oai222_2, C2 );

	wire ZN_row3;

	and MGM_BG_8( ZN_row3, C1_inv_for_gf180mcu_fd_sc_mcu7t5v0__oai222_2, C2_inv_for_gf180mcu_fd_sc_mcu7t5v0__oai222_2 );

	or MGM_BG_9( ZN, ZN_row1, ZN_row2, ZN_row3 );

endmodule
module gf180mcu_fd_sc_mcu7t5v0__oai222_4( C1, ZN, C2, B1, B2, A1, A2 );
input A1, A2, B1, B2, C1, C2;
output ZN;

	wire A1_inv_for_gf180mcu_fd_sc_mcu7t5v0__oai222_4;

	not MGM_BG_0( A1_inv_for_gf180mcu_fd_sc_mcu7t5v0__oai222_4, A1 );

	wire A2_inv_for_gf180mcu_fd_sc_mcu7t5v0__oai222_4;

	not MGM_BG_1( A2_inv_for_gf180mcu_fd_sc_mcu7t5v0__oai222_4, A2 );

	wire ZN_row1;

	and MGM_BG_2( ZN_row1, A1_inv_for_gf180mcu_fd_sc_mcu7t5v0__oai222_4, A2_inv_for_gf180mcu_fd_sc_mcu7t5v0__oai222_4 );

	wire B1_inv_for_gf180mcu_fd_sc_mcu7t5v0__oai222_4;

	not MGM_BG_3( B1_inv_for_gf180mcu_fd_sc_mcu7t5v0__oai222_4, B1 );

	wire B2_inv_for_gf180mcu_fd_sc_mcu7t5v0__oai222_4;

	not MGM_BG_4( B2_inv_for_gf180mcu_fd_sc_mcu7t5v0__oai222_4, B2 );

	wire ZN_row2;

	and MGM_BG_5( ZN_row2, B1_inv_for_gf180mcu_fd_sc_mcu7t5v0__oai222_4, B2_inv_for_gf180mcu_fd_sc_mcu7t5v0__oai222_4 );

	wire C1_inv_for_gf180mcu_fd_sc_mcu7t5v0__oai222_4;

	not MGM_BG_6( C1_inv_for_gf180mcu_fd_sc_mcu7t5v0__oai222_4, C1 );

	wire C2_inv_for_gf180mcu_fd_sc_mcu7t5v0__oai222_4;

	not MGM_BG_7( C2_inv_for_gf180mcu_fd_sc_mcu7t5v0__oai222_4, C2 );

	wire ZN_row3;

	and MGM_BG_8( ZN_row3, C1_inv_for_gf180mcu_fd_sc_mcu7t5v0__oai222_4, C2_inv_for_gf180mcu_fd_sc_mcu7t5v0__oai222_4 );

	or MGM_BG_9( ZN, ZN_row1, ZN_row2, ZN_row3 );

endmodule
module gf180mcu_fd_sc_mcu7t5v0__oai31_1( B, A1, ZN, A2, A3 );
input A1, A2, A3, B;
output ZN;

	wire A1_inv_for_gf180mcu_fd_sc_mcu7t5v0__oai31_1;

	not MGM_BG_0( A1_inv_for_gf180mcu_fd_sc_mcu7t5v0__oai31_1, A1 );

	wire A2_inv_for_gf180mcu_fd_sc_mcu7t5v0__oai31_1;

	not MGM_BG_1( A2_inv_for_gf180mcu_fd_sc_mcu7t5v0__oai31_1, A2 );

	wire A3_inv_for_gf180mcu_fd_sc_mcu7t5v0__oai31_1;

	not MGM_BG_2( A3_inv_for_gf180mcu_fd_sc_mcu7t5v0__oai31_1, A3 );

	wire ZN_row1;

	and MGM_BG_3( ZN_row1, A1_inv_for_gf180mcu_fd_sc_mcu7t5v0__oai31_1, A2_inv_for_gf180mcu_fd_sc_mcu7t5v0__oai31_1, A3_inv_for_gf180mcu_fd_sc_mcu7t5v0__oai31_1 );

	wire B_inv_for_gf180mcu_fd_sc_mcu7t5v0__oai31_1;

	not MGM_BG_4( B_inv_for_gf180mcu_fd_sc_mcu7t5v0__oai31_1, B );

	or MGM_BG_5( ZN, ZN_row1, B_inv_for_gf180mcu_fd_sc_mcu7t5v0__oai31_1 );

endmodule
module gf180mcu_fd_sc_mcu7t5v0__oai31_2( B, ZN, A3, A2, A1 );
input A1, A2, A3, B;
output ZN;

	wire A1_inv_for_gf180mcu_fd_sc_mcu7t5v0__oai31_2;

	not MGM_BG_0( A1_inv_for_gf180mcu_fd_sc_mcu7t5v0__oai31_2, A1 );

	wire A2_inv_for_gf180mcu_fd_sc_mcu7t5v0__oai31_2;

	not MGM_BG_1( A2_inv_for_gf180mcu_fd_sc_mcu7t5v0__oai31_2, A2 );

	wire A3_inv_for_gf180mcu_fd_sc_mcu7t5v0__oai31_2;

	not MGM_BG_2( A3_inv_for_gf180mcu_fd_sc_mcu7t5v0__oai31_2, A3 );

	wire ZN_row1;

	and MGM_BG_3( ZN_row1, A1_inv_for_gf180mcu_fd_sc_mcu7t5v0__oai31_2, A2_inv_for_gf180mcu_fd_sc_mcu7t5v0__oai31_2, A3_inv_for_gf180mcu_fd_sc_mcu7t5v0__oai31_2 );

	wire B_inv_for_gf180mcu_fd_sc_mcu7t5v0__oai31_2;

	not MGM_BG_4( B_inv_for_gf180mcu_fd_sc_mcu7t5v0__oai31_2, B );

	or MGM_BG_5( ZN, ZN_row1, B_inv_for_gf180mcu_fd_sc_mcu7t5v0__oai31_2 );

endmodule
module gf180mcu_fd_sc_mcu7t5v0__oai31_4( A3, ZN, A1, A2, B );
input A1, A2, A3, B;
output ZN;

	wire A1_inv_for_gf180mcu_fd_sc_mcu7t5v0__oai31_4;

	not MGM_BG_0( A1_inv_for_gf180mcu_fd_sc_mcu7t5v0__oai31_4, A1 );

	wire A2_inv_for_gf180mcu_fd_sc_mcu7t5v0__oai31_4;

	not MGM_BG_1( A2_inv_for_gf180mcu_fd_sc_mcu7t5v0__oai31_4, A2 );

	wire A3_inv_for_gf180mcu_fd_sc_mcu7t5v0__oai31_4;

	not MGM_BG_2( A3_inv_for_gf180mcu_fd_sc_mcu7t5v0__oai31_4, A3 );

	wire ZN_row1;

	and MGM_BG_3( ZN_row1, A1_inv_for_gf180mcu_fd_sc_mcu7t5v0__oai31_4, A2_inv_for_gf180mcu_fd_sc_mcu7t5v0__oai31_4, A3_inv_for_gf180mcu_fd_sc_mcu7t5v0__oai31_4 );

	wire B_inv_for_gf180mcu_fd_sc_mcu7t5v0__oai31_4;

	not MGM_BG_4( B_inv_for_gf180mcu_fd_sc_mcu7t5v0__oai31_4, B );

	or MGM_BG_5( ZN, ZN_row1, B_inv_for_gf180mcu_fd_sc_mcu7t5v0__oai31_4 );

endmodule
module gf180mcu_fd_sc_mcu7t5v0__oai32_1( A3, A2, A1, ZN, B1, B2 );
input A1, A2, A3, B1, B2;
output ZN;

	wire A1_inv_for_gf180mcu_fd_sc_mcu7t5v0__oai32_1;

	not MGM_BG_0( A1_inv_for_gf180mcu_fd_sc_mcu7t5v0__oai32_1, A1 );

	wire A2_inv_for_gf180mcu_fd_sc_mcu7t5v0__oai32_1;

	not MGM_BG_1( A2_inv_for_gf180mcu_fd_sc_mcu7t5v0__oai32_1, A2 );

	wire A3_inv_for_gf180mcu_fd_sc_mcu7t5v0__oai32_1;

	not MGM_BG_2( A3_inv_for_gf180mcu_fd_sc_mcu7t5v0__oai32_1, A3 );

	wire ZN_row1;

	and MGM_BG_3( ZN_row1, A1_inv_for_gf180mcu_fd_sc_mcu7t5v0__oai32_1, A2_inv_for_gf180mcu_fd_sc_mcu7t5v0__oai32_1, A3_inv_for_gf180mcu_fd_sc_mcu7t5v0__oai32_1 );

	wire B1_inv_for_gf180mcu_fd_sc_mcu7t5v0__oai32_1;

	not MGM_BG_4( B1_inv_for_gf180mcu_fd_sc_mcu7t5v0__oai32_1, B1 );

	wire B2_inv_for_gf180mcu_fd_sc_mcu7t5v0__oai32_1;

	not MGM_BG_5( B2_inv_for_gf180mcu_fd_sc_mcu7t5v0__oai32_1, B2 );

	wire ZN_row2;

	and MGM_BG_6( ZN_row2, B1_inv_for_gf180mcu_fd_sc_mcu7t5v0__oai32_1, B2_inv_for_gf180mcu_fd_sc_mcu7t5v0__oai32_1 );

	or MGM_BG_7( ZN, ZN_row1, ZN_row2 );

endmodule
module gf180mcu_fd_sc_mcu7t5v0__oai32_2( A3, A2, A1, ZN, B2, B1 );
input A1, A2, A3, B1, B2;
output ZN;

	wire A1_inv_for_gf180mcu_fd_sc_mcu7t5v0__oai32_2;

	not MGM_BG_0( A1_inv_for_gf180mcu_fd_sc_mcu7t5v0__oai32_2, A1 );

	wire A2_inv_for_gf180mcu_fd_sc_mcu7t5v0__oai32_2;

	not MGM_BG_1( A2_inv_for_gf180mcu_fd_sc_mcu7t5v0__oai32_2, A2 );

	wire A3_inv_for_gf180mcu_fd_sc_mcu7t5v0__oai32_2;

	not MGM_BG_2( A3_inv_for_gf180mcu_fd_sc_mcu7t5v0__oai32_2, A3 );

	wire ZN_row1;

	and MGM_BG_3( ZN_row1, A1_inv_for_gf180mcu_fd_sc_mcu7t5v0__oai32_2, A2_inv_for_gf180mcu_fd_sc_mcu7t5v0__oai32_2, A3_inv_for_gf180mcu_fd_sc_mcu7t5v0__oai32_2 );

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

	wire A2_inv_for_gf180mcu_fd_sc_mcu7t5v0__oai33_4;

	not MGM_BG_1( A2_inv_for_gf180mcu_fd_sc_mcu7t5v0__oai33_4, A2 );

	wire A3_inv_for_gf180mcu_fd_sc_mcu7t5v0__oai33_4;

	not MGM_BG_2( A3_inv_for_gf180mcu_fd_sc_mcu7t5v0__oai33_4, A3 );

	wire ZN_row1;

	and MGM_BG_3( ZN_row1, A1_inv_for_gf180mcu_fd_sc_mcu7t5v0__oai33_4, A2_inv_for_gf180mcu_fd_sc_mcu7t5v0__oai33_4, A3_inv_for_gf180mcu_fd_sc_mcu7t5v0__oai33_4 );

	wire B1_inv_for_gf180mcu_fd_sc_mcu7t5v0__oai33_4;

	not MGM_BG_4( B1_inv_for_gf180mcu_fd_sc_mcu7t5v0__oai33_4, B1 );

	wire B2_inv_for_gf180mcu_fd_sc_mcu7t5v0__oai33_4;

	not MGM_BG_5( B2_inv_for_gf180mcu_fd_sc_mcu7t5v0__oai33_4, B2 );

	wire B3_inv_for_gf180mcu_fd_sc_mcu7t5v0__oai33_4;

	not MGM_BG_6( B3_inv_for_gf180mcu_fd_sc_mcu7t5v0__oai33_4, B3 );

	wire ZN_row2;

	and MGM_BG_7( ZN_row2, B1_inv_for_gf180mcu_fd_sc_mcu7t5v0__oai33_4, B2_inv_for_gf180mcu_fd_sc_mcu7t5v0__oai33_4, B3_inv_for_gf180mcu_fd_sc_mcu7t5v0__oai33_4 );

	or MGM_BG_8( ZN, ZN_row1, ZN_row2 );

endmodule
module gf180mcu_fd_sc_mcu7t5v0__or2_1( A1, A2, Z );
input A1, A2;
output Z;

	or MGM_BG_0( Z, A1, A2 );

endmodule
module gf180mcu_fd_sc_mcu7t5v0__or2_2( A1, A2, Z );
input A1, A2;
output Z;

	or MGM_BG_0( Z, A1, A2 );

endmodule
module gf180mcu_fd_sc_mcu7t5v0__or2_4( A2, A1, Z );
input A1, A2;
output Z;

	or MGM_BG_0( Z, A1, A2 );

endmodule
module gf180mcu_fd_sc_mcu7t5v0__or3_1( A1, A2, A3, Z );
input A1, A2, A3;
output Z;

	or MGM_BG_0( Z, A1, A2, A3 );

endmodule
module gf180mcu_fd_sc_mcu7t5v0__or3_2( A1, A2, A3, Z );
input A1, A2, A3;
output Z;

	or MGM_BG_0( Z, A1, A2, A3 );

endmodule
module gf180mcu_fd_sc_mcu7t5v0__or3_4( A3, A2, A1, Z );
input A1, A2, A3;
output Z;

	or MGM_BG_0( Z, A1, A2, A3 );

endmodule
module gf180mcu_fd_sc_mcu7t5v0__or4_1( A1, A2, A3, A4, Z );
input A1, A2, A3, A4;
output Z;

	or MGM_BG_0( Z, A1, A2, A3, A4 );

endmodule
module gf180mcu_fd_sc_mcu7t5v0__or4_2( A1, A2, A3, A4, Z );
input A1, A2, A3, A4;
output Z;

	or MGM_BG_0( Z, A1, A2, A3, A4 );

endmodule
module gf180mcu_fd_sc_mcu7t5v0__or4_4( A4, A3, A2, A1, Z );
input A1, A2, A3, A4;
output Z;

	or MGM_BG_0( Z, A1, A2, A3, A4 );

endmodule
module gf180mcu_fd_sc_mcu7t5v0__tieh( Z );
output Z;

	assign Z = 1'b1;

endmodule
module gf180mcu_fd_sc_mcu7t5v0__tiel( ZN );
output ZN;

	assign ZN = 1'b0;

endmodule
module gf180mcu_fd_sc_mcu7t5v0__xnor2_1( A2, A1, ZN );
input A1, A2;
output ZN;

	wire ZN_row1;

	and MGM_BG_0( ZN_row1, A1, A2 );

	wire A1_inv_for_gf180mcu_fd_sc_mcu7t5v0__xnor2_1;

	not MGM_BG_1( A1_inv_for_gf180mcu_fd_sc_mcu7t5v0__xnor2_1, A1 );

	wire A2_inv_for_gf180mcu_fd_sc_mcu7t5v0__xnor2_1;

	not MGM_BG_2( A2_inv_for_gf180mcu_fd_sc_mcu7t5v0__xnor2_1, A2 );

	wire ZN_row2;

	and MGM_BG_3( ZN_row2, A1_inv_for_gf180mcu_fd_sc_mcu7t5v0__xnor2_1, A2_inv_for_gf180mcu_fd_sc_mcu7t5v0__xnor2_1 );

	or MGM_BG_4( ZN, ZN_row1, ZN_row2 );

endmodule
module gf180mcu_fd_sc_mcu7t5v0__xnor2_2( A2, A1, ZN );
input A1, A2;
output ZN;

	wire ZN_row1;

	and MGM_BG_0( ZN_row1, A1, A2 );

	wire A1_inv_for_gf180mcu_fd_sc_mcu7t5v0__xnor2_2;

	not MGM_BG_1( A1_inv_for_gf180mcu_fd_sc_mcu7t5v0__xnor2_2, A1 );

	wire A2_inv_for_gf180mcu_fd_sc_mcu7t5v0__xnor2_2;

	not MGM_BG_2( A2_inv_for_gf180mcu_fd_sc_mcu7t5v0__xnor2_2, A2 );

	wire ZN_row2;

	and MGM_BG_3( ZN_row2, A1_inv_for_gf180mcu_fd_sc_mcu7t5v0__xnor2_2, A2_inv_for_gf180mcu_fd_sc_mcu7t5v0__xnor2_2 );

	or MGM_BG_4( ZN, ZN_row1, ZN_row2 );

endmodule
module gf180mcu_fd_sc_mcu7t5v0__xnor2_4( A2, A1, ZN );
input A1, A2;
output ZN;

	wire ZN_row1;

	and MGM_BG_0( ZN_row1, A1, A2 );

	wire A1_inv_for_gf180mcu_fd_sc_mcu7t5v0__xnor2_4;

	not MGM_BG_1( A1_inv_for_gf180mcu_fd_sc_mcu7t5v0__xnor2_4, A1 );

	wire A2_inv_for_gf180mcu_fd_sc_mcu7t5v0__xnor2_4;

	not MGM_BG_2( A2_inv_for_gf180mcu_fd_sc_mcu7t5v0__xnor2_4, A2 );

	wire ZN_row2;

	and MGM_BG_3( ZN_row2, A1_inv_for_gf180mcu_fd_sc_mcu7t5v0__xnor2_4, A2_inv_for_gf180mcu_fd_sc_mcu7t5v0__xnor2_4 );

	or MGM_BG_4( ZN, ZN_row1, ZN_row2 );

endmodule
module gf180mcu_fd_sc_mcu7t5v0__xnor3_1( A2, A1, A3, ZN );
input A1, A2, A3;
output ZN;

	wire A3_inv_for_gf180mcu_fd_sc_mcu7t5v0__xnor3_1;

	not MGM_BG_0( A3_inv_for_gf180mcu_fd_sc_mcu7t5v0__xnor3_1, A3 );

	wire ZN_row1;

	and MGM_BG_1( ZN_row1, A3_inv_for_gf180mcu_fd_sc_mcu7t5v0__xnor3_1, A1, A2 );

	wire A2_inv_for_gf180mcu_fd_sc_mcu7t5v0__xnor3_1;

	not MGM_BG_2( A2_inv_for_gf180mcu_fd_sc_mcu7t5v0__xnor3_1, A2 );

	wire ZN_row2;

	and MGM_BG_3( ZN_row2, A2_inv_for_gf180mcu_fd_sc_mcu7t5v0__xnor3_1, A1, A3 );

	wire A1_inv_for_gf180mcu_fd_sc_mcu7t5v0__xnor3_1;

	not MGM_BG_4( A1_inv_for_gf180mcu_fd_sc_mcu7t5v0__xnor3_1, A1 );

	wire ZN_row3;

	and MGM_BG_5( ZN_row3, A1_inv_for_gf180mcu_fd_sc_mcu7t5v0__xnor3_1, A2, A3 );

	wire ZN_row4;

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

	wire Z_row4;

	and MGM_BG_6( Z_row4, A1_inv_for_gf180mcu_fd_sc_mcu7t5v0__xor3_4, A2_inv_for_gf180mcu_fd_sc_mcu7t5v0__xor3_4, A3 );

	or MGM_BG_7( Z, Z_row1, Z_row2, Z_row3, Z_row4 );

endmodule
