F-Izcue-223/Proyecto-3-Arquitectura-de-Computadores/(commit log)

2026-10-28 Evidencia por sección del informe (3.1 a 3.7) y justificación de pines
2026-10-28 Configuración de LibreLane: config base, orden de pines y variantes (memoria FF, simulación corta)
    [pin_order.cfg]
2026-10-28 Evidencia curada de las corridas: métricas, STA, signoff, GDS y renders
    [metrics.csv, resumen_corridas.csv]
2026-10-28 RTL original de la FPGA (Proyecto 2), sin modificar, usado para los avisos de 3.1
2026-10-28 RTL del ASIC: asic_top, SoC, memoria ROM o FF y núcleo Espino con comparador de saltos
2026-10-28 Scripts de corridas, barridos de reloj y utilización, métricas y exportación
2026-10-28 Programa de prueba de instrucciones del Espino (isa_test.s)
2026-10-28 Testbenches y simulación post-síntesis con la netlist GF180
2026-10-28 Programa del juego de reflejos (game.s) con constantes para 10 MHz
2026-10-28 Fija finales de línea de los .sh
2026-10-28 Ignora corridas completas de LibreLane y archivos generados
2026-10-28 README: instalación de LibreLane, versiones exactas y comandos de cada punto
2026-10-28 Restricciones de pines de la FPGA GoBoard (Proyecto 2), de referencia
2026-10-28 Versiones de OpenROAD, Yosys, Magic y Netgen de la imagen de LibreLane
2026-11-03 Informe del Proyecto 3 en LaTeX y figuras del barrido de reloj y de utilizacion
2026-11-03 Guia de comandos para la defensa
2026-11-04 Informe final corregido, README y evidencias con rutas del repo, logs de run0 y run0b
